netik/dc27_badge/hardware/dc27_badge_kicad/macrofab/README.md

###KiCad
***
**KiCad Libraries and documentation.**

This directory contains the files needed to generate manufacturing data from KiCad V4.0 and up for MacroFab, INC.

Please see the KiCad documentation at the [knowledge base](https://beta.macrofab.net/help/kpdink) on MacroFab, INC. for more information. 

***
**License Information**

This project is under the [Creative Commons Attribution-ShareAlike 4.0 International License](LICENSE.md). These files are provided with no warranty and should be used at your own risk. 

***
| Directory | Description |
|---|---|
| Footprints | Macrofab Footprint Libraries in Kicad format | 
| Schematics | Macrofab Schematic Symbol Libraries in Kicad format |

***
