netik/dc27_badge/hardware/pins_nRF52840DK.txt

NRF52840 DK board pin connections

This is the I/O pinout for the Nordic nRF52840 DK (development kit board).
There is also a Rigado BMD-340 EVAL board which is basically the same,
except it has the BMD-340 module mounted while the Nordic board just has
a bare nRF52840 chip mounted. Functionally they are identical.

Notes:

- Rigado and Nordic both have their own development boards. The Nordic
  one has the nRF52840 chip mounted directly on it. The Rigado board
  has the Rigado BMD-340 module on it instead. But both use the same
  headers and peripherals, so from a software perspective they should
  be identical.

- The nRF52840 has an extra bank of 16 GPIO pins, for a total of 48. These
  pins are accessed via a separate register block at offset 0x50000300. In
  ChibiOS these are referenced as IOPORT1 and IOPORT2. These are shown as two
  separate tables below.

- The connections shown below currently reflect only what's on the dev
  board. No extra peripherals have been configured yet.

- In order to allow peripherals to be able to select from all 48 pins for
  their I/O configuration, the pin select registers now have an extra field.
  The lowest 5 bits (0 to 4) select the pin number (0-31) and the 6th bit
  (bit 5) selects which port to use.

- Unlike the nRF52832 dev boards, the nRF52840 boards have a QSPI flash
  part connected to 6 pins (CS, clock and 4 I/O lines). The user guide
  document tays this is a 64Mb part. This actually means 64 megabits.
  That translates to 8MB. When properly configured, the nRF52840 allows
  code to be executed from the QSPI flash device. The QSPI is can also be
  memory-mapped. however the Nordic chip only allows a limited amount of
  address space to be used for this purpose which restricts the mapped
  range to about 128MB. This does not preculude the use of QSPI parts
  larger than that, since read access can still be performed via the
  QSPI controller inteface -- it just means that only 128MB may be
  visible via the memory-mapped method.

- The NRF52 chip has two places where you can connect crystals:

  1) Two dedicated pins for a 32MHz crystal
  2) The pins for P0.00 and P0.01, which can be used with a 32.768KHz
     crystal

  The chip has both a high speed clock and low speed clock. The 32MHz
  crystal is always required for the high speed clock. This same clock
  is used for the ARM CPU core and bus clocks. The low speed clock
  has three possible sources:

  1) Internal RC oscillator
  2) External 32.768KHz crystal
  3) Synthesized from 32MHz clock

  For certain applications, like if you use the ANT stack, you are
  required to use a 32.768KHz crystal for the low speed clock. The Nordic
  and Rigado reference boards come with this crystal too. However for
  our application (just using plain BLE), we technically don't need
  this extra crystal: we can make do with just the 32MHz crystal for
  the high speed clock. Note that the Rigado BMD-340 has the 32MHz
  crystal inside the module while the Nordic reference design has
  it on the main board instead.

  Joypads: There are two 5 input joypads. One on the tail section (aka
  the "A" stick) and one on the "business end" of the bomb, aka the
  "B" stick. Pushing down on either stick activates SELECT.

  All switches are tied to ~JOYPAD_INTR with Schottky diodes for low
  forward-voltage loss when activated. 

Port P0

NRF52840 pin desgination		Function
------------------------		--------
P0.00					XTAL (32.768KHz)
P0.01					XTAL (32.768KHz)
P0.02					Audio amp shutdown
P0.03					Touch CS
P0.04					Screen C/D
P0.05					UART_RTS
P0.06					UART_TX
P0.07					UART_CTS
P0.08					UART_RX
P0.09					NFC antenna
P0.10					NFC antenna
P0.11					BTN1 (~A:up)
P0.12					BTN2 (~A:down)
P0.13					LED1 / SD Card CS
P0.14					LED2 (Also routed to Shitty-add-on GPIO1)
P0.15					LED3 (Also routed to Shitty-add-on GPIO2)
P0.16					LED4
P0.17					QSPI CS
P0.18					RESET
P0.19					QSPI CLK
P0.20					QSPI DIO0
P0.21					QSPI DIO1
P0.22					QSPI DIO2
P0.23					QSPI DIO3
P0.24					BTN3 (~A:left)
P0.25					BTN4 (~A:right)
P0.26					I2C SCK
P0.27					I2C SDA
P0.28					SPI SCK (Screen)
P0.29					SPI MISO (Screen)
P0.30					SPI MOSI (Screen)
P0.31					Screen CS

Port P1

NRF52840 pin desgination		Function
------------------------		--------
P1.00					<unused>
P1.01					I2S SDOUT
P1.02					I2S SCK
P1.03					I2S LRCK
P1.04					I2S MCK
P1.05					<unused>
P1.06					SPI SCK (SD/touch)
P1.07					SPI MISO (SD/touch)
P1.08					SPI MOSI (SD/touch)
P1.09					BTN5 (~B:up)
P1.10					BTN6 (~B:down)
P1.11					BTN7 (~B:left)
P1.12					BTN8 (~B:right)
P1.13					BTN9 (~A:SELECT)
P1.14					BTN10 (~B:SELECT)
P1.15					~JOYPAD_INTR

For the ER-TFTM028-4 screen module

NRF52840 GPIO pin	ER-TFTM028-4 display/touch/SD module pin
-----------------	-----------------------------------------------------
P0.31			pin 23			(Screen chip select)
P0.30			pin 27			(SPI bus out -- screen)
P0.29			pin 28			(SPI bus in -- screen)
P0.28			pin 24			(SPI bus clock -- screen)
P1.08			pin 34			(SPI bus out -- SD/touch)
P1.07			pin 32			(SPI bus in -- SD/touch)
P1.06			pin 33			(SPI bus clock -- SD/touch)
GND (header P1)		pin 1 and 40		(Ground)
VDD (header P1)		pin 2			(3.3v VCC)
P0.04			pin 25			(Screen data/command select)
P0.03			pin 30			(Touch chip select)
P0.13			pin 35			(SD card chip select)
