netik/dc27_badge/artwork/evil bomb.jpg

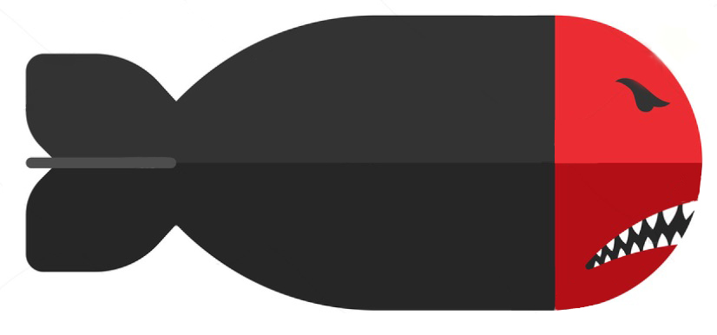
artwork/evil bomb.jpg
