netik/dc27_badge/artwork/idea board/1366668407.png

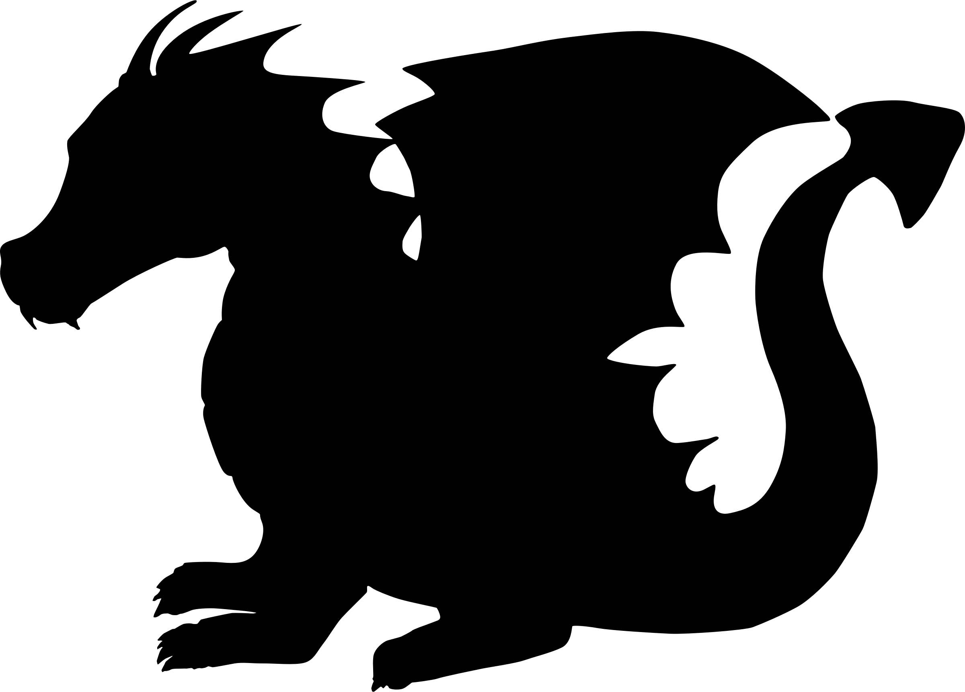
artwork/idea board/1366668407.png
