netik/dc27_badge/artwork/idea board/ancient-greek-trireme-black-and-whi_gg86042555.jpg

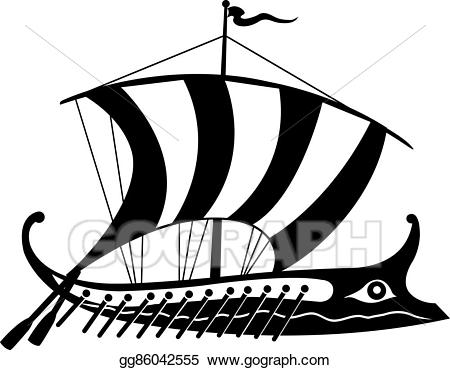
artwork/idea board/ancient-greek-trireme-black-and-whi_gg86042555.jpg
