netik/dc27_badge/artwork/idea board/Armies_and_Tactics__Ancient_Greek_Navies_-_YouTube.jpg

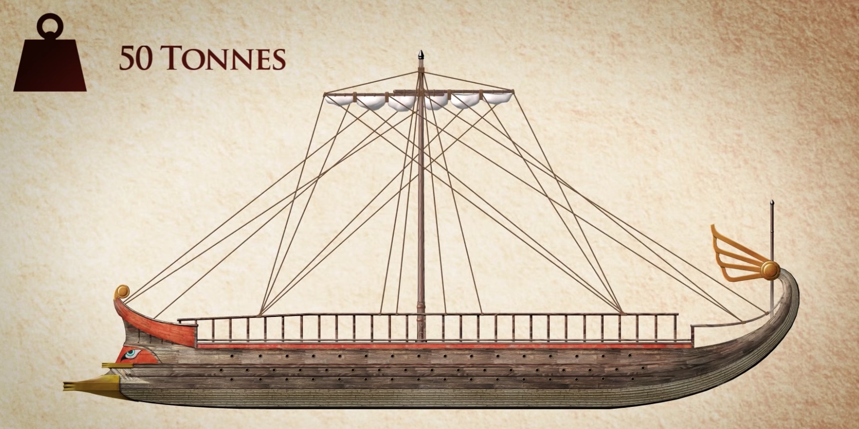
artwork/idea board/Armies_and_Tactics__Ancient_Greek_Navies_-_YouTube.jpg
