netik/dc27_badge/artwork/idea board/cool-skull-border-clip-art-skulls-thorn-vines-vector-decorative-border-stock-vector-skull-border-clip-art.jpg

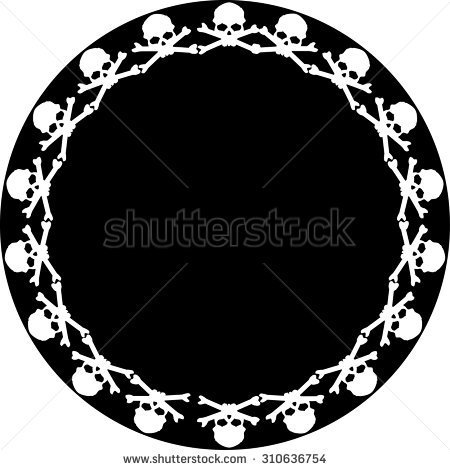
artwork/idea board/cool-skull-border-clip-art-skulls-thorn-vines-vector-decorative-border-stock-vector-skull-border-clip-art.jpg
