netik/dc27_badge/artwork/idea board/free-ships-silhouettes-vector-set.jpg

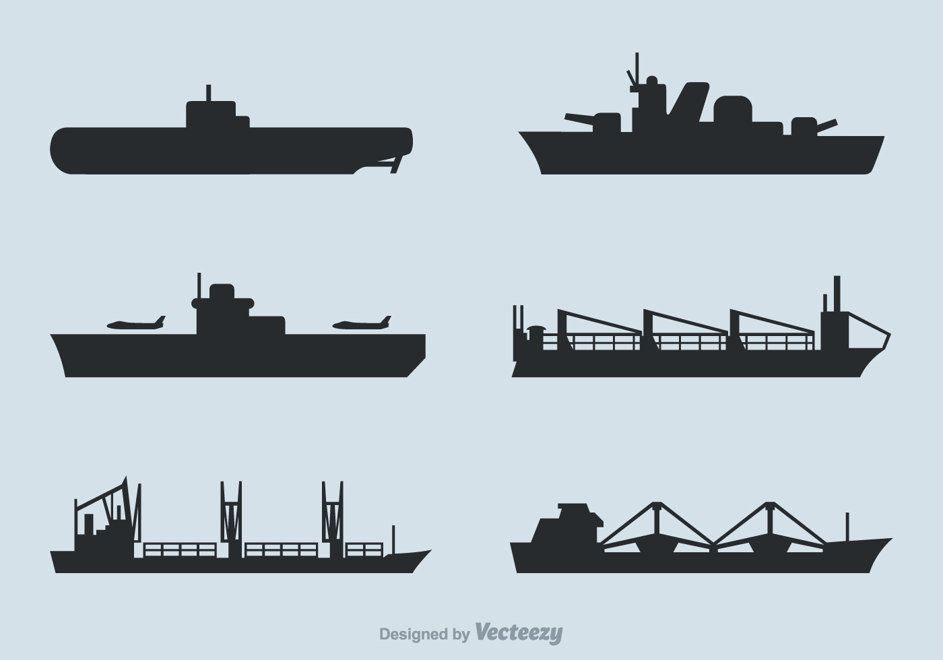
artwork/idea board/free-ships-silhouettes-vector-set.jpg
