netik/dc27_badge/artwork/idea board/images-3.png

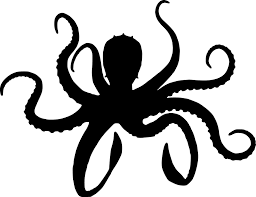
artwork/idea board/images-3.png
