netik/dc27_badge/artwork/idea board/images.jpg

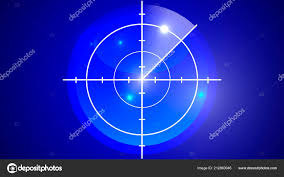
artwork/idea board/images.jpg
