netik/dc27_badge/artwork/idea board/submarine-dribbble.jpg

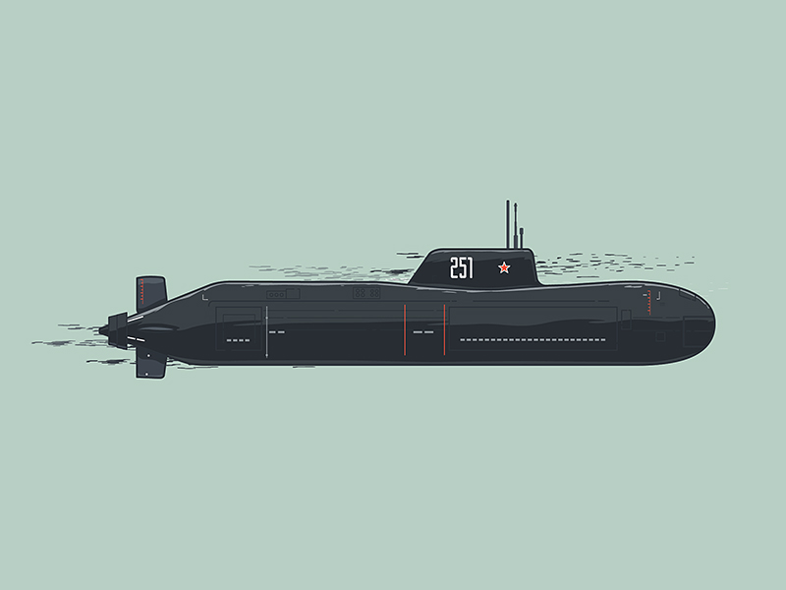
artwork/idea board/submarine-dribbble.jpg
