netik/dc27_badge/artwork/wiley-no bomb.jpg

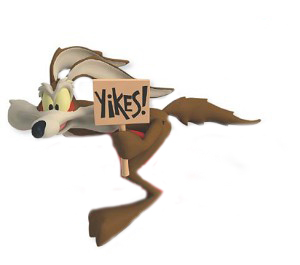
artwork/wiley-no bomb.jpg
