netik/dc27_badge/artwork/wiley.jpg

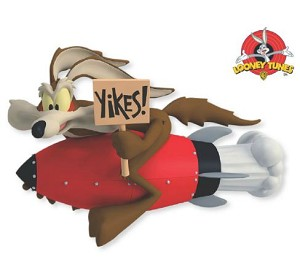
artwork/wiley.jpg
