netik/dc27_badge/Kickstarter/production schedule/production schedule.001.jpeg

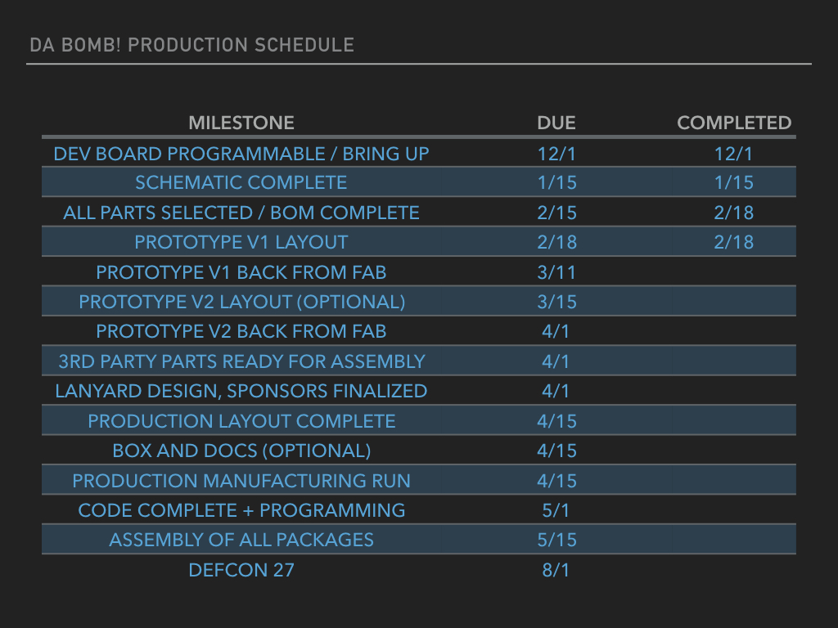
Kickstarter/production schedule/production schedule.001.jpeg
