netik/dc27_badge/Kickstarter/rendering.png

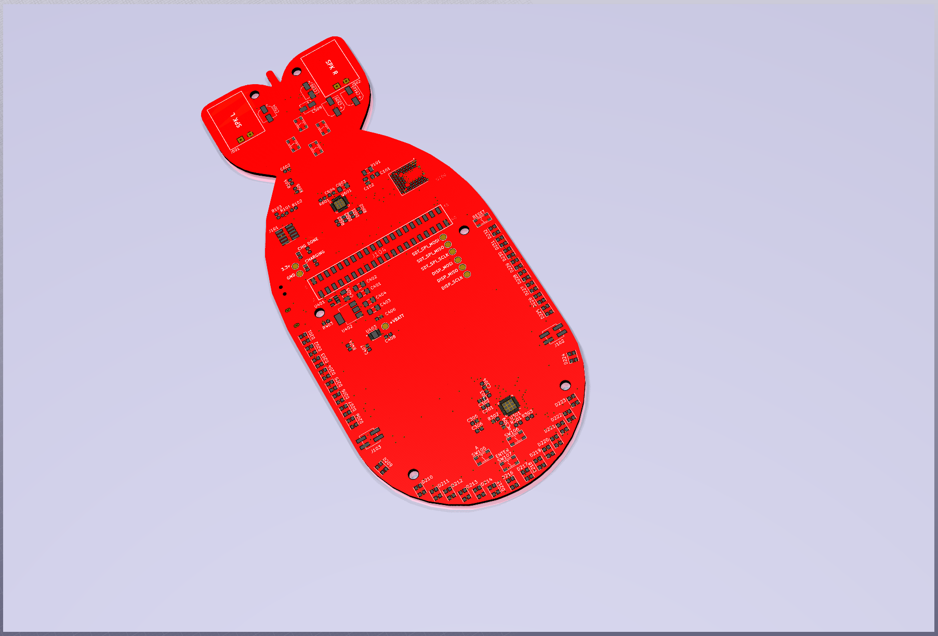
Kickstarter/rendering.png
