netik/dc27_badge/software/sd_card/jpg/doom/doom0005.jpg

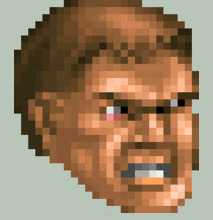
software/sd_card/jpg/doom/doom0005.jpg
