netik/dc27_badge/software/sd_card/jpg/doom/doom0037.jpg

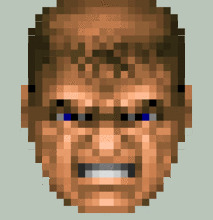
software/sd_card/jpg/doom/doom0037.jpg
