netik/dc27_badge/software/sd_card/jpg/doom/doom0043.jpg

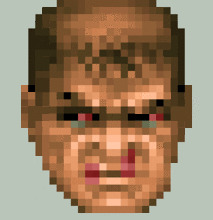
software/sd_card/jpg/doom/doom0043.jpg
