netik/dc27_badge/software/sd_card/jpg/doom/doom0062.jpg

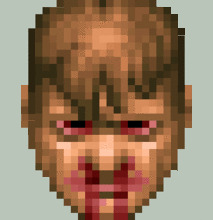
software/sd_card/jpg/doom/doom0062.jpg
