netik/dc27_badge/software/sd_card/jpg/doom/doom0073.jpg

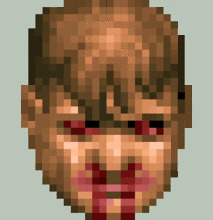
software/sd_card/jpg/doom/doom0073.jpg
