netik/dc27_badge/software/sd_card/jpg/doom/doom0083.jpg

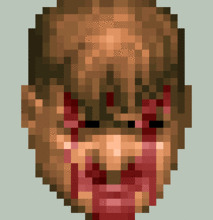
software/sd_card/jpg/doom/doom0083.jpg
