netik/dc27_badge/software/sd_card/jpg/doom/doom0093.jpg

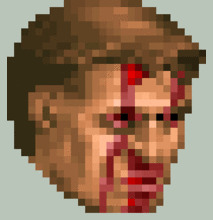
software/sd_card/jpg/doom/doom0093.jpg
