netik/dc27_badge/software/sd_card/jpg/fwupdate.jpg

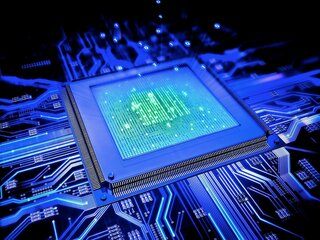
software/sd_card/jpg/fwupdate.jpg
