netik/dc27_badge/software/sd_card/jpg/undrattk.jpg

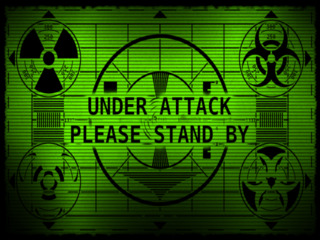
software/sd_card/jpg/undrattk.jpg
