netik/dc27_badge/software/sd_card/photos_src/alert.tif

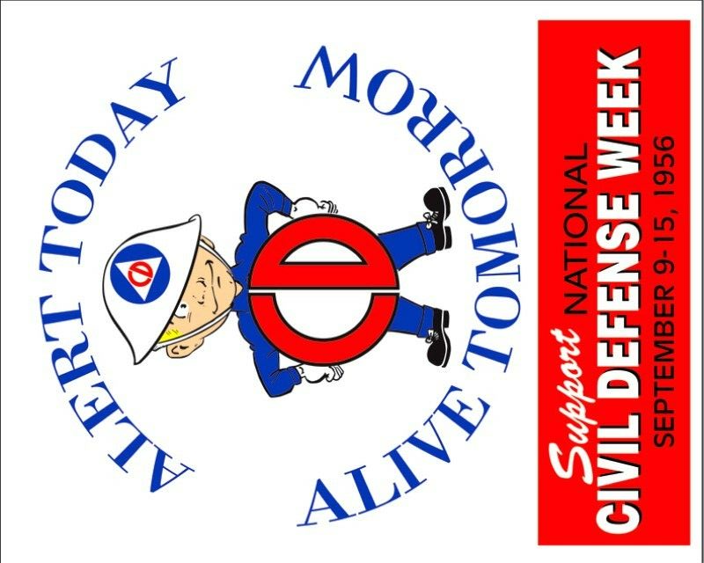
software/sd_card/photos_src/alert.tif
