netik/dc27_badge/software/sd_card/photos_src/civildef.tif

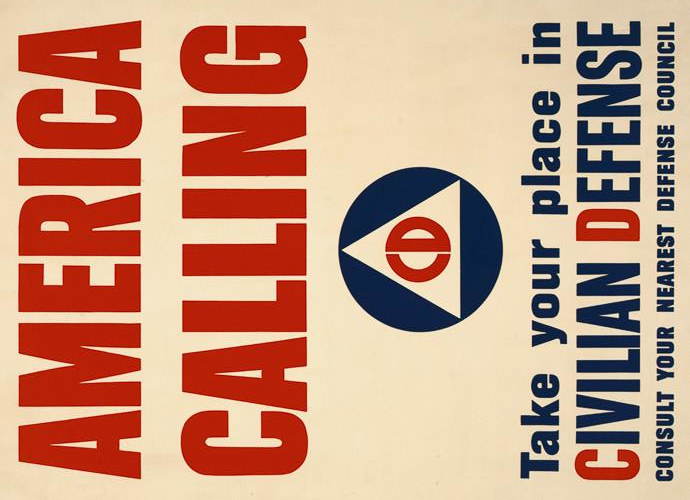
software/sd_card/photos_src/civildef.tif
