netik/dc27_badge/software/sd_card/photos_src/comic.tif

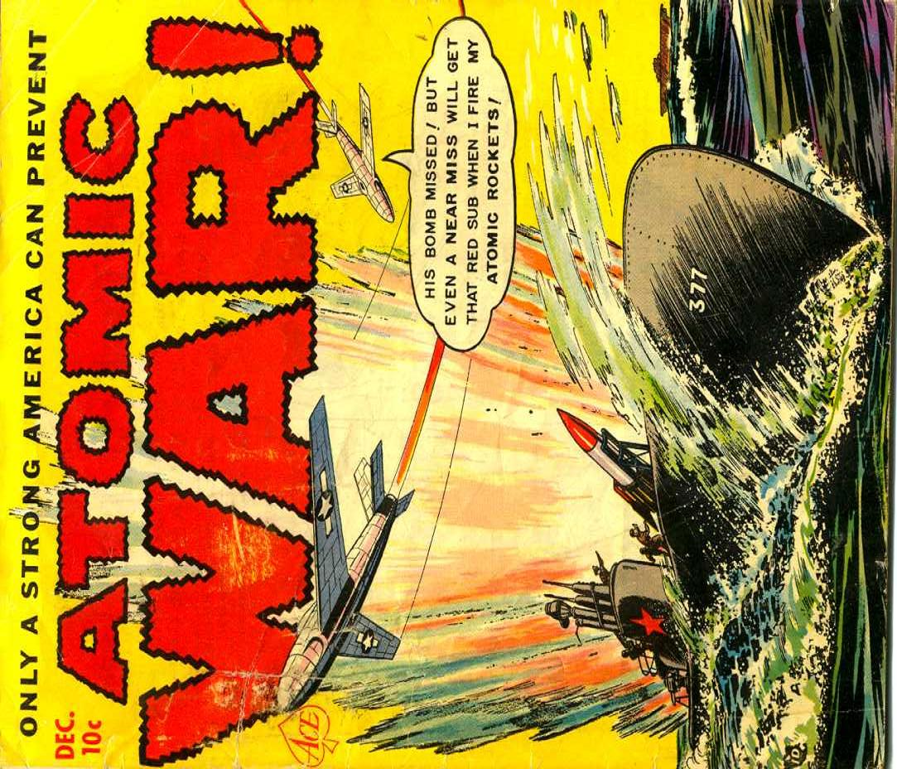
software/sd_card/photos_src/comic.tif
