netik/dc27_badge/software/sd_card/photos_src/dixiecup.tif

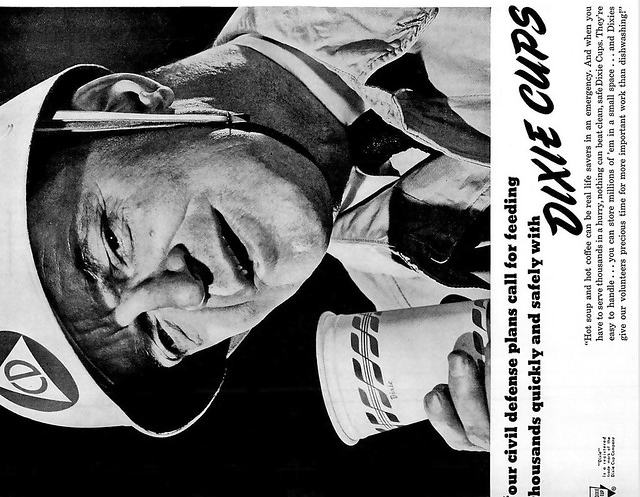
software/sd_card/photos_src/dixiecup.tif
