netik/dc27_badge/software/sd_card/photos_src/fallout.tif

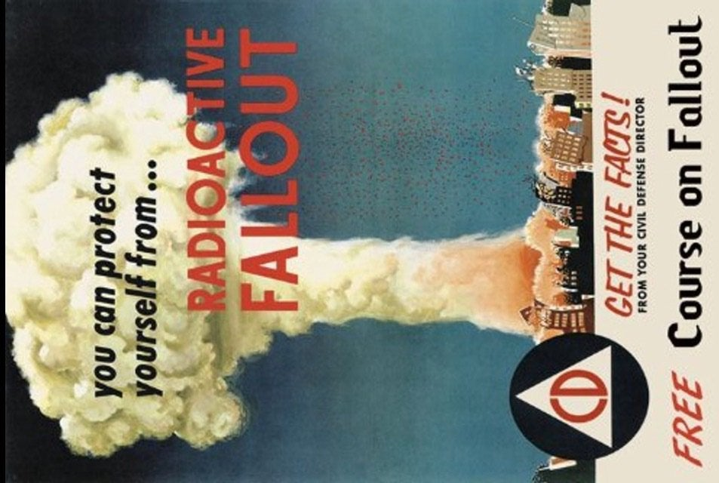
software/sd_card/photos_src/fallout.tif
