netik/dc27_badge/software/sd_card/photos_src/lowpot.jpg

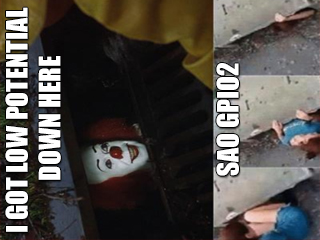
software/sd_card/photos_src/lowpot.jpg
