netik/dc27_badge/software/sd_card/photos_src/protect.tif

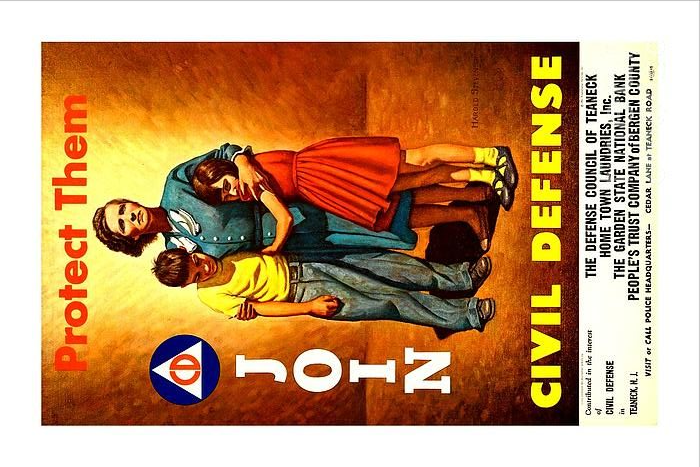
software/sd_card/photos_src/protect.tif
