netik/dc27_badge/software/sd_card/photos_src/saodrake.jpg

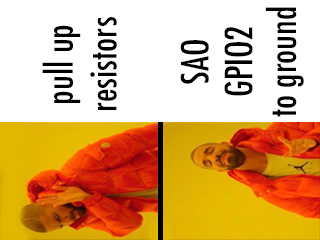
software/sd_card/photos_src/saodrake.jpg
