netik/dc27_badge/software/sd_card/photos_src/shelter.tif

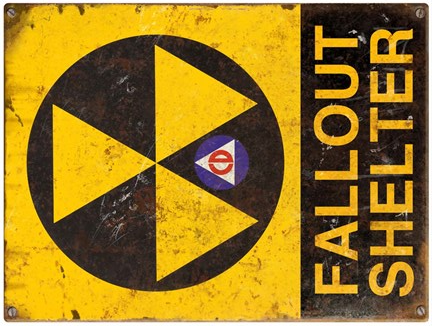
software/sd_card/photos_src/shelter.tif
