netik/dc27_badge/software/sd_card/photos_src/staydown.tif

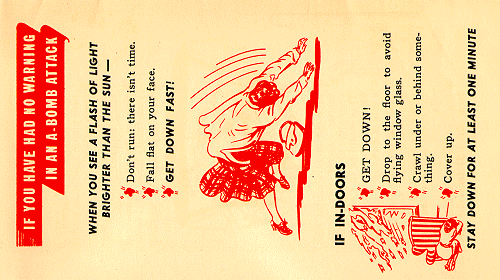
software/sd_card/photos_src/staydown.tif
