netik/dc27_badge/software/sd_card/tif/game/map-01.tif

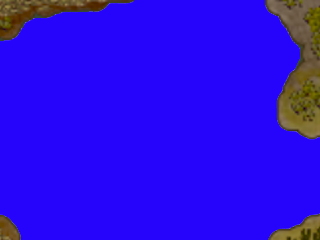
software/sd_card/tif/game/map-01.tif
