netik/dc27_badge/software/sd_card/tif/game/map-02.tif

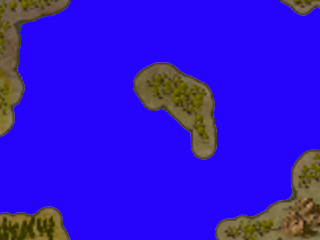
software/sd_card/tif/game/map-02.tif
