netik/dc27_badge/software/sd_card/tif/game/map-04.tif

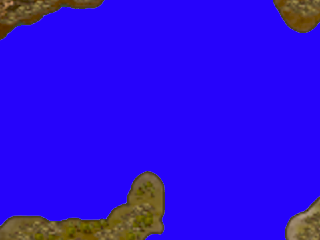
software/sd_card/tif/game/map-04.tif
