netik/dc27_badge/software/sd_card/tif/game/map-11.tif

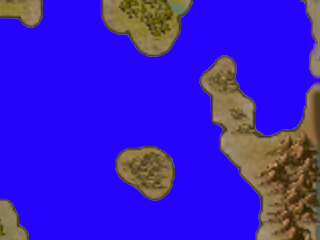
software/sd_card/tif/game/map-11.tif
