netik/dc27_badge/software/sd_card/tif/game/seabattle-4x4-map.tif

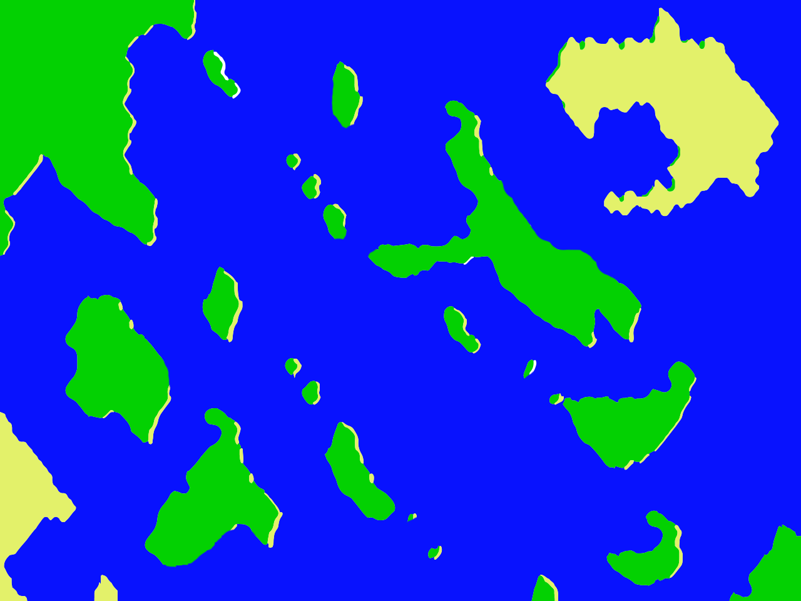
software/sd_card/tif/game/seabattle-4x4-map.tif
