netik/dc27_badge/software/sd_card/tif/images/credits.tif

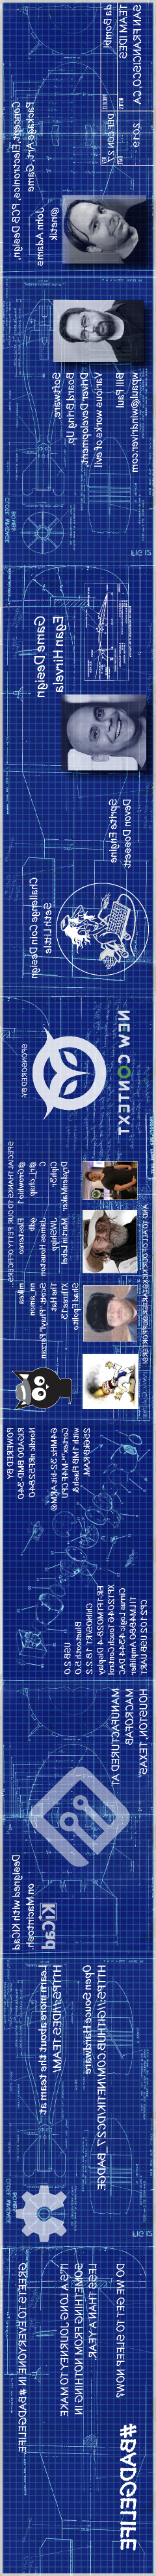
software/sd_card/tif/images/credits.tif
