netik/dc27_badge/software/sd_card/tif/images/invite.tif

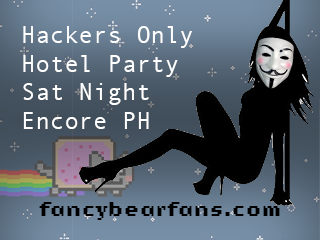
software/sd_card/tif/images/invite.tif
