netik/dc27_badge/software/sd_card/tif/images/missing.tif

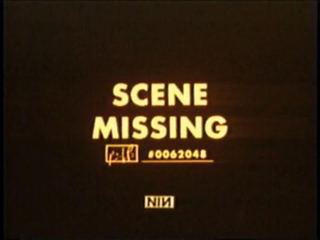
software/sd_card/tif/images/missing.tif
