netik/dc27_badge/software/sd_card/tif/images/nophotos.tif

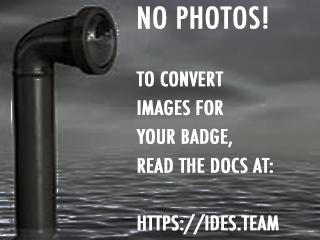
software/sd_card/tif/images/nophotos.tif
