netik/dc27_badge/software/sd_card/tif/images/sponsor.tif

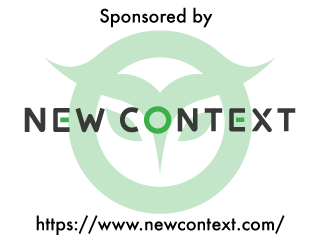
software/sd_card/tif/images/sponsor.tif
