netik/dc27_badge/software/sd_card/tif/images/unlock.tif

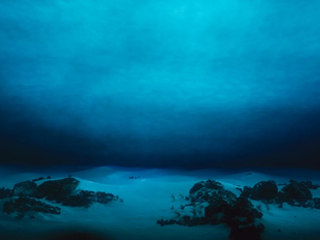
software/sd_card/tif/images/unlock.tif
