netik/dc27_badge/artwork/evilbomb_outline.dxf

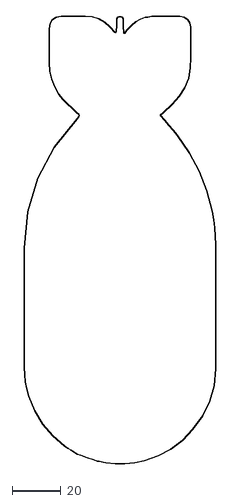
[picture p79: CAD file, 2019-03-21]
artwork/evilbomb_outline.dxf
79.1 x 184.5
