netik/dc27_badge/artwork/evilbomb-face.dxf

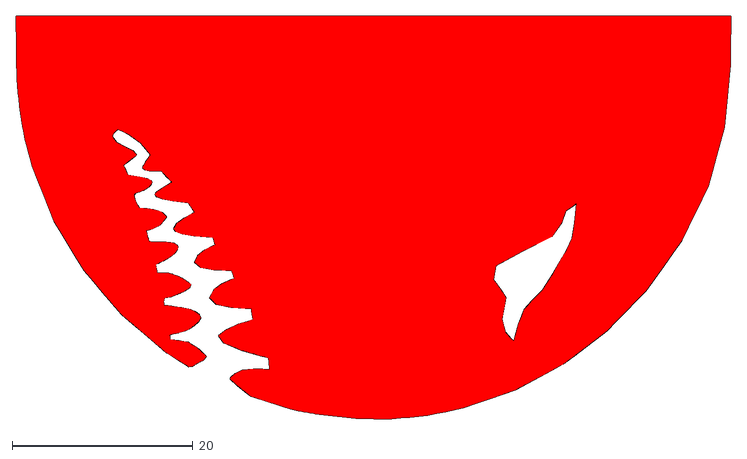
[picture p80: CAD file, 2019-03-21]
artwork/evilbomb-face.dxf
78.9 x 44.5
