netik/dc27_badge/software/sd_card/photos_src/howto.tif

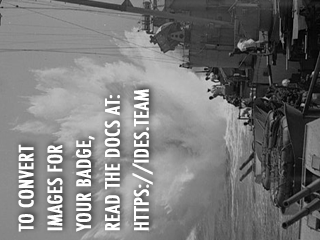
software/sd_card/photos_src/howto.tif
