netik/dc27_badge/software/firmware/todo.txt

Things currently completed:

- OS bootstrap
- uGFX porting
- FatFs porting
- Nordic SoftDevice (BLE stack) porting
- BLE radio GAP + L2CAP support
- BLE GATTS support
- Application framework from DC25 badge porting
- Bus master SPI controller driver
- QSPI controller driver
- I2S controller driver
- 320x240 display support
- SD card support
- Resistive touch controller support
- QSPI flash support (for 8MB MXIC flash chip on dev board)
- NRF52840 on-board flash support
- audio playback API
- Chat app 
- Firmware update app
- Firmware updater support
- Support for extra GPIO bank on NRF52840 chip
- joypad/button framework
- Put SD card/touch on a separate SPI bus (leave screen on SPIM4)
- I2C support (tested good)
- Video app
- Extend button support to handle extra buttons requested by John
- Music player app
- BLE GATTC support
- Setup app
- Geiger counter app
- RF spectrum display app
- I2C support
- LED array support
- Infocom Z-Machine support
- OTA firmware update support
- Game app

Things still to do:

- BLE pairing PIN support
