netik/dc27_badge/(threads)

Thread 1 (2019-03-21):

BMD340 should not have copper fill under the antenna

netik, 2019-03-21:
Remove PCB fill

netik, 2019-03-21:
Updated Keepout to "also keepout copper fills". Seems to have worked and verified on gerbers.

Closed 2019-03-21.

Thread 11 (2019-03-21):

CP2102 TX/RX Lights do not function at all.

netik, 2019-03-21:
I've checked the schematic and data sheet twice but I don't see any reason why these LEDs should not be functional.

The LEDs are facing the right way, the pins are correct, but GPIO0/1 on the CP2102 does nothing.

Will put this on a scope later and see if we're getting anything resembling voltage coming off the CP2102.

I feel like the GPIO lines might need configuring but the datasheet says they should show TX and RX status by default. What gives?

netik, 2019-03-21:
Goddammit:
https://www.silabs.com/community/interface/forum.topic.html/cp2102n-qfn24_rxttx-JCui

Apparently these GPIO pins need to be conf'd

netik, 2019-03-21:
There are standalone tools that we can give to MF or whomever...

https://www.silabs.com/products/mcu/programming-options

netik, 2019-03-21:
And this looks like the one for cp2102...
https://www.silabs.com/community/interface/forum.topic.html/cp2102n_command_line-s0yh

netik, 2019-04-26:
The Xpress Configuratior solves this problem but we need a way to do this in manufacturing

Closed 2019-06-06.

Thread 2 (2019-03-21):

There's no ON label on the switch. Add one. Towards fin is ON.

netik, 2019-03-21:
Fix this on Kicad Layout

netik, 2019-03-21:
Label added.

Closed 2019-03-21.

Thread 4 (2019-03-21):

~RESET line is not configured on new CPUs

netik, 2019-03-21:
Bill will figure out how to configure this register (PSELRESET0/PSELRESET1)

netik, 2019-03-21:
Bill figured this out, but now it needs to go into a script for programming in production.

Bill, what's the magic command?

Bill-Paul, 2019-03-23:
There is no magic command. There is only Zuul.
No, seriously: there is now some code in the main() function of the firmware that will check if the UICR->PSELRESET[] fields are set correctly, and if it'll reflash the UICR on the fly to fix it.

The only catch is that you have to reboot the target once after the update for the change to take effect (the CPU only samples UICR->PSELRESET[] at start-up). So basically the procedure is:

1) Flash the firmware
2) Boot up the badge
3) Watch for the message below:

SYSTEM START
Reset event (0x4): Soft reset
Nordic Semiconductor nRF52840 Variant: AAAA RAM: 256KB Flash: 1024KB
Device ID: DA788BE24D13B5BB
Compact kernel mode
Reset pin not configured, programming... Done.                 <----------
Priority levels 8
[...]

4) Optional: power cycle the board and check that the reset button now works.

Bill-Paul, 2019-03-23:
Fixed by commit 5664404ae0a65e35376aef35dee8ed855b5eee38

Closed 2019-03-23.

Thread 5 (2019-03-21):

U403 doesn't have a valid center ground

netik, 2019-03-21:

netik, 2019-03-21:
The thermal pad, and overall layout of u403 is no good. Do it again.

netik, 2019-04-07:
No Longer valid, U403 removed and fuel gauge removed.

Closed 2019-04-07.

Thread 6 (2019-03-21):

Entire fuel gauge circuit is completely wrong. Remove or retry.

netik, 2019-03-21:

netik, 2019-04-07:
Duplicate, removed.

Closed 2019-04-07.

Thread 7 (2019-03-21):

Charge lights are reversed (or labels on board are reversed)

netik, 2019-03-21:

Closed 2019-04-12.

Thread 22 (2019-04-26):

LED Brightness (progress bar) doesn't draw properly at startup of app-setup

netik, 2019-04-26:
This is a strange ugfx problem that I can't track down.

Closed 2019-05-08.

Thread 32 (2019-05-08):

Rotate LED-Sign Fonts and display 90 degress

netik, 2019-05-08:
The user will have the badge hanging from their neck most of the time by the fins.

Rotate the LED font so it scrolls up (towards the header pins) instead of L to R.

I'm busy with the game or I'd fix this.

Closed 2019-07-18.

Thread 37 (2019-06-07):

Sometimes the idle timer in app-setup fires way, way too early.

netik, 2019-06-07:
it is randomly exiting and this sucks.

netik, 2019-06-11:
this was a very dumb bug. fixed

Closed 2019-06-11.

Thread 49 (2019-07-23):

Rotate badge issues

netik, 2019-07-23:
Bug from LC:

"rotate badge .... doesn't (and the badge remains vertical) ... but led sign is horizontal with 'rotate badge' unchecked and vertical with it checked"

The only place we implemented rotate badge was in led sign, so I think this is a wontfix.

netik, 2019-07-23:
We're going to just change the text here to say something line "ROTATE SIGN" instead of rotate badge. I know that's not the right solution but it is all we can do right now.

Closed 2019-07-23.

Thread 51 (2019-07-23):

LEDs don't stay off when asked to stay off.

netik, 2019-07-23:
Bug from LC:

"any time leds are used (play music, credits, ble counter) while the led pattern is 'off' (and brightness is > 0) it will leave the leds on from the audio"

Closed 2019-07-23.

Thread 52 (2019-07-23):

Vertical vs Horizontal LED Sign

netik, 2019-07-23:
Bug from LC:

"one last one I found: the vertical led font doesn't have any character spacing, while the horizontal font does"
---

We can't really fix this because the SD card has been written out already, Can offer this later as a fix, very low priority.
