netik/dc27_badge/hardware/dc27_badge_kicad/DC27-badge.pdf

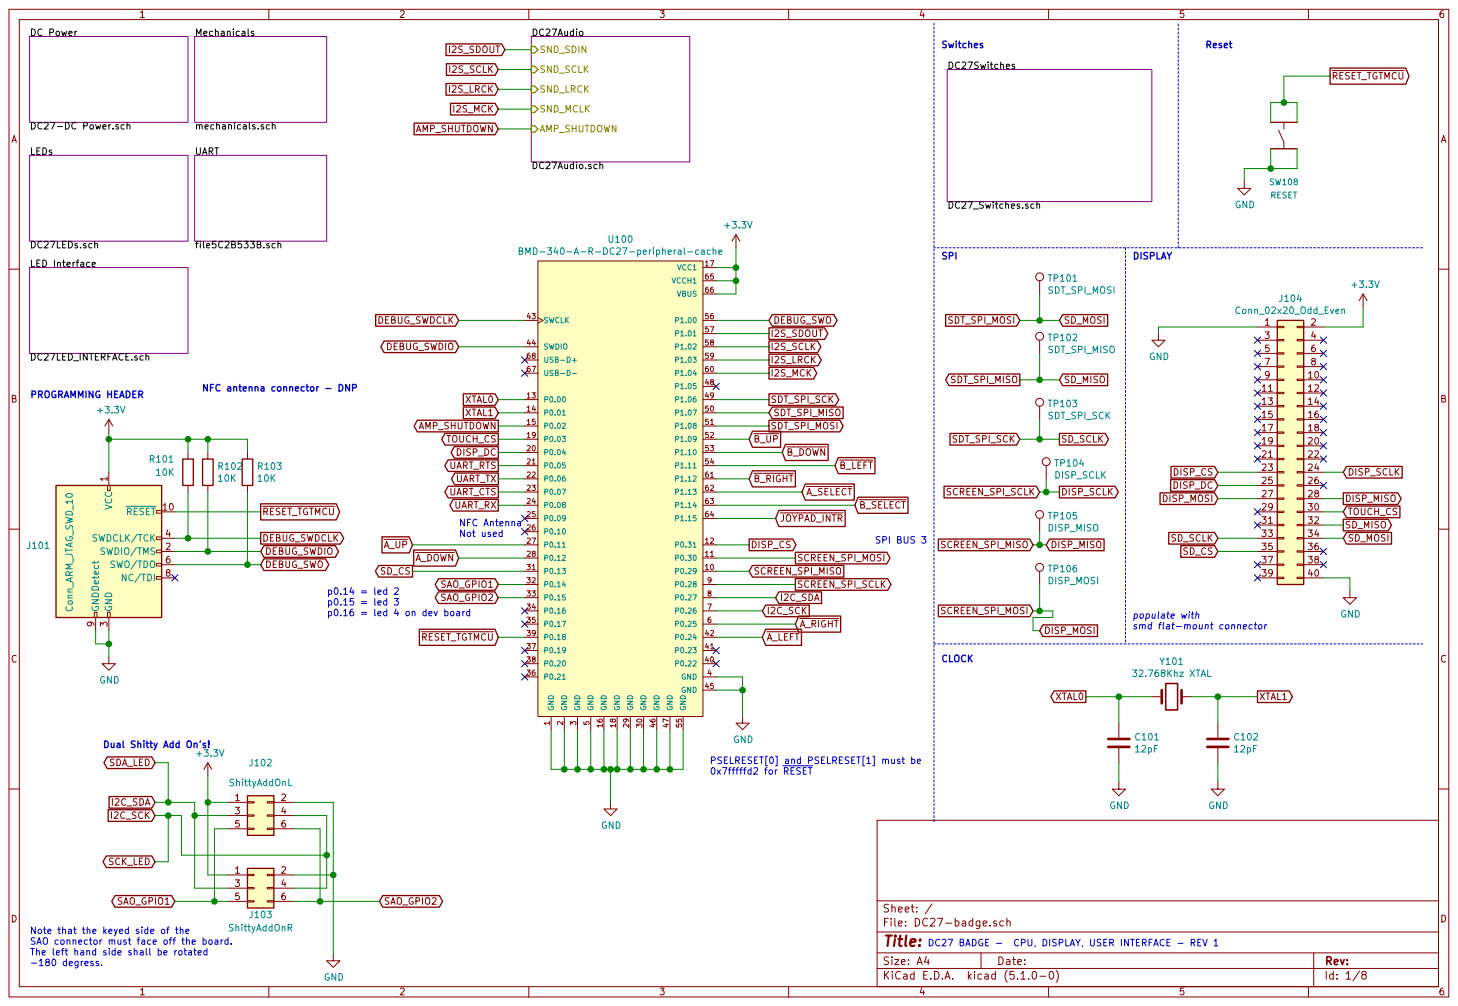
[picture p86: page 1]

SW108 RESET B_LEFT NFC antenna connector - DNP UART

5 P1.07 50 P1.08 51 P1.09 52 P1.10 53 P1.11 54 GND 55 P1.00 56 P1.01 57 P1.02 58 P1.03 59 P0.25 6 P1.04 60 P1.12 61 P1.13 62 P1.14 63 P1.15 64 VCCH1 65 VBUS 66 USB-D- 67 USB-D+ 68 P0.26 7 P0.27 8 P0.28 9 U100 BMD-340-A-R-DC27-peripheral-cache +3.3V
file5C2B533B.sch

3 GND 30 P0.13 31 P0.14 32 P0.15 33 P0.16 34 P0.17 35 P0.21 36 P0.19 37 P0.20 38 P0.18 39 GND 4 P0.22 40 P0.23 41 P0.24 42 SWCLK 43 SWDIO 44 GND 45 GND 46 GND 47 P1.05 48 P1.06 49 GND

p0.16 = led 4 on dev board AMP_SHUTDOWN

1 RESET 10 SWDIO/TMS 2 GND

3 SWDCLK/TCK 4 SWO/TDO 6 NC/TDI 8 GNDDetect 9

smd flat-mount connector RESET_TGTMCU

Dual Shitty Add Ons!
SDA_LED

PSELRESET[0] and PSELRESET[1] must be

File: DC27-badge.sch Sheet: /
Id: 1/8 Title:

Note that the keyed side of the SAO connector must face off the board. The left hand side shall be rotated

DC27 BADGE - CPU, DISPLAY, USER INTERFACE - REV 1

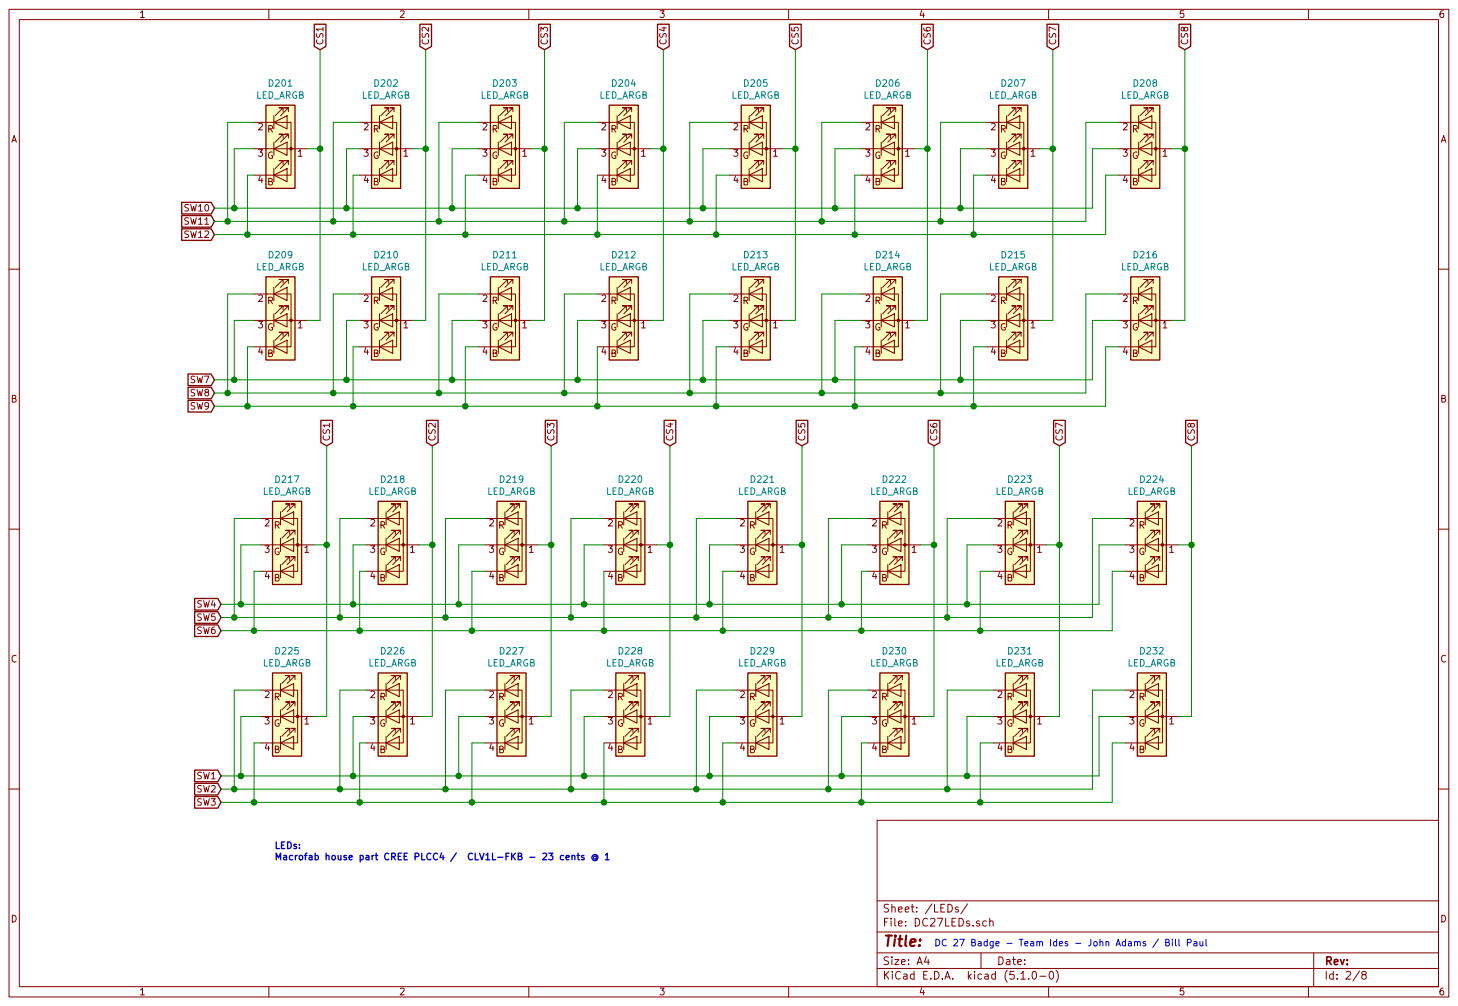
[picture p87: page 2]

Id: 2/8 Title: File: DC27LEDs.sch Sheet: /LEDs/ CS1 BG
LED_ARGB

DC 27 Badge - Team Ides - John Adams / Bill Paul

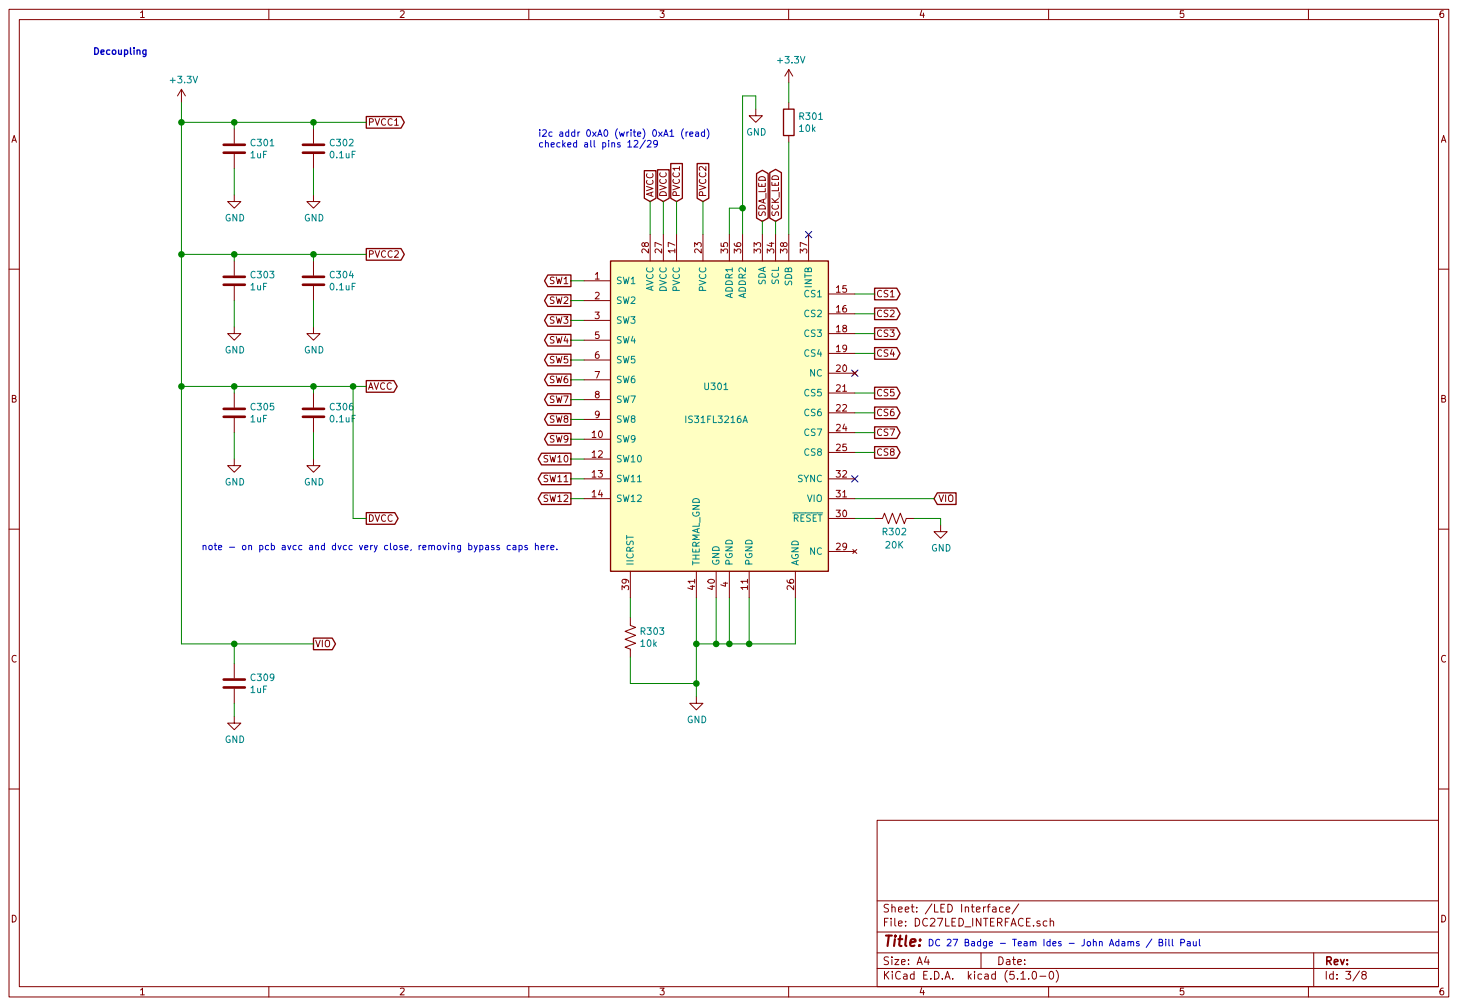
[picture p88: page 3]

note - on pcb avcc and dvcc very close, removing bypass caps here.

DC 27 Badge - Team Ides - John Adams / Bill Paul

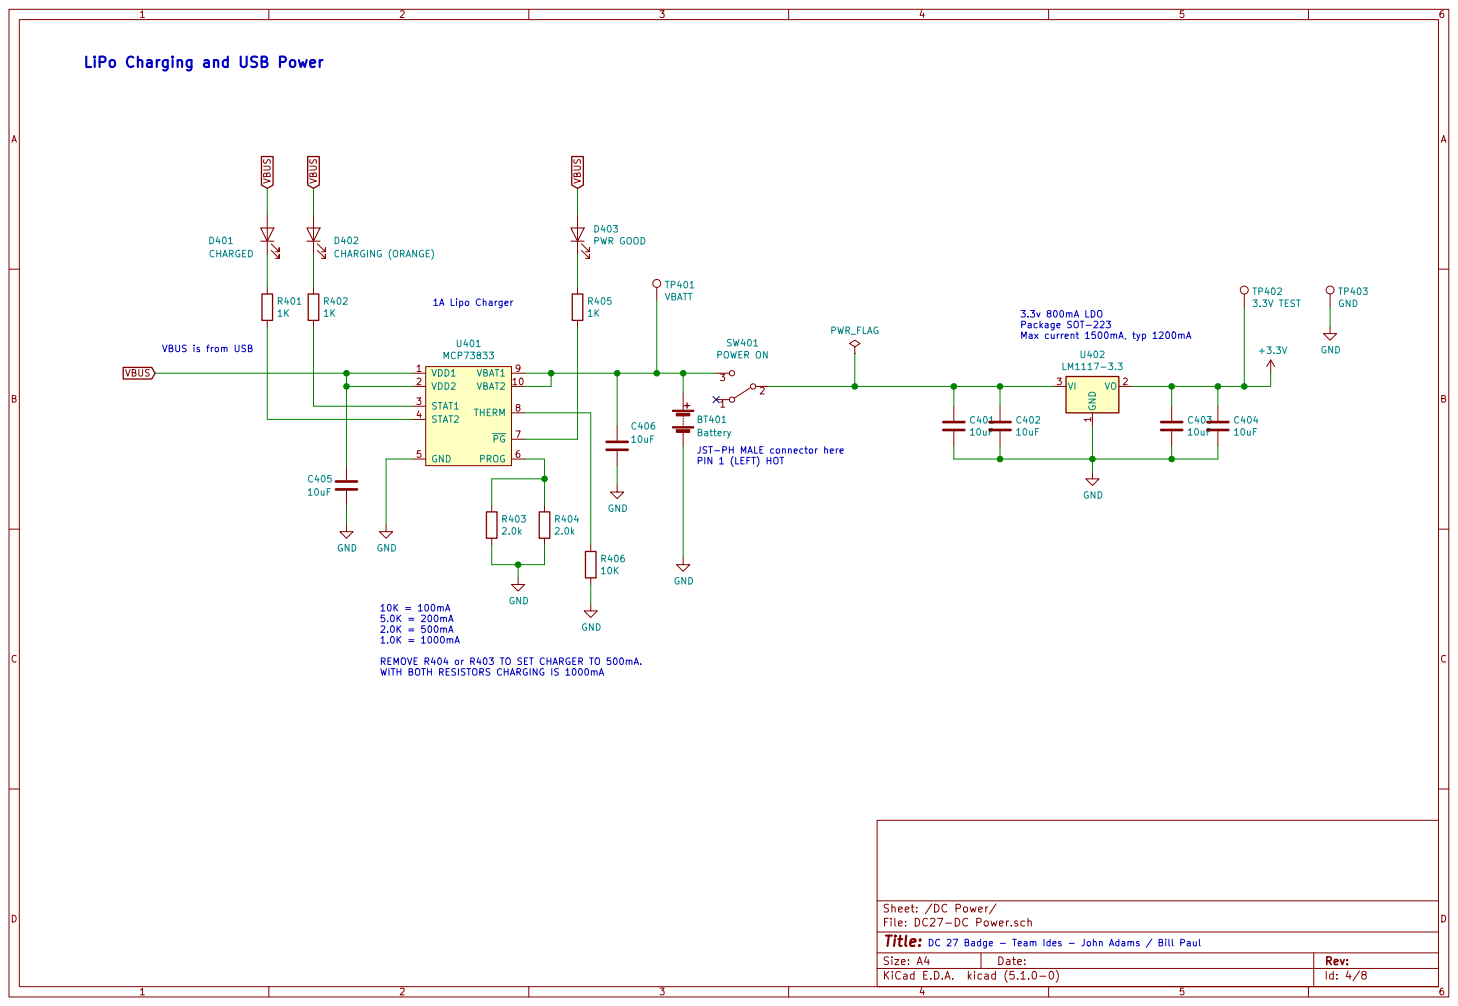
[picture p89: page 4]

LiPo Charging and USB Power

Id: 4/8 Title: File: DC27-DC Power.sch Sheet: /DC Power/

DC 27 Badge - Team Ides - John Adams / Bill Paul

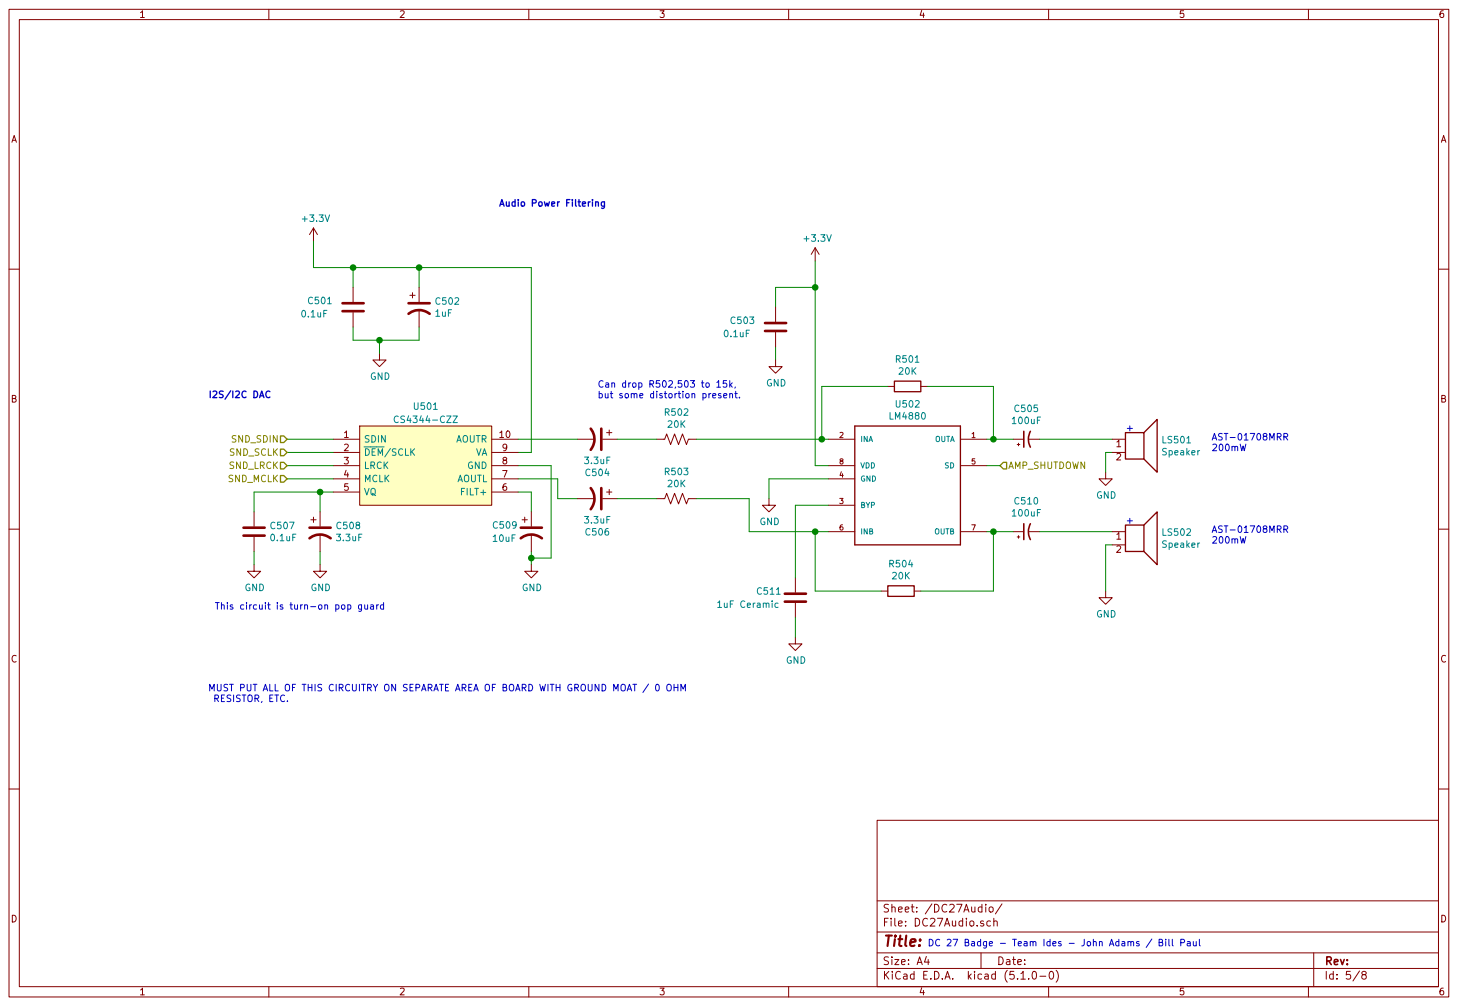
[picture p90: page 5]

Can drop R502,503 to 15k,
but some distortion present.

20K MUST PUT ALL OF THIS CIRCUITRY ON SEPARATE AREA OF BOARD WITH GROUND MOAT / 0 OHM

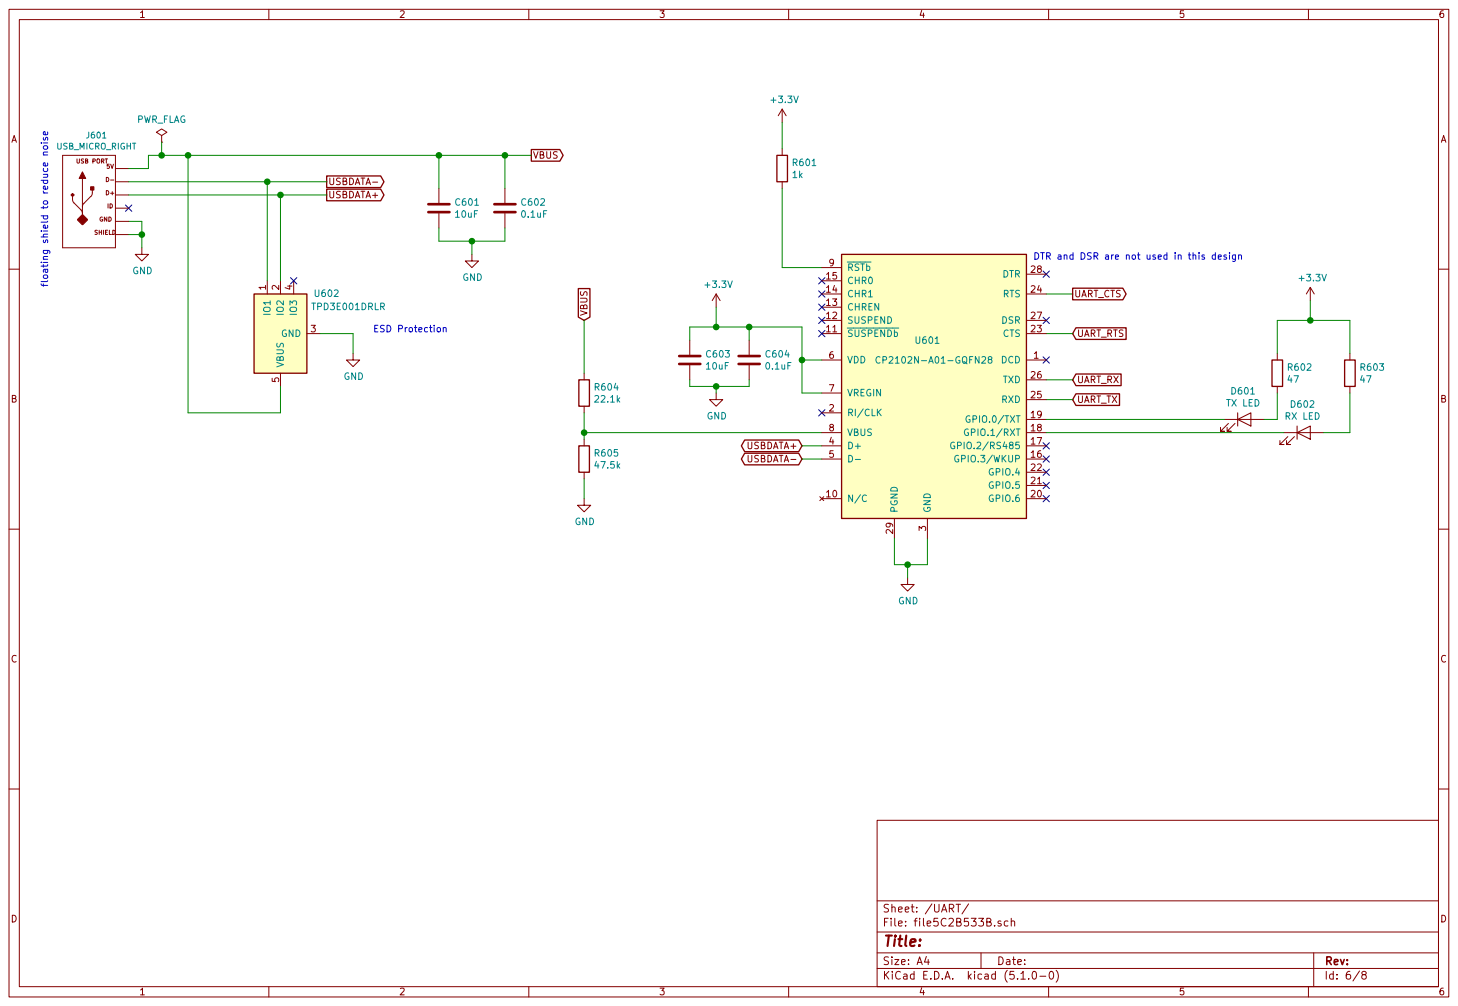
[picture p91: page 6]

3 D+ 4 D- 5 VDD 6 VREGIN 7 VBUS 8 RSTb 9 U601 CP2102N-A01-GQFN28 GND

Id: 6/8 Title: File: file5C2B533B.sch Sheet: /UART/

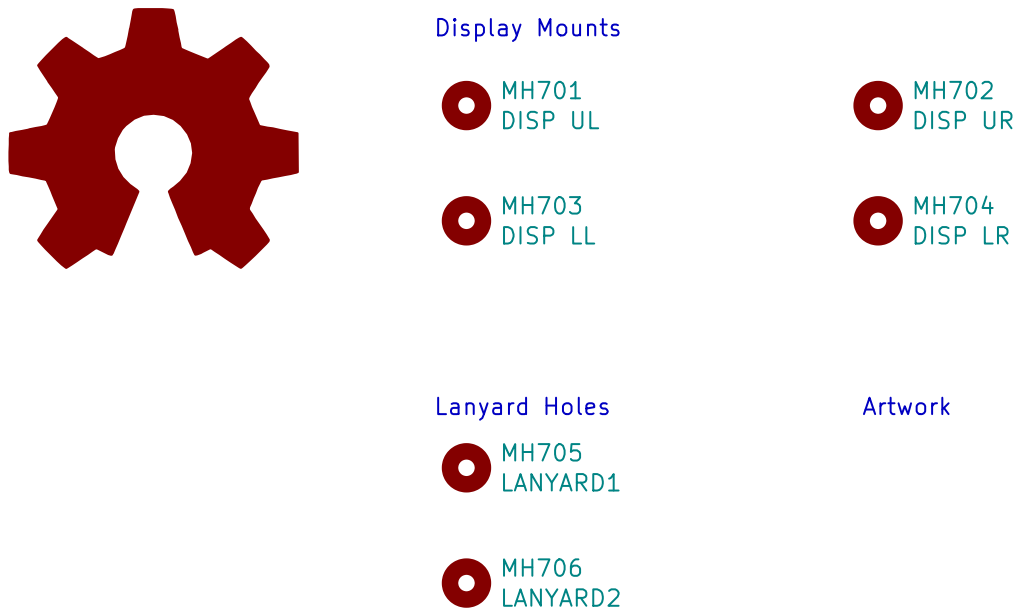
[picture p92: page 7]

Id: 7/8 Title: File: mechanicals.sch Sheet: /Mechanicals/

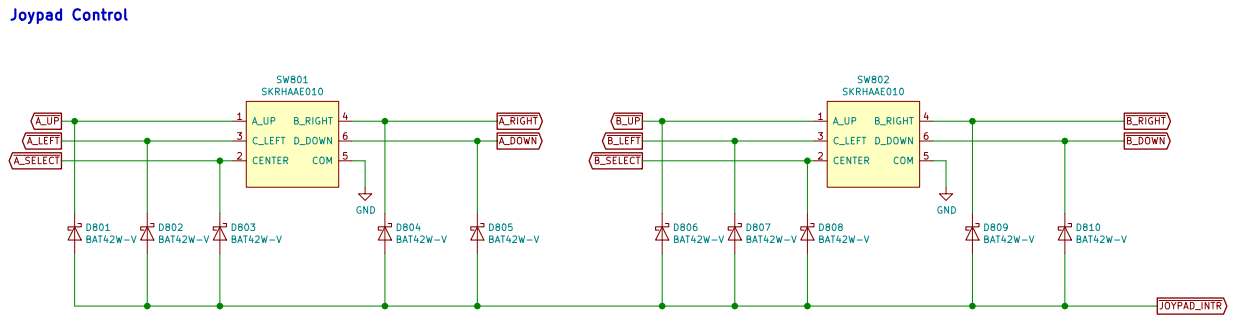
[picture p93: page 8]
