netik/dc27_badge/hardware/dc27_badge_kicad/pdfs/DC27-badge-B.Cu.pdf

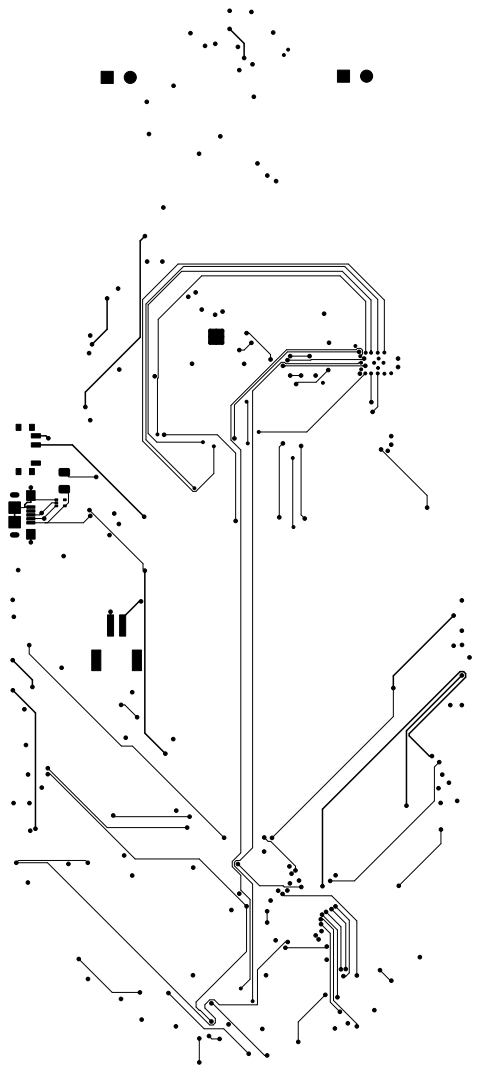
[picture p94: page 1]
