netik/dc27_badge/hardware/dc27_badge_kicad/pdfs/DC27-badge-B.Mask.pdf

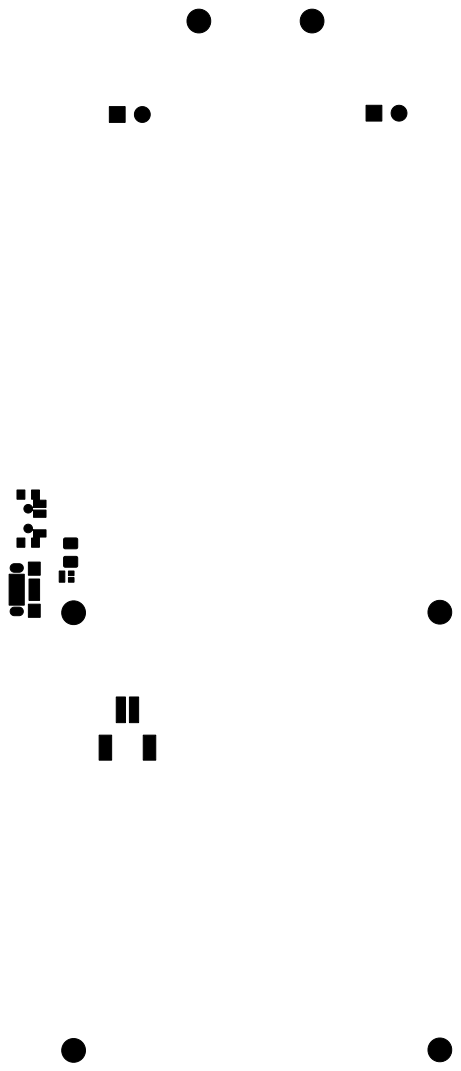
[picture p95: page 1]
