netik/dc27_badge/hardware/dc27_badge_kicad/pdfs/DC27-badge-B.Paste.pdf

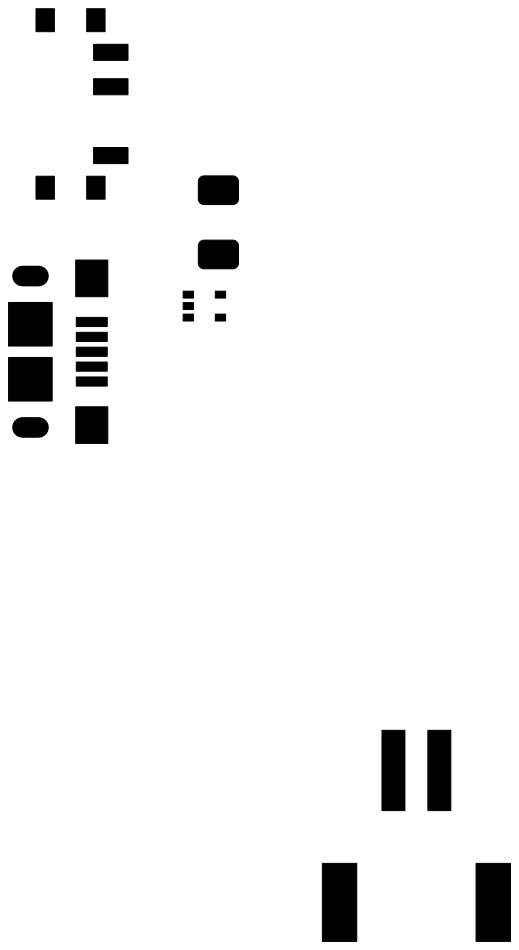
[picture p96: page 1]
