netik/dc27_badge/hardware/dc27_badge_kicad/pdfs/DC27-badge-B.SilkS.pdf

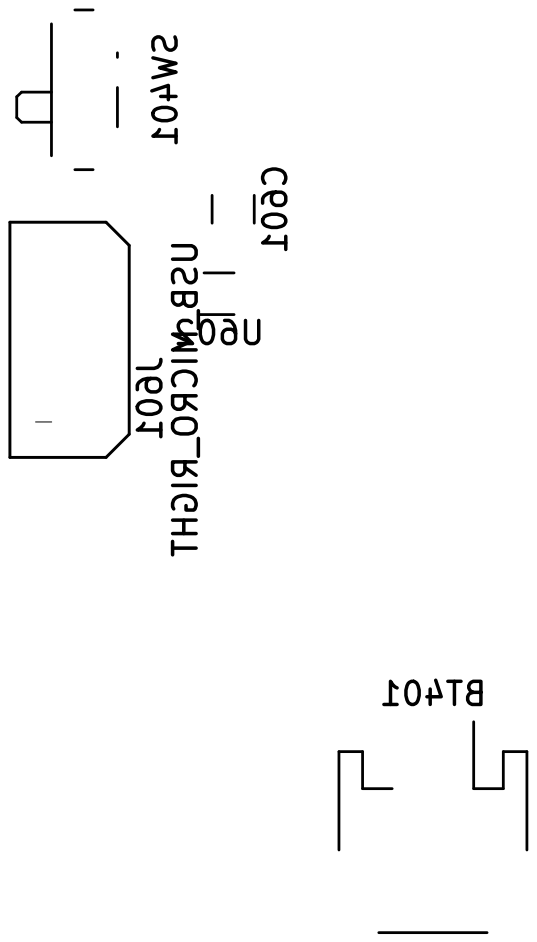
[picture p97: page 1]
