netik/dc27_badge/hardware/dc27_badge_kicad/pdfs/DC27-badge-Edge.Cuts.pdf

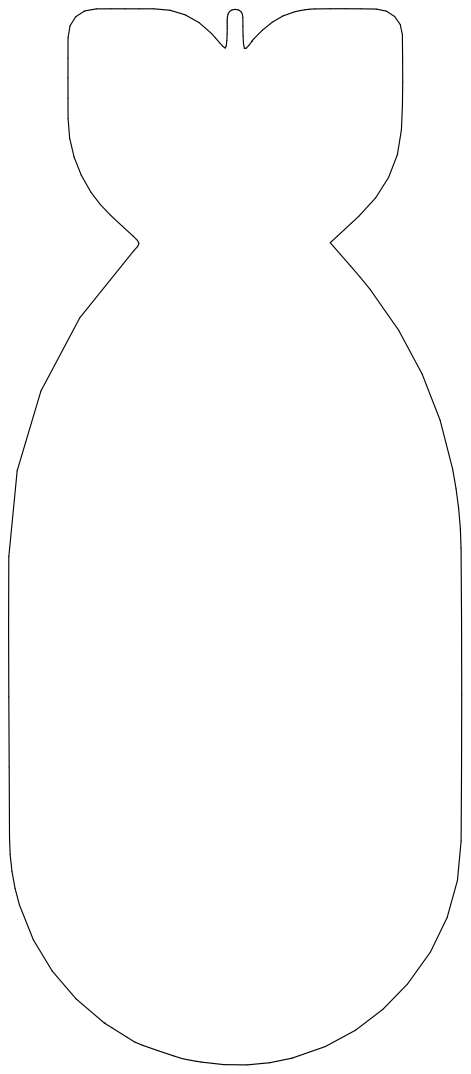
[picture p98: page 1]
