netik/dc27_badge/hardware/dc27_badge_kicad/pdfs/DC27-badge-F.Cu.pdf

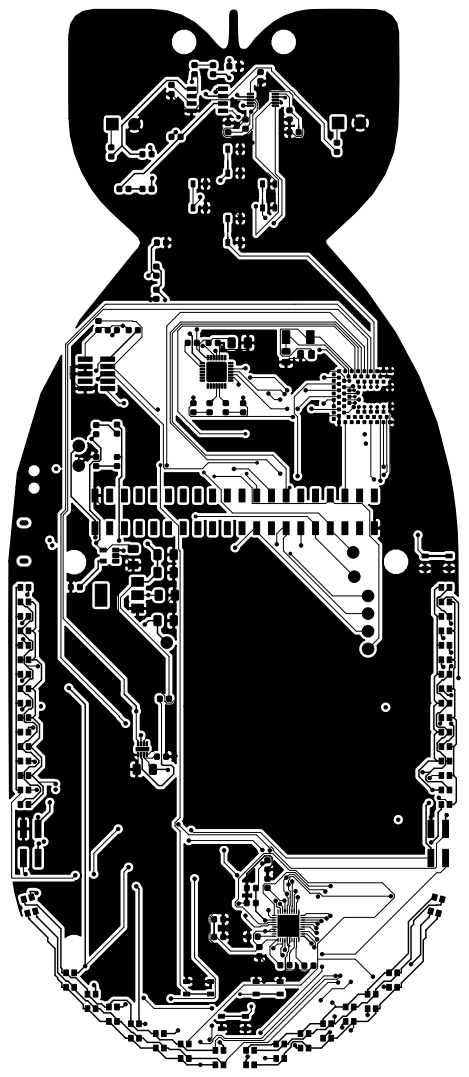
[picture p99: page 1]
