netik/dc27_badge/hardware/dc27_badge_kicad/pdfs/DC27-badge-F.Mask.pdf

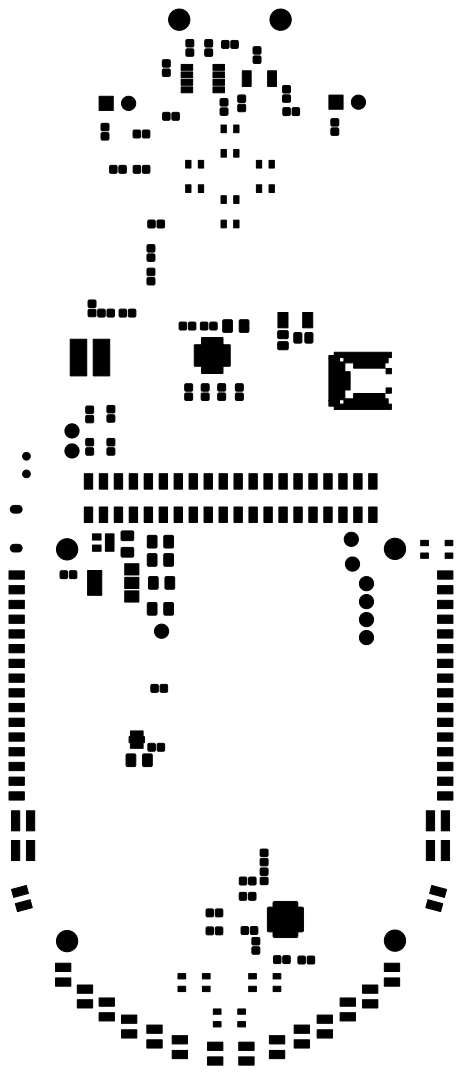
[picture p100: page 1]
