netik/dc27_badge/hardware/dc27_badge_kicad/pdfs/DC27-badge-F.Paste.pdf

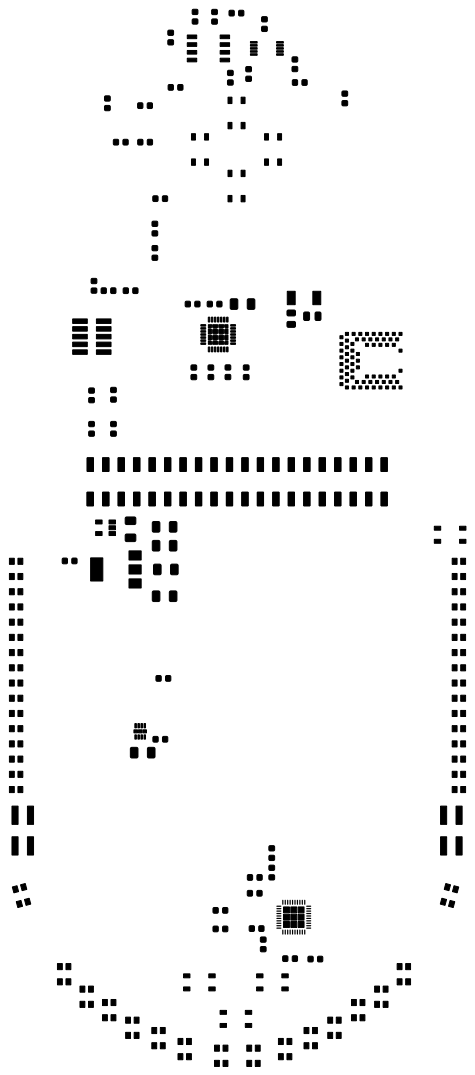
[picture p101: page 1]
