netik/dc27_badge/hardware/dc27_badge_kicad/pdfs/DC27-badge-F.SilkS.pdf

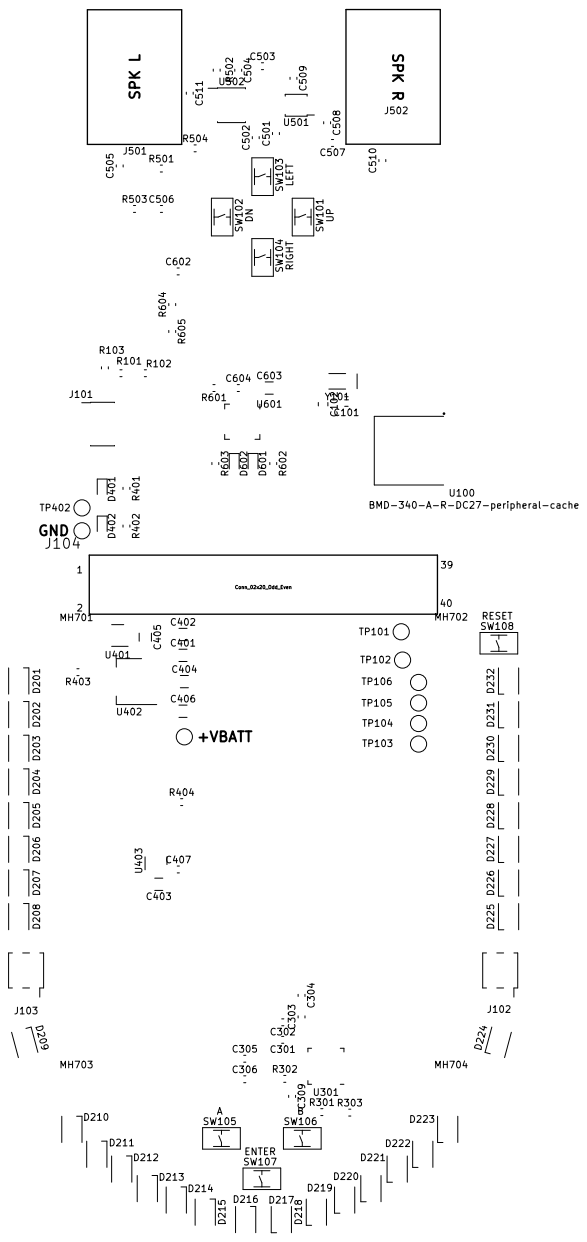
[picture p102: page 1]
