netik/dc27_badge/hardware/dc27_badge_kicad/pdfs/DC27-badge-GND.pdf

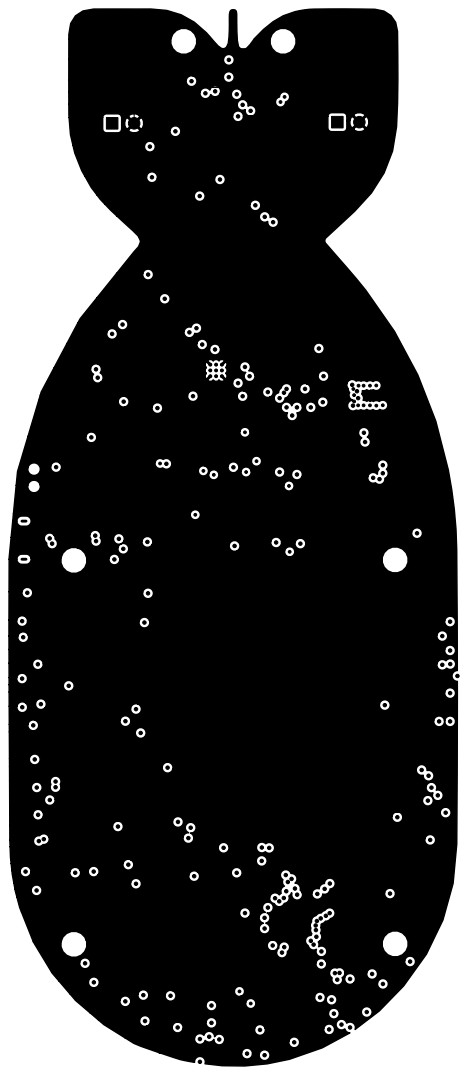
[picture p103: page 1]
