netik/dc27_badge/hardware/dc27_badge_kicad/pdfs/DC27-badge-PWR.pdf

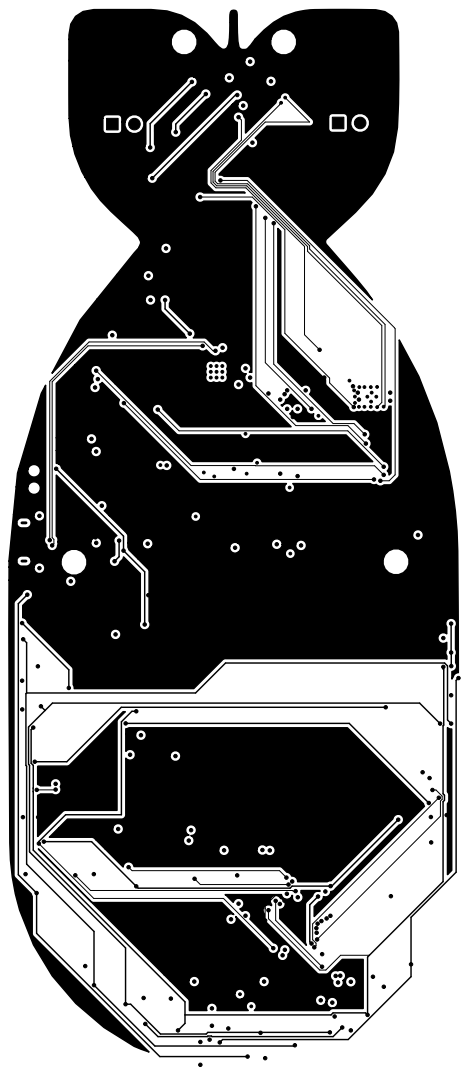
[picture p104: page 1]
