netik/dc27_badge/(list of files, drawings)

Other design files:
hardware/DC27-SAO/DC27-SAO.dsn
hardware/dc27_badge_kicad/DC27-badge.dsn
