netik/dc27_badge/hardware/dc27_badge_kicad/gerbers/FINAL/DC27-badge.kicad_pcb

## KiCad design hardware/dc27_badge_kicad/gerbers/FINAL/DC27-badge.kicad_pcb (2019-05-28)

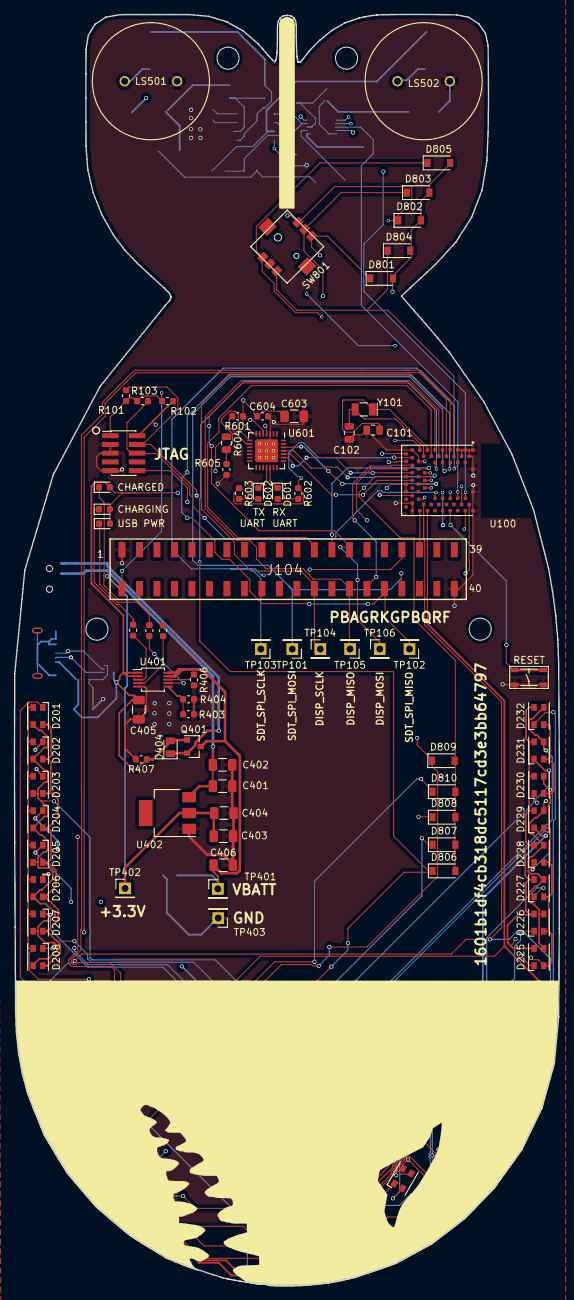
[picture p105: board DC27-badge.kicad_pcb from above]

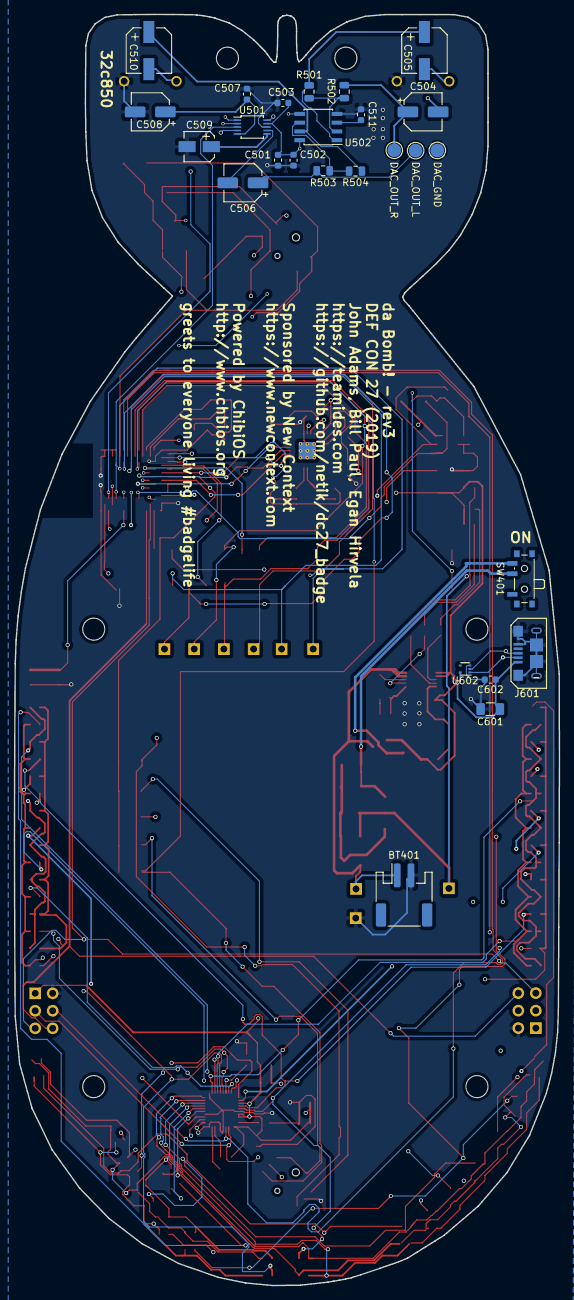
[picture p106: board DC27-badge.kicad_pcb from below]

Board: 4 copper layers, 79.1 x 184.5 mm, 141 parts (26 on the bottom side), 98 nets.

Parts:
BT401: Battery; JST_PH_S2B-PH-SM4-TB_1x02-1MP_P2.00mm_Horizontal
C101, C102: 12pF; C_0805_2012Metric
C301, C303, C305, C309, C502: 1uF; C_0603_1608Metric
C302, C304, C306, C501, C503, C507, C602, C604: 0.1uF; C_0603_1608Metric
C401, C402, C403, C404, C405, C406, C601, C603: 10uF; C_1206_3216Metric
C504, C506, C508: 3.3uF; CP_Elec_5x5.3
C505, C510: 100uF; MF_Passives-CP6.3MM
C509: 10uF; MF_Passives-CP4MM
C511: 1uF Ceramic; C_0603_1608Metric
D201, D202, D203, D204, D205, D206, D207, D208, D209, D210, D211, D212, D213, D214, D215, D216, D217, D218, D219, D220, D221, D222, D223, D224, D225, D226, D227, D228, D229, D230, D231, D232: LED_ARGB; LED_Cree-PLCC4_3.2x2.8mm_CCW
D401: CHARGED; D_0603_1608Metric
D402: CHARGING (ORANGE); D_0603_1608Metric
D403: PWR GOOD; D_0603_1608Metric
D404: SD0805S020S1R0; D_0805_2012Metric
D601: TX LED; D_0603_1608Metric
D602: RX LED; D_0603_1608Metric
D801, D802, D803, D804, D805, D806, D807, D808, D809, D810: BAT42W-V; D_SOD-123
H701: Bomb Face; bombface-moved
J101: Conn_ARM_JTAG_SWD_10; PinHeader_2x05_P1.27mm_Vertical_SMD
J102: ShittyAddOnL; PinSocket_2x03_P2.54mm_Vertical
J103: ShittyAddOnR; PinSocket_2x03_P2.54mm_Vertical
J104: Conn_02x20_Odd_Even; SAMTEC-SSM-120-X-DV
J601: USB_MICRO_RIGHT; MF_Connectors-MICROUSB-RIGHT
LS501, LS502: Speaker; AST-01708-MRR
MH701: DISP UL; MountingHole_3.2mm_M3_DIN965
MH702: DISP UR; MountingHole_3.2mm_M3_DIN965
MH703: DISP LL; MountingHole_3.2mm_M3_DIN965
MH704: DISP LR; MountingHole_3.2mm_M3_DIN965
MH705: LANYARD1; MountingHole_3.2mm_M3_DIN965
MH706: LANYARD2; MountingHole_3.2mm_M3_DIN965
Q401: FDN360P; SOT-23
R101, R102, R103, R406, R407: 10K; R_0603_1608Metric
R301, R303: 10k; R_0603_1608Metric
R302, R501, R502, R503, R504: 20K; R_0805_2012Metric
R401, R402, R405: 1K; R_0603_1608Metric
R403, R404: 2.0k; R_0603_1608Metric
R601: 1k; R_0603_1608Metric
R602, R603: 47; R_0603_1608Metric
R604: 22.1k; R_0805_2012Metric
R605: 47.5k; R_0603_1608Metric
SW108: RESET; MF_Switches-TACT4.2MM
SW401: POWER ON; SW_SPDT_PCM12
SW801, SW802: SKRHAAE010
TP101: SDT_SPI_MOSI; PinHeader_1x01_P2.54mm_Vertical
TP102: SDT_SPI_MISO; PinHeader_1x01_P2.54mm_Vertical
TP103: SDT_SPI_SCK; PinHeader_1x01_P2.54mm_Vertical
TP104: DISP_SCLK; PinHeader_1x01_P2.54mm_Vertical
TP105: DISP_MISO; PinHeader_1x01_P2.54mm_Vertical
TP106: DISP_MOSI; PinHeader_1x01_P2.54mm_Vertical
TP401: VBATT; PinHeader_1x01_P2.54mm_Vertical
TP402: 3.3V TEST; PinHeader_1x01_P2.54mm_Vertical
TP403: GND; PinHeader_1x01_P2.54mm_Vertical
TP501: DAC_OUT_R; TestPoint_Pad_D2.0mm
TP502: DAC_OUT_L; TestPoint_Pad_D2.0mm
TP503: DAC_GND; TestPoint_Pad_D2.0mm
U100: BMD-340-A-R-DC27-peripheral-cache; RIGADO_BMD-340-A-R
U301: IS31FL3736-QFLS4-TR; QFN-40-1EP_5x5mm_P0.4mm_EP3.6x3.6mm
U401: MCP73833; MSOP-10_3x3mm_P0.5mm
U402: LM1117-3.3; SOT-223
U501: CS4344-CZZ; TSSOP-10_3x3mm_Pitch0.5mm
U502: LM4880; SOIC-8_3.9x4.9mm_P1.27mm
U601: CP2102N-A01-GQFN28; QFN-28-1EP_5x5mm_P0.5mm_EP3.35x3.35mm_ThermalVias
U602: TPD3E001DRLR; SOT-553
Y101: 32.768Khz XTAL; Crystal_SMD_MicroCrystal_CC7V-T1A-2Pin_3.2x1.5mm

Connections:
AMP_SHUTDOWN: U100.15, U502.5
AVCC: C301.1, C302.1, C303.1, C304.1, C305.1, C306.1, C309.1, C403.1, C404.1, C501.1, C502.1, C503.1, C603.1, C604.1, J101.1, J102.1, J103.1, J104.2, R101.1, R102.1, R103.1, R301.1, R601.1, R602.1, R603.1, TP402.1, U100.17, U100.65, U100.66, U301.17, U301.23, U301.27, U301.28, U301.31, U402.2, U501.9, U502.8, U601.6, U601.7
CS1: D201.1, D209.1, D217.1, D225.1, U301.15
CS2: D202.1, D210.1, D218.1, D226.1, U301.16
CS3: D203.1, D211.1, D219.1, D227.1, U301.18
CS4: D204.1, D212.1, D220.1, D228.1, U301.19
CS5: D205.1, D213.1, D221.1, D229.1, U301.21
CS6: D206.1, D214.1, D222.1, D230.1, U301.22
CS7: D207.1, D215.1, D223.1, D231.1, U301.24
CS8: D208.1, D216.1, D224.1, D232.1, U301.25
DEBUG_SWDCLK: J101.4, R101.2, U100.43
DEBUG_SWDIO: J101.2, R102.2, U100.44
DEBUG_SWO: J101.6, R103.2, U100.56
DISP_CS: J104.23, U100.12
DISP_DC: J104.25, U100.20
DISP_MISO: J104.28, TP105.1, U100.10
DISP_MOSI: J104.27, TP106.1, U100.11
DISP_SCLK: J104.24, TP104.1, U100.9
GND: BT401.2, C101.2, C102.2, C301.2, C302.2, C303.2, C304.2, C305.2, C306.2, C309.2, C401.2, C402.2, C403.2, C404.2, C405.2, C406.2, C501.2, C502.2, C503.2, C507.2, C508.2, C509.2, C511.2, C601.2, C602.2, C603.2, C604.2, J101.3, J101.5, J101.9, J102.2, J103.2, J104.1, J104.40, J601.5, J601.S1, J601.S2, J601.S3, J601.S4, J601.S5, J601.S6, LS501.2, LS502.2, R302.1, R303.2, R403.2, R404.2, R406.2, R407.2, R605.2, SW108.P$3, SW108.P$4, SW801.5, SW802.5, TP403.1, TP503.1, U100.1, U100.2, U100.3, U100.4, U100.5, U100.16, U100.18, U100.29, U100.30, U100.45, U100.46, U100.47, U100.55, U301.4, U301.11, U301.26, U301.35, U301.36, U301.40, U301.41, U401.5, U402.1, U501.8, U502.4, U601.3, U601.29, U602.3
I2C_SCK: J102.4, J103.4, U100.7, U301.34
I2C_SDA: J102.3, J103.3, U100.8, U301.33
I2S_LRCK: U100.59, U501.3
I2S_MCK: U100.60, U501.4
I2S_SCLK: U100.58, U501.2
I2S_SDOUT: U100.57, U501.1
unnamed: BT401.1, C406.1, Q401.3, TP401.1, U401.9, U401.10
unnamed: C401.1, C402.1, SW401.2, U402.3
unnamed: C504.1, R502.2, TP501.1
unnamed: C504.2, U501.10
unnamed: C505.1, R501.1, U502.1
unnamed: C505.2, LS501.1
unnamed: C506.1, R503.2, TP502.1
unnamed: C506.2, U501.7
unnamed: C507.1, C508.1, U501.5
unnamed: C509.1, U501.6
unnamed: C510.1, R504.1, U502.7
unnamed: C510.2, LS502.1
unnamed: C511.1, U502.3
unnamed: D401.1, R401.1
unnamed: D402.1, R402.1
unnamed: D403.1, R405.1
unnamed: D404.1, Q401.2, SW401.3
unnamed: D601.1, U601.19
unnamed: D601.2, R602.2
unnamed: D602.1, U601.18
unnamed: D602.2, R603.2
unnamed: R301.2, U301.38
unnamed: R302.2, U301.30
unnamed: R303.1, U301.39
unnamed: R401.2, U401.4
unnamed: R402.2, U401.3
unnamed: R403.1, R404.1, U401.6
unnamed: R405.2, U401.7
unnamed: R406.1, U401.8
unnamed: R501.2, R502.1, U502.2
unnamed: R503.1, R504.2, U502.6
unnamed: R601.2, U601.9
unnamed: R604.2, R605.1, U601.8
SAO_GPIO1: J102.5, J103.5, U100.32
SAO_GPIO2: J102.6, J103.6, U100.33
SDT_SPI_MISO: J104.32, TP102.1, U100.50
SDT_SPI_MOSI: J104.34, TP101.1, U100.51
SDT_SPI_SCK: J104.33, TP103.1, U100.49
SD_CS: J104.35, U100.31
SW1: D225.3, D226.3, D227.3, D228.3, D229.3, D230.3, D231.3, D232.3, U301.1
SW2: D225.2, D226.2, D227.2, D228.2, D229.2, D230.2, D231.2, D232.2, U301.2
SW3: D225.4, D226.4, D227.4, D228.4, D229.4, D230.4, D231.4, D232.4, U301.3
SW4: D217.3, D218.3, D219.3, D220.3, D221.3, D222.3, D223.3, D224.3, U301.5
SW5: D217.2, D218.2, D219.2, D220.2, D221.2, D222.2, D223.2, D224.2, U301.6
SW6: D217.4, D218.4, D219.4, D220.4, D221.4, D222.4, D223.4, D224.4, U301.7
SW7: D209.3, D210.3, D211.3, D212.3, D213.3, D214.3, D215.3, D216.3, U301.8
SW8: D209.2, D210.2, D211.2, D212.2, D213.2, D214.2, D215.2, D216.2, U301.9
SW9: D209.4, D210.4, D211.4, D212.4, D213.4, D214.4, D215.4, D216.4, U301.10
SW10: D201.3, D202.3, D203.3, D204.3, D205.3, D206.3, D207.3, D208.3, U301.12
SW11: D201.2, D202.2, D203.2, D204.2, D205.2, D206.2, D207.2, D208.2, U301.13
SW12: D201.4, D202.4, D203.4, D204.4, D205.4, D206.4, D207.4, D208.4, U301.14
TOUCH_CS: J104.30, U100.19
UART_CTS: U100.23, U601.24
UART_RTS: U100.21, U601.23
UART_RX: U100.24, U601.26
UART_TX: U100.22, U601.25
USBDATA+: J601.3, U601.4, U602.2
USBDATA-: J601.2, U601.5, U602.1
VBUS: C405.1, C601.1, C602.1, D401.2, D402.2, D403.2, D404.2, J601.1, Q401.1, R407.1, R604.1, U401.1, U401.2, U602.5
XTAL0: C101.1, U100.13, Y101.1
XTAL1: C102.1, U100.14, Y101.2
~A_DOWN: D805.1, SW801.6, U100.28
~A_LEFT: D802.1, SW801.3, U100.42
~A_RIGHT: D804.1, SW801.4, U100.6
~A_SELECT: D803.1, SW801.2, U100.62
~A_UP: D801.1, SW801.1, U100.27
~B_DOWN: D810.1, SW802.6, U100.53
~B_LEFT: D807.1, SW802.3, U100.54
~B_RIGHT: D809.1, SW802.4, U100.61
~B_SELECT: D808.1, SW802.2, U100.63
~B_UP: D806.1, SW802.1, U100.52
~JOYPAD_INTR: D801.2, D802.2, D803.2, D804.2, D805.2, D806.2, D807.2, D808.2, D809.2, D810.2, U100.64
~RESET_TGTMCU: J101.10, SW108.P$1, SW108.P$2, U100.39
