netik/dc27_badge/hardware/DC27-SAO/DC27-SAO.kicad_pcb

## KiCad design hardware/DC27-SAO/DC27-SAO.kicad_pcb (2018-09-25)

Schematic: DC27-SAO.sch

Parts:
C1, C4: 2.2uF; C_0603_1608Metric
C2, C3, C5: 1uF; C_0603_1608Metric
C6: 22nF; C_0603_1608Metric
D1, D2, D3, D4, D5, D6, D7, D8, D9: LED; LED_0603_1608Metric
DS1: ER-OLED0.84-1; PinHeader_1x14_P1.00mm_Horizontal
J1: ISP; PinHeader_2x03_P1.00mm_Vertical
JP1: SCL SOURCE; SolderJumper-3_P1.3mm_Bridged12_Pad1.0x1.5mm
JP2: SDA SOURCE; SolderJumper-3_P1.3mm_Bridged12_Pad1.0x1.5mm
R1, R2, R3, R4, R5, R6, R7, R8, R9: 70; R_0603_1608Metric
R10: 1k; R_0603_1608Metric
R11, R12: 2k; R_0603_1608Metric
R13: 820k; R_0603_1608Metric
SW1: UP; MF_Switches-TACT4.2MM
SW2: SEL; MF_Switches-TACT4.2MM
SW3: DN; MF_Switches-TACT4.2MM
U1: ATtiny2313-20PU; SOIC-20W_7.5x12.8mm_P1.27mm
X1: Badgelife_shitty_connector; Badgelife-SAO

Connections:
DISP_SCK: DS1.10, JP1.2, R12.2
DISP_SDA: DS1.11, JP2.2, R11.2
GND: C1.2, C4.2, C5.2, C6.2, D1.1, D2.1, D3.1, D4.1, D5.1, D6.1, D7.1, D8.1, D9.1, DS1.7, J1.6, R13.2, U1.10 (GND), X1.2
LED_B: R3.2, R6.2, R9.2, U1.6 (PD2)
LED_G: R2.2, R5.2, R8.2, U1.3 (PD1)
LED_R: R1.2, R4.2, R7.2, U1.2 (PD0)
unnamed: C2.1, DS1.3
unnamed: C2.2, DS1.4
unnamed: C3.1, DS1.1
unnamed: C3.2, DS1.2
unnamed: C4.1, DS1.13
unnamed: C6.1, DS1.6
unnamed: D1.2, R1.1
unnamed: D2.2, R2.1
unnamed: D3.2, R3.1
unnamed: D4.2, R4.1
unnamed: D5.2, R5.1
unnamed: D6.2, R6.1
unnamed: D7.2, R7.1
unnamed: D8.2, R8.1
unnamed: D9.2, R9.1
unnamed: DS1.12, R13.1
PB0: J1.4, JP2.1, U1.12 (PB0)
PB1: J1.1, U1.13 (PB1)
SAO_SCK: JP1.3, X1.3
SAO_SDA: JP2.3, X1.4
SCK: J1.3, JP1.1, U1.14 (PB2)
VCC: C1.1, C5.1, DS1.5, DS1.8, DS1.14, J1.2, R10.1, R11.1, R12.1, U1.20 (VCC), X1.1
~RESET: DS1.9, J1.5, R10.2, U1.1 (PA2/~RESET)

Notes on the sheet:
These jumpers control if our MCU or the SAO’s MCPU is in charge of the screen.
Connector: ER-CON14HT-1 maybe?
pogo pins ISP?
Note to self: There’s about ten pins here, we could drive all the LED elements individually.
20ma RED, 2V Fwd 3.3v VCC
10ma GREEN, 2.1V Fwd 3.3v VCC
10ma BLUE, 2.1V Fwd 3.3v VCC

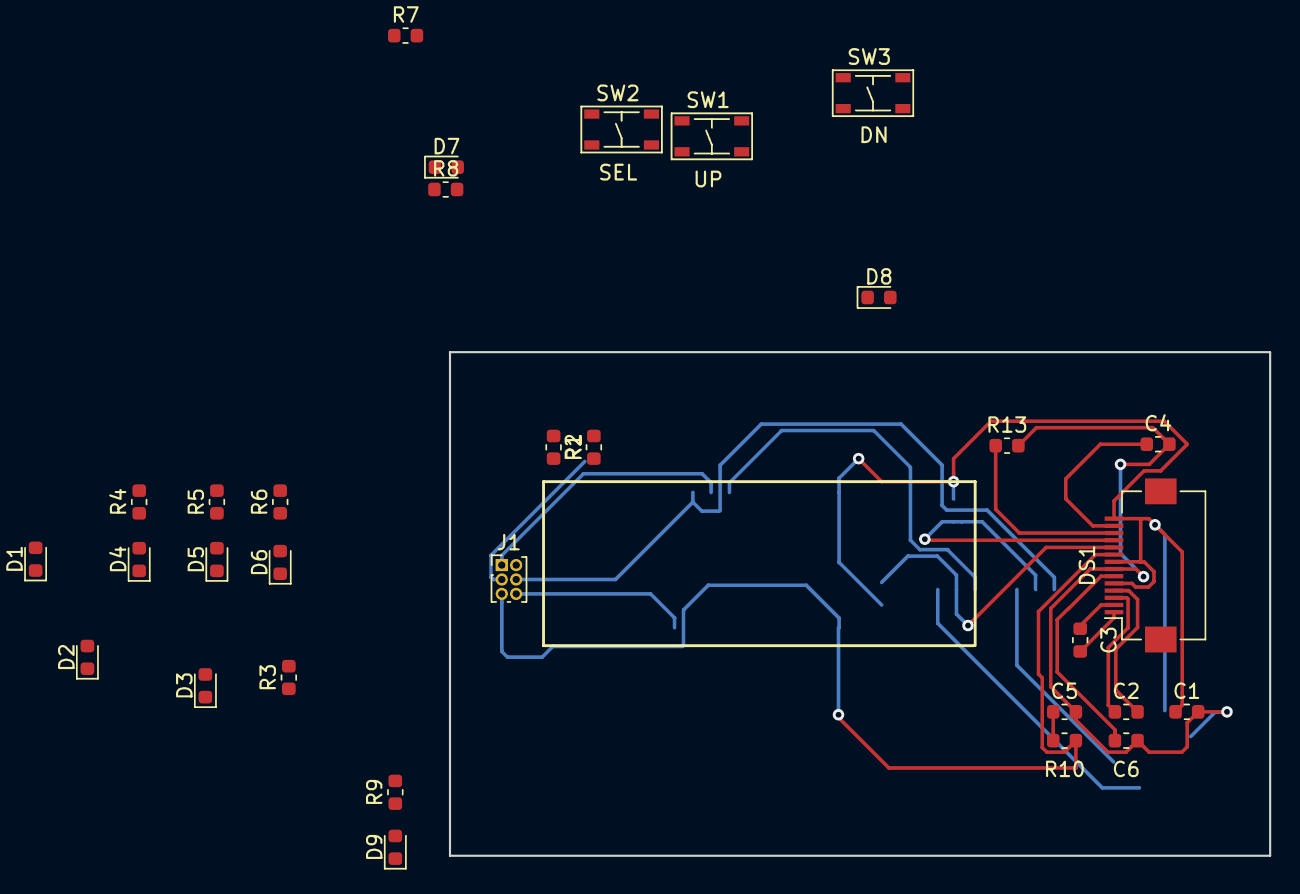
[picture p107: board DC27-SAO.kicad_pcb from above]

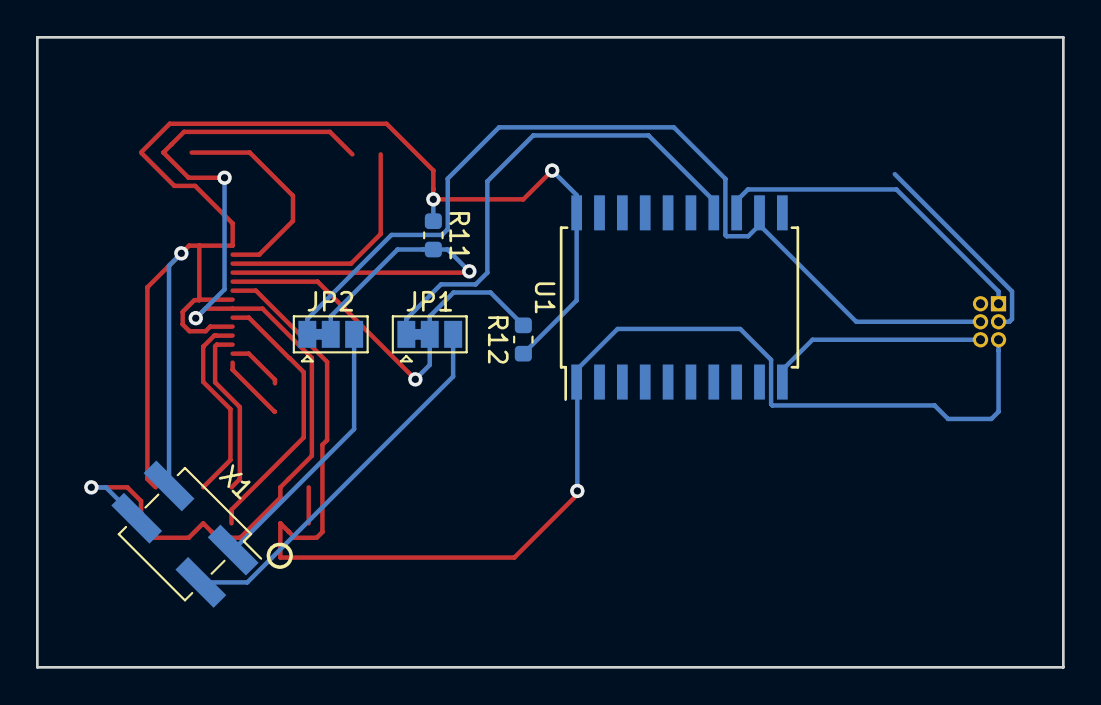
[picture p108: board DC27-SAO.kicad_pcb from below]

Board: 2 copper layers, 57.0 x 35.0 mm, 37 parts (6 on the bottom side), 29 nets.
