netik/dc27_badge/software/firmware/badge/main.c

#include <stdint.h>
#include <string.h>
#include <stdlib.h>

#include "ch.h"
#include "hal.h"
#include "hal_spi.h"
#include "shell.h"

#include "gfx.h"
#include "src/gdisp/gdisp.h"

#include "ble.h"
#include "ble_lld.h"
#include "ble_gap.h"
#include "ble_gap_lld.h"

#include "ff.h"
#include "ffconf.h"
#include "diskio.h"

#include "async_io_lld.h"
#include "joypad_lld.h"
#include "nullprot_lld.h"

#include "orchard-ui.h"
#include "orchard-app.h"

#include "userconfig.h"

#include "nrf52flash_lld.h"
#include "nrf52temp_lld.h"
#include "hal_flash.h"

#include "nrf52i2s_lld.h"

#include "badge.h"
#include "splash.h"
#include "led.h"
#include "images.h"
#include "unlocks.h"

// Drop dead if the SD Card isn't inserted.
#define HALT_ON_SDFAIL 1

// define this to bypass the startup screen, sponsors and song.
#undef FAST_STARTUP

struct evt_table orchard_events;

#ifdef HALT_ON_SDFAIL
extern void tonePlay (GWidgetObject * w, uint8_t b, uint32_t duration);
#endif

/* linker set for command objects */
orchard_command_start();
orchard_command_end();

static const SPIConfig spi1_config = {
	NULL,			/* enc_cp */
	NRF5_SPI_FREQ_8MBPS,	/* freq */
	IOPORT2_SPI_SCK,	/* sckpad */
	IOPORT2_SPI_MOSI,	/* mosipad */
	IOPORT2_SPI_MISO,	/* misopad */
	IOPORT1_SDCARD_CS,	/* sspad */
	FALSE,			/* lsbfirst */
	2,			/* mode */
	0xFF			/* dummy data for spiIgnore() */
};

static const SPIConfig spi4_config = {
	NULL,			/* enc_cp */
	NRF5_SPI_FREQ_32MBPS,	/* freq */
	IOPORT1_SPI_SCK,	/* sckpad */
	IOPORT1_SPI_MOSI,	/* mosipad */
	IOPORT1_SPI_MISO,	/* misopad */
	IOPORT1_SCREEN_CS,	/* sspad */
	FALSE,			/* lsbfirst */
	2,			/* mode */
	0xFF			/* dummy data for spiIgnore() */
};

static const I2CConfig i2c2_config = {
	400000,			/* clock */
	IOPORT1_I2C_SCK,	/* scl_pad */
	IOPORT1_I2C_SDA		/* sda_pad */
};

static const NRF52FLASHConfig nrf52_config = {
	256		/* NRF52840 has 1MB flash (256 * 4096) */
};

NRF52FLASHDriver FLASHD2;

static void
gpt_callback(GPTDriver *gptp)
{
	(void)gptp;
	return;
}

static void
mmc_callback(GPTDriver *gptp)
{
	(void)gptp;
	disk_timerproc ();
}

/*
 * GPT configuration
 * Frequency: 16MHz
 * Resolution: 32 bits
 */

static const GPTConfig gpt2_config = {
    .frequency  = NRF5_GPT_FREQ_16MHZ,
    .callback   = gpt_callback,
    .resolution = 32,
};

static const GPTConfig gpt3_config = {
    .frequency  = NRF5_GPT_FREQ_62500HZ,
    .callback   = mmc_callback,
    .resolution = 32,
};

static THD_WORKING_AREA(shell_wa, 2048);
static thread_t *shell_tp = NULL;

static SerialConfig serial_config = {
    .speed   = 115200,
    .tx_pad  = IOPORT1_UART_TX,
    .rx_pad  = IOPORT1_UART_RX,
#if NRF5_SERIAL_USE_HWFLOWCTRL	== TRUE
    .rts_pad = IOPORT1_UART_RTS,
    .cts_pad = IOPORT1_UART_CTS,
#endif
};

static void shellRestart(void)
{
	static ShellConfig shellConfig;
	static const ShellCommand *shellCommands;

	shellCommands = orchard_commands();

	shellConfig.sc_channel =  (BaseSequentialStream *)&SD1;
	shellConfig.sc_commands = shellCommands;

	/* Recovers memory of the previous shell. */
	if (shell_tp && chThdTerminatedX(shell_tp))
		chThdRelease(shell_tp);

    	shell_tp = chThdCreateStatic (shell_wa, sizeof(shell_wa),
	    NORMALPRIO + 5, shellThread, (void *)&shellConfig);

	return;
}

static void
orchard_app_restart(eventid_t id)
{
	(void)id;

	orchardAppRestart();
}

static void
shell_termination_handler(eventid_t id)
{
	static int i = 1;

	printf ("\nRespawning shell (shell #%d, event %ld)\n", ++i, id);
	shellRestart ();
}

static void
unlock_update_handler(eventid_t id)
{
	userconfig * config;

	(void)id;

	printf("\nunlocks updated\n");
	config = getConfig();
	config->unlocks = __builtin_bswap32 (ble_unlocks);
	configSave (config);

	i2sPlay("sound/levelup.snd");

	return;
}

/**@brief Function for application main entry.
 */
int main(void)
{
    uint32_t info;
    uint8_t * p;
    const flash_descriptor_t * pFlash;
    uint32_t * faultPtr;
    uint16_t pix1, pix2;
    userconfig * config;

#ifdef CRT0_VTOR_INIT
    __disable_irq();
    SCB->VTOR = 0;
    __enable_irq();
#endif

    /*
     * Enable NULL pointer protection. We use the MPU to make the first
     * 256 bytes of the address space unreadable and unwritable. If someone
     * tries to dereference a NULL pointer, it will result in a load
     * or store at that location, and we'll get a memory manager trap
     * right away instead of possibly dying somewhere else further
     * on down the line.
     */

    nullProtStart ();

    /*
     * Enable division by 0 traps. We do not enable unaligned access
     * traps because the SoftDevice code performs unaligned accesses
     * all over the place.
     */

    SCB->CCR |= SCB_CCR_DIV_0_TRP_Msk;

    /*
     * Enable memory management, usage and bus fault exceptions, so that
     * we don't always end up diverting through the hard fault handler.
     * Note: the memory management fault only applies if the MPU is
     * enabled, which it currently is (for stack guard pages).
     */

    SCB->SHCSR |= SCB_SHCSR_USGFAULTENA_Msk |
        SCB_SHCSR_BUSFAULTENA_Msk |
        SCB_SHCSR_MEMFAULTENA_Msk;

    /* Enable deep sleep mode when we execute a WFI */

    SCB->SCR |= SCB_SCR_SLEEPDEEP_Msk;

    /*
     * Enable FPU interrupts. These signal events like underflow and
     * overflow. Technically it's safe to ignore them, but we really
     * should at mimimum clear them when they occur. If we don't,
     * by leaving the interrupt outstanding, we won't be able to
     * enter low power sleep mode.
     */

    NVIC_SetPriority (FPU_IRQn, NRF5_FPU_IRQ_PRIORITY);
    NVIC_EnableIRQ (FPU_IRQn);

    /* Initialize ChibiOS */

    halInit();
    chSysInit();
    shellInit();

    /* Initialize newlib (libc) facilities. */

    newlibStart ();

    sdStart (&SD1, &serial_config);
    chThdSleepMilliseconds (50);
    printf ("\n");
    chThdSleepMilliseconds (50);

    gptStart (&GPTD2, &gpt2_config);
    gptStart (&GPTD3, &gpt3_config);

    printf ("SYSTEM START\n");

    /* Display reset reason */

    if (NRF_POWER->RESETREAS) {
        info = NRF_POWER->RESETREAS;
        /* Clear accumulated reasons. */
        NRF_POWER->RESETREAS = 0xFFFFFFFF;

        printf ("Reset event (0x%lX):", info);
        if (info & POWER_RESETREAS_VBUS_Msk)
            printf (" Wake up due to VBUS level");
        if (info & POWER_RESETREAS_NFC_Msk)
            printf (" Wake up due to NFC detect");
        if (info & POWER_RESETREAS_DIF_Msk)
            printf (" Wake up due to entering debug IF mode");
        if (info & POWER_RESETREAS_LPCOMP_Msk)
            printf (" Wake up due to reaching LPCOMP power threshold");
        if (info & POWER_RESETREAS_OFF_Msk)
            printf (" Wake up due to GPIO detect");
        if (info & POWER_RESETREAS_LOCKUP_Msk)
            printf (" Reset due to CPU lockup");
        if (info & POWER_RESETREAS_SREQ_Msk)
            printf (" Soft reset");
        if (info & POWER_RESETREAS_DOG_Msk)
            printf (" Watchdog reset");
        if (info & POWER_RESETREAS_RESETPIN_Msk)
            printf (" Reset pin asserted");
        printf ("\n");
    } else {
        printf ("Power on\n");
    }

    /* Check if we rebooted due to a SoftDevice crash. */

    faultPtr = (uint32_t *)NRF_FAULT_INFO_ADDR;
    if (*faultPtr == NRF_FAULT_INFO_MAGIC) {
        printf ("Reset after SoftDevice fault, "
            "Id: 0x%lX PC: 0x%lX INFO: 0x%lX\n",
            faultPtr[1], faultPtr[2], faultPtr[3]);
        faultPtr[0] = 0;
    }

    info = NRF_FICR->INFO.VARIANT;
    p = (uint8_t *)&info;
    printf ("Nordic Semiconductor nRF%lx Variant: %c%c%c%c ",
        NRF_FICR->INFO.PART, p[3], p[2], p[1], p[0]);
    printf ("RAM: %ldKB Flash: %ldKB\n", NRF_FICR->INFO.RAM,
        NRF_FICR->INFO.FLASH);
    printf ("Device ID: %lX%lX\n", NRF_FICR->DEVICEID[0],
        NRF_FICR->DEVICEID[1]);
    chThdSleep(2);
    printf (PORT_INFO "\n");
    chThdSleep(2);

    /* Check if the reset pin has been set, and update the UICR if not */

    if (NRF_UICR->PSELRESET[0] != IOPORT1_RESET) {
	volatile uint32_t * tmp;
	int i;

	/* Save customer area */

	/*
	 * Save the customer area, in case it has the badge access
	 * password stored in it. Since we haven't turned the
	 * SoftDevice on yet, we can temporarily use its RAM
	 * area as scratch space rather than wasting stack or
	 * heap space of our own.
	 */

	tmp = (uint32_t *)0x20000400;
	for (i = 0; i < 32; i++)
		tmp[i] = NRF_UICR->CUSTOMER[i];

        printf ("Reset pin not configured, programming... ");
        NRF_NVMC->CONFIG = NVMC_CONFIG_WEN_Wen;
        NRF_NVMC->ERASEUICR = 1;
        while (NRF_NVMC->READY == NVMC_READY_READY_Busy)
                ;
        NRF_NVMC->CONFIG = NVMC_CONFIG_WEN_Ren;

        NRF_NVMC->CONFIG = NVMC_CONFIG_WEN_Wen;

        NRF_UICR->PSELRESET[0] = IOPORT1_RESET;
        NRF_UICR->PSELRESET[1] = IOPORT1_RESET;

	/* Restore customer area */

	for (i = 0; i < 32; i++)
		NRF_UICR->CUSTOMER[i] = tmp[i];

        while (NRF_NVMC->READY == NVMC_READY_READY_Busy)
                ;
        NRF_NVMC->CONFIG = NVMC_CONFIG_WEN_Ren;
        printf ("done.\n");
    }

    printf("Priority levels %d\n", CORTEX_PRIORITY_LEVELS);

    /* Enable random number generator */

    rngStart (&RNGD1, NULL);

    printf ("Random number generator enabled\n");

    /* Enable temperature sensor */

    nrf52TempStart ();

    printf ("Temperature sensor enabled\n");

    /* Set up I/O pins */

    palSetPad (IOPORT1, IOPORT1_SPI_MOSI);
    palSetPad (IOPORT1, IOPORT1_SPI_MISO);
    palSetPad (IOPORT1, IOPORT1_SPI_SCK);
    palSetPad (IOPORT1, IOPORT1_SDCARD_CS);
    palSetPad (IOPORT1, IOPORT1_SCREEN_CS);
    palSetPad (IOPORT1, IOPORT1_SCREEN_CD);
    palSetPad (IOPORT1, IOPORT1_TOUCH_CS);

    /* Enable joypad/button support */

    joyStart ();

    printf ("Joypad enabled\n");

    /* Start async I/O thread */

    asyncIoStart ();

    /* Start SPI buses */

    spiStart (&SPID1, &spi1_config);
    printf ("SPI bus 1 enabled\n");

    spiStart (&SPID4, &spi4_config);
    printf ("SPI bus 4 enabled\n");

    /* Enable on-board flash */
    nrf52FlashObjectInit (&FLASHD2);
    nrf52FlashStart (&FLASHD2, &nrf52_config);
    pFlash = flashGetDescriptor (&FLASHD2);

    if (pFlash->sectors_count > 0) {
        printf ("On-board NRF52840 flash detected: %ldMB mapped at 0x%lx\n",
            (pFlash->sectors_count * pFlash->sectors_size) >> 20,
	    pFlash->address);
    }

    /* Enable I2C controller */

    i2cStart (&I2CD2, &i2c2_config);
    printf ("I2C interface enabled\n");

    /* Enable I2S controller */
    i2sStart ();
    printf ("I2S interface enabled\n");

    /*
     * Init the user configuration - can be
     * done once the flash driver is initialized.
     */
    configStart();
    config = getConfig ();

    if (config->unlocks & UL_LEDSDISABLE) {
        printf ("LEDs disabled by user - "
            "press joystick A and reset to re-enable.\n");
    /* start the LEDs */
    } else if (led_init()) {
        printf ("I2C LED controller found.\r\n");
        ledStart();
    } else {
        printf ("I2C LED controller not found. No Bling ;(\r\n");
    }

    /* Enable display and touch panel */
    gfxInit ();

    /* Mount SD card */
    if (gfileMount ('F', "0:") == FALSE) {
        printf ("No SD card found\n");
        splash_SDFail();
        ledSetPattern(LED_TEST); // failure mode
        shellRestart ();
#ifdef HALT_ON_SDFAIL
        for (int i = 0; i < 2; i++) {
          // 404, 404, get it? :)
          tonePlay (NULL, 4, 50);
          chThdSleepMilliseconds(50);
          tonePlay (NULL, 0, 50);
          chThdSleepMilliseconds(50);
          tonePlay (NULL, 4, 50);
          chThdSleepMilliseconds(50);
        }
        chThdSleep (TIME_INFINITE);
#endif
    } else
      printf ("SD card detected\n");

    /*
     * Detect if screen is plugged in. We try to write some data to
     * the display and then read it back from the GRAM. If the data
     * matches, then a display is present.
     *
     * "But Bill," I hear you ask, "the datasheet for the ILI9341 says
     * that the chip has vendor/device ID registers. Can't you detect
     * the chip by reading those?"
     *
     * Well, see, the data from those registers comes from NVRAM, which
     * has to be programmed. As it turns out, I don't think the NVRAM is
     * programmed when the chips leave the factory, and East Rising doesn't
     * seem to program them either when putting the chips on their
     * display modules. So reading the vendor/device ID succeeds, but you
     * get back unset values.
     *
     * Hence we fudge it this way instead.
     */

    gdispDrawPixel (0, 0, 0xCAFE);
    gdispDrawPixel (1, 0, 0xBABE);
    pix1 = gdispGetPixelColor (0, 0);
    pix2 = gdispGetPixelColor (1, 0);

    if (pix1 == 0xCAFE && pix2 == 0xBABE) {
        printf ("Main screen turn on\n");
        /* Reset the pixels to black */
        gdispDrawPixel (0, 0, Black);
        gdispDrawPixel (1, 0, Black);
    } else
        printf ("No screen found\n");

    /* Enable bluetooth subsystem */
    bleStart ();

    /* Set current game board position */
    bleGapUpdateState (config->last_x,
                       config->last_y,
	               config->xp,
	               config->level,
	               config->current_ship,
                       config->in_combat);

    /* Disable the radio if airplane node is on */
    if (config->airplane_mode)
        bleDisable ();

    /* Set default sound behavior */
    if (config->sound_enabled)
        i2sEnabled = TRUE;
    else
        i2sEnabled = FALSE;

    NRF_P0->DETECTMODE = 0;

    /* say hi */
#ifndef FAST_STARTUP
    i2sPlay("sound/start.snd");
#endif /* FAST_STARTUP */
    printf(SHELL_BANNER);

    /* Launch shell thread */
    evtTableInit (orchard_events, 3);
    chEvtObjectInit (&orchard_app_terminated);
    chEvtObjectInit (&unlocks_updated);
    evtTableHook (orchard_events, shell_terminated, shell_termination_handler);
    evtTableHook (orchard_events, unlocks_updated, unlock_update_handler);
    evtTableHook (orchard_events, orchard_app_terminated, orchard_app_restart);
    shellRestart ();

#ifndef FAST_STARTUP
    splash_welcome();
#endif

    uiStart ();
    orchardAppInit ();
    orchardAppRestart ();

    while (true) {
        chEvtDispatch(evtHandlers(orchard_events), chEvtWaitOne(ALL_EVENTS));
    }

    /* NOTREACHED */
}
