netik/dc27_badge/software/firmware/badge_832/main.c

#include <stdint.h>
#include <string.h>
#include <stdlib.h>

#include "ch.h"
#include "hal.h"
#include "hal_spi.h"
#include "chprintf.h"
#include "shell.h"

#include "gfx.h"

#include "ble_lld.h"

#include "ff.h"
#include "ffconf.h"
#include "diskio.h"

#include "async_io_lld.h"
#include "joypad_lld.h"

#include "orchard-ui.h"
#include "orchard-app.h"

#include "badge.h"

struct evt_table orchard_events;

/* linker set for command objects */

orchard_command_start();
orchard_command_end();

#define LED_EXT 14

bool watchdog_started = false;

static const SPIConfig spi1_config = {
	NULL,			/* enc_cp */
	NRF5_SPI_FREQ_8MBPS,	/* freq */
	IOPORT1_SPI_SCK,	/* sckpad */
	IOPORT1_SPI_MOSI,	/* mosipad */
	IOPORT1_SPI_MISO,	/* misopad */
	IOPORT1_SDCARD_CS,	/* sspad */
	FALSE,			/* lsbfirst */
	2,			/* mode */
	0xFF			/* dummy data for spiIgnore() */
};

static const I2CConfig i2c2_config = {
	100000,			/* clock */
	IOPORT1_I2C_SCK,	/* scl_pad */
	IOPORT1_I2C_SDA		/* sda_pad */
};

static void
gpt_callback(GPTDriver *gptp)
{
	(void)gptp;
	return;
}

static void
mmc_callback(GPTDriver *gptp)
{
	(void)gptp;
	disk_timerproc ();
}

/*
 * GPT configuration
 * Frequency: 16MHz
 * Resolution: 32 bits
 */

static const GPTConfig gpt1_config = {
    .frequency  = NRF5_GPT_FREQ_16MHZ,
    .callback   = gpt_callback,
    .resolution = 32,
};

static const GPTConfig gpt2_config = {
    .frequency  = NRF5_GPT_FREQ_62500HZ,
    .callback   = mmc_callback,
    .resolution = 32,
};

static THD_WORKING_AREA(shell_wa, 1024);
static thread_t *shell_tp = NULL;

static SerialConfig serial_config = {
    .speed   = 115200,
    .tx_pad  = UART_TX,
    .rx_pad  = UART_RX,
#if NRF5_SERIAL_USE_HWFLOWCTRL	== TRUE
    .rts_pad = UART_RTS,
    .cts_pad = UART_CTS,
#endif
};

static void shellRestart(void)
{
	static ShellConfig shellConfig;
	static const ShellCommand *shellCommands;

	shellCommands = orchard_commands();

	shellConfig.sc_channel =  (BaseSequentialStream *)&SD1;
	shellConfig.sc_commands = shellCommands;

	/* Recovers memory of the previous shell. */
	if (shell_tp && chThdTerminatedX(shell_tp))
		chThdRelease(shell_tp);

    	shell_tp = chThdCreateStatic (shell_wa, sizeof(shell_wa), NORMALPRIO + 5,
	    shellThread, (void *)&shellConfig);

	return;
}

static void
orchard_app_restart(eventid_t id)
{
	(void)id;

	orchardAppRestart();
}

static void
shell_termination_handler(eventid_t id)
{
	static int i = 1;

	printf ("\r\nRespawning shell (shell #%d, event %d)\r\n", ++i, id);
	shellRestart ();
}

static THD_WORKING_AREA(waThread1, 64);
static THD_FUNCTION(Thread1, arg) {

    (void)arg;
    uint8_t led = LED4;
    
    chRegSetThreadName("blinker");

    
    while (1) {
	palTogglePad(IOPORT1, led);
	chThdSleepMilliseconds(1000);
    }
}

void
SVC_Handler (void)
{
	while (1) {}
}

/**@brief Function for application main entry.
 */
int main(void)
{
    uint32_t info;
    uint8_t * p;
#ifdef CRT0_VTOR_INIT
    __disable_irq();
    SCB->VTOR = 0;
    __enable_irq();
#endif

    halInit();
    chSysInit();
    shellInit();
 
    sdStart (&SD1, &serial_config);
    printf ("\r\n");

    palClearPad (IOPORT1, LED1);
    palClearPad (IOPORT1, LED2);
    palClearPad (IOPORT1, LED3);
    palClearPad (IOPORT1, LED4);

    gptStart (&GPTD2, &gpt1_config);
    gptStart (&GPTD3, &gpt2_config);

    /* Launch test blinker thread. */
    
    chThdCreateStatic(waThread1, sizeof(waThread1), NORMALPRIO+1,
		      Thread1, NULL);

    chThdSleep(2);
    printf ("SYSTEM START\r\n");
    info = NRF_FICR->INFO.VARIANT;
    p = (uint8_t *)&info;
    printf ("Nordic Semiconductor nRF%x Variant: %c%c%c%c ",
        NRF_FICR->INFO.PART, p[3], p[2], p[1], p[0]);
    printf ("RAM: %dKB Flash: %dKB\r\n", NRF_FICR->INFO.RAM,
        NRF_FICR->INFO.FLASH);
    printf ("Device ID: %x%x\r\n", NRF_FICR->DEVICEID[0],
        NRF_FICR->DEVICEID[1]);
    chThdSleep(2);
    printf (PORT_INFO "\r\n");
    chThdSleep(2);

    printf("Priority levels %d\r\n", CORTEX_PRIORITY_LEVELS);

    joyStart ();
    asyncIoStart ();

    palSetPad (IOPORT1, IOPORT1_SPI_MOSI);
    palSetPad (IOPORT1, IOPORT1_SPI_MISO);
    palSetPad (IOPORT1, IOPORT1_SPI_SCK);
    palSetPad (IOPORT1, IOPORT1_SDCARD_CS);
    palSetPad (IOPORT1, IOPORT1_TOUCH_CS);

    spiStart (&SPID1, &spi1_config);

    i2cStart (&I2CD2, &i2c2_config);

    gfxInit ();

    if (gfileMount ('F', "0:") == FALSE)
        printf ("No SD card found.\r\n");
    else
        printf ("SD card detected.\r\n");

    bleStart ();

    NRF_P0->DETECTMODE = 0;

    /* Launch shell thread */

    evtTableInit (orchard_events, 5);
    evtTableHook (orchard_events, shell_terminated, shell_termination_handler);

    shellRestart ();
    uiStart ();
    orchardAppInit ();
    orchardAppRestart ();

    evtTableHook (orchard_events, orchard_app_terminated, orchard_app_restart);

    while (true) {
        chEvtDispatch(evtHandlers(orchard_events), chEvtWaitOne(ALL_EVENTS));
    }

}
