netik/dc27_badge/software/firmware/v2600/cpu.c

/*****************************************************************************

   This file is part of x2600, the Atari 2600 Emulator
   ===================================================
   
   Copyright 1996 Alex Hornby. For contributions see the file CREDITS.

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
   See the file COPYING for details.
   
   $Id: cpu.c,v 1.11.1.11 1997/11/22 14:27:47 ahornby Exp $
******************************************************************************/
/* 
 * 6507 CPU emulation
 *
 * Originally from X64
 * Modified by Alex Hornby for use in x2600
 * See COPYING for license terms
 */

#include "ch.h"
#include "hal.h"
#include "badge.h"

/*#include <stdio.h>*/
#include <stdlib.h>
#include <sys/types.h>
#include "cpu.h"
#include "macro.h"
#include "vmachine.h"
#include "memory.h"
#include "display.h"
#include "misc.h"
#include "config.h"
#include "exmacro.h"
#include "debug.h"
#include "dbg_mess.h"

/* Verbose output flag from X64 debugging code */
#ifdef DEBUG
int verflg = 0;
#endif

/* Hex output flag from X64 debugging code */
int hexflg = 0;

/* X64 compatible debug code. depreciated */
void
mon (ADDRESS a)
{
}

/* X64 compatible debug code. depreciated */
#ifdef DEBUG
#include "memory.h"
int rd[RAMSIZE];
int wr[RAMSIZE];
long instructions[256];
#endif

/* The X based debugger prototypes */
#ifdef XDEBUGGER
extern void x_loop (void);
extern void set_single (void);
#endif

/* CPU internals */
ADDRESS program_counter;
BYTE x_register, y_register, stack_pointer;
BYTE accumulator, status_register;
int zero_flag;
int sign_flag;
int overflow_flag;
int break_flag;
int decimal_flag;
int interrupt_flag;
int carry_flag;

/* CPU Clock counts */
/* Aggregate */
CLOCK clk;
/* Current instruction */
CLOCK clkcount = 0;

/* Electron beam adjuctment values for nine and twelve colour clock ins. */
#define BEAMNINE 5
#define BEAMTWELVE 9
int beamadj;

/* Used in undocumented 6507 instructions */
/* These are unusual and have no discernable use, but here it is. */
/* val: register to be acted upon */
/* address: address to take high byte from */
/* index: index to add to calculated address */
#ifndef NO_UNDOC_CMDS
void
u_stoshr (unsigned int val, ADDRESS address, BYTE index)
{
  val &= (((address >> 8) + 1) & 0xff);
  if (((address & 0xff) + index) > 0xff)
    address = val;
  STORE ((address + index), val);
}
#endif /* UNDOC */

/* Initialise the CPU */
/* addr: reset vector address */
/* Called from init_hardware() */
void
init_cpu (ADDRESS addr)
{
  SET_SR (0x20);
  AC=0;
  XR=0;
  YR=0;	
  SP = 0xff;
#ifdef DEBUG
  dbg_message(DBG_NORMAL,"ADDR=%x\n",addr);
#endif
  PC = LOAD_ADDR (addr);
  clk = 0;
  clkcount = 0;
}

/* The main emulation loop, performs the CPU emulation */
void
mainloop (void)
{
  BYTE b;
  init_hardware ();
  while (1)
    {
#ifdef DEBUG
      dbg_message(DBG_NORMAL,"Reset flag=%d\n",reset_flag);
#endif
      if (reset_flag)
	{
	  reset_flag = 0;
	  if (fselLoad () == 0)
	    {
#ifdef DEBUG
	      dbg_message(DBG_NORMAL,"Calling init_hardware\n");
#endif
	      init_hardware ();
	    }
	}

#ifdef DEBUG
      dbg_message(DBG_NORMAL,"Starting mainloop at %x\n", PC);
#endif
      while (!reset_flag)
	{
	  do_screen (clkcount);

#ifdef XDEBUGGER
	  if (debugf_on)
	  x_loop ();
#endif
	  b = LOADEXEC (PC);
	  beamadj = 0;

	  switch (b)
	    {
	    case 0:
	      {
		PC++;
		/* Force break. */

#ifdef DEBUG
		if (verflg)
		  {
		    printf ("BRK %ld\n", clk);
		    show ();
		  }
#endif

		SET_BREAK (1);	/* Set break status. */
		PUSH (UPPER (PC));
		PUSH (LOWER (PC));	/* Push return address into the stack. */
		PUSH (GET_SR ());	/* Push status register into the stack. */
		SET_INTERRUPT (1);	/* Disable interrupts. */
		PC = LOAD_ADDR ((ADDRESS) 65534);	/* Jump using BRK vector (0xfffe). */
		clkcount = 7;
	      }
	      break;

	    case 1:
	      {
		BYTE p1 = LOAD (PC + 1);
		unsigned int src = LOAD (LOAD_ZERO_ADDR (p1 + XR));
		PC += 2;

		src |= AC;
		SET_SIGN (src);
		SET_ZERO (src);

		AC = (src);;
		clkcount = 6;
	      }

	      break;

	    case 2:
	      {
		PC++;
		/* No such opcode. */
		--PC;
#ifdef DEBUG
		verflg = 1;
		(void) printf ("Illegal instruction.\n");
		show ();
#endif
		mon (PC);
	      }

	      break;

	    case 3:
	      {
		BYTE p1 = LOAD (PC + 1);
		unsigned int src = LOAD (LOAD_ZERO_ADDR (p1 + XR));
		PC += 2;

		/* src = asl(src); AC = ora(src); */

		SET_CARRY (src & 0x80);		/* ASL+ORA */
		src <<= 1;
		src |= AC;
		src &= 0xff;
		SET_SIGN (src);
		SET_ZERO (src);

		STORE (LOAD_ZERO_ADDR (p1 + XR), (src));;
		clkcount = 8;
	      }

	      break;

	    case 4:
	      {
		PC += 2;

		clkcount = 3;
	      }

	      break;

	    case 5:
	      {
		BYTE p1 = LOAD (PC + 1);
		unsigned int src = LOAD_ZERO (p1);
		PC += 2;

		src |= AC;
		SET_SIGN (src);
		SET_ZERO (src);

		AC = (src);;
		clkcount = 3;
	      }

	      break;

	    case 6:
	      {
		BYTE p1 = LOAD (PC + 1);
		unsigned int src = LOAD_ZERO (p1);
		PC += 2;

		SET_CARRY (src & 0x80);
		src <<= 1;
		src &= 0xff;
		SET_SIGN (src);
		SET_ZERO (src);

		STORE_ZERO (p1, (src));;
		clkcount = 5;
	      }

	      break;

	    case 7:
	      {
		BYTE p1 = LOAD (PC + 1);
		unsigned int src = LOAD_ZERO (p1);
		PC += 2;

		/* src = asl(src); AC = ora(src); */

		SET_CARRY (src & 0x80);		/* ASL+ORA */
		src <<= 1;
		src |= AC;
		src &= 0xff;
		SET_SIGN (src);
		SET_ZERO (src);

		STORE_ZERO (p1, (src));;
		clkcount = 5;
	      }

	      break;

	    case 8:
	      {
		unsigned int src = GET_SR ();
		PC++;

		PUSH (src);
		/* First push item onto stack and then decrement SP. */
		clkcount = 3;
	      }

	      break;

	    case 9:
	      {
		BYTE p1 = LOAD (PC + 1);
		unsigned int src = p1;
		PC += 2;

		src |= AC;
		SET_SIGN (src);
		SET_ZERO (src);

		AC = (src);;
		clkcount = 2;
	      }

	      break;

	    case 10:
	      {
		unsigned int src = AC;
		PC++;

		SET_CARRY (src & 0x80);
		src <<= 1;
		src &= 0xff;
		SET_SIGN (src);
		SET_ZERO (src);

		AC = (src);;
		clkcount = 2;
	      }

	      break;

	    case 11:
	      {
		BYTE p1 = LOAD (PC + 1);
		unsigned int src = (AC & p1);
		PC += 2;

		src &= AC;
		SET_SIGN (src);
		SET_ZERO (src);

		AC = (src);;
		clkcount = 2;
	      }

	      break;

	    case 12:
	      {
		PC += 3;

		clkcount = 4;
	      }

	      break;

	    case 13:
	      {
		unsigned short p2 = load_abs_addr ();
		unsigned int src = LOAD (p2);
		PC += 3;

		src |= AC;
		SET_SIGN (src);
		SET_ZERO (src);

		AC = (src);;
		clkcount = 4;
	      }

	      break;

	    case 14:
	      {
		unsigned short p2 = load_abs_addr ();
		unsigned int src = LOAD (p2);
		PC += 3;

		SET_CARRY (src & 0x80);
		src <<= 1;
		src &= 0xff;
		SET_SIGN (src);
		SET_ZERO (src);

		STORE (p2, (src));;
		clkcount = 6;
	      }

	      break;

	    case 15:
	      {
		unsigned short p2 = load_abs_addr ();
		unsigned int src = LOAD (p2);
		PC += 3;

		/* src = asl(src); AC = ora(src); */

		SET_CARRY (src & 0x80);		/* ASL+ORA */
		src <<= 1;
		src |= AC;
		src &= 0xff;
		SET_SIGN (src);
		SET_ZERO (src);

		STORE (p2, (src));;
		clkcount = 6;
	      }

	      break;

	    case 16:
/*  BPL,    RELATIVE */
	      {
		BYTE p1 = LOAD (PC + 1);
		unsigned int src = p1;
		BYTE hb;
		PC += 2;
		/* Branch if sign flag is clear. */
		if (!IF_SIGN ())
		  {
		    hb = UPPER (PC);
		    PC = REL_ADDR (PC, src);
		    if (brtest (hb))
		      /* Same page */
		      clkcount = 3;
		    else
		      /* Different page */
		      clkcount = 4;
		  }
		else
		  clkcount = 2;
	      }

	      break;

	    case 17:
/* ORA,    INDIRECT_Y */
	      {
		BYTE p1 = LOAD (PC + 1);
		ADDRESS p2 = LOAD_ZERO_ADDR (p1);
		unsigned int src = LOAD (p2 + YR);
		PC += 2;

		/* If low byte of address  + index reg is > 0xff then extra cycle */
		if (pagetest (p2, YR))
		  /* Over page */
		  clkcount = 6;
		else
		  /* Same page */
		  clkcount = 5;
		src |= AC;
		SET_SIGN (src);
		SET_ZERO (src);

		AC = (src);;
	      }

	      break;

	    case 18:
	      {
		PC++;
		/* No such opcode. */
		--PC;
#ifdef DEBUG
		verflg = 1;
		(void) printf ("Illegal instruction.\n");
		show ();
#endif
		mon (PC);
	      }

	      break;

	    case 19:
	      {
		BYTE p1 = LOAD (PC + 1);
		unsigned int src = LOAD (LOAD_ZERO_ADDR (p1) + YR);
		PC += 2;

		/* src = asl(src); AC = ora(src); */

		SET_CARRY (src & 0x80);		/* ASL+ORA */
		src <<= 1;
		src |= AC;
		src &= 0xff;
		SET_SIGN (src);
		SET_ZERO (src);

		STORE (LOAD_ZERO_ADDR (p1) + YR, (src));;
		clkcount = 8;
	      }

	      break;

	    case 20:
	      {
		PC += 2;

		clkcount = 4;
	      }

	      break;

	    case 21:
	      {
		BYTE p1 = LOAD (PC + 1);
		unsigned int src = LOAD_ZERO (p1 + XR);
		PC += 2;

		src |= AC;
		SET_SIGN (src);
		SET_ZERO (src);

		AC = (src);;
		clkcount = 4;
	      }

	      break;

	    case 22:
	      {
		BYTE p1 = LOAD (PC + 1);
		unsigned int src = LOAD_ZERO (p1 + XR);
		PC += 2;

		SET_CARRY (src & 0x80);
		src <<= 1;
		src &= 0xff;
		SET_SIGN (src);
		SET_ZERO (src);

		STORE_ZERO (p1 + XR, (src));;
		clkcount = 6;
	      }

	      break;

	    case 23:
	      {
		BYTE p1 = LOAD (PC + 1);
		unsigned int src = LOAD_ZERO (p1 + XR);
		PC += 2;

		/* src = asl(src); AC = ora(src); */

		SET_CARRY (src & 0x80);		/* ASL+ORA */
		src <<= 1;
		src |= AC;
		src &= 0xff;
		SET_SIGN (src);
		SET_ZERO (src);

		STORE_ZERO (p1 + XR, (src));;
		clkcount = 6;
	      }

	      break;

	    case 24:
	      {
		PC++;


		SET_CARRY ((0));;
		clkcount = 2;
	      }

	      break;

	    case 25:
/*  ORA,    ABSOLUTE_Y */
	      {
		unsigned short p2 = load_abs_addr ();
		unsigned int src = LOAD (p2 + YR);
		PC += 3;

		if (pagetest (p2, YR))
		  /* Over page */
		  clkcount = 5;
		else
		  /* Same page */
		  clkcount = 4;

		src |= AC;
		SET_SIGN (src);
		SET_ZERO (src);

		AC = (src);;
	      }

	      break;

	    case 26:
	      {
		PC++;

		clkcount = 2;
	      }

	      break;

	    case 27:
	      {
		unsigned short p2 = load_abs_addr ();
		unsigned int src = LOAD (p2 + YR);
		PC += 3;

		/* src = asl(src); AC = ora(src); */

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
	      {
		BYTE p1 = LOAD (PC + 1);
		unsigned int src = (AC & p1);
		PC += 2;

		src &= AC;
		SET_SIGN (src);
		SET_ZERO (src);

		AC = (src);;
		clkcount = 2;
	      }

	      break;

	    case 44:
	      {
		unsigned short p2 = load_abs_addr ();
		unsigned int src = LOAD (p2);
		PC += 3;

		SET_SIGN (src);
		SET_OVERFLOW (0x40 & src);	/* Copy bit 6 to OVERFLOW flag. */
		SET_ZERO (src & AC);
		clkcount = 4;
	      }

	      break;

	    case 45:
	      {
		unsigned short p2 = load_abs_addr ();
		unsigned int src = LOAD (p2);
		PC += 3;

		src &= AC;
		SET_SIGN (src);
		SET_ZERO (src);

		AC = (src);;
		clkcount = 4;
	      }

	      break;

	    case 46:
	      {
		unsigned short p2 = load_abs_addr ();
		unsigned int src = LOAD (p2);
		PC += 3;

		src <<= 1;
		if (IF_CARRY ())
		  src |= 0x1;
		SET_CARRY (src > 0xff);
		src &= 0xff;
		SET_SIGN (src);
		SET_ZERO (src);

		STORE (p2, (src));;
		clkcount = 6;
	      }

	      break;

	    case 47:
	      {
		unsigned short p2 = load_abs_addr ();
		unsigned int src = LOAD (p2);
		PC += 3;

		/* src = rol(src); AC = and(src); */

		src <<= 1;
		if (IF_CARRY ())	/* ROL+AND */
		  src |= 0x1;
		SET_CARRY (src > 0xff);
		src &= 0xff;

		AC &= src;
		SET_SIGN (AC);
		SET_ZERO (AC);
		/* rotated, not disturbed */
		STORE (p2, (src));;
		clkcount = 6;
	      }

	      break;

	    case 48:
/*   BMI,    RELATIVE */
	      {
		BYTE p1 = LOAD (PC + 1);
		unsigned int src = p1;
		BYTE hb;
		PC += 2;
		/* Branch if sign flag is set. */
		if (IF_SIGN ())
		  {
		    hb = UPPER (PC);
		    PC = REL_ADDR (PC, src);
		    if (brtest (hb))
		      /* Same page */
		      clkcount = 3;
		    else
		      /* Different page */
		      clkcount = 4;
		  }
		else
		  clkcount = 2;
	      }

	      break;

	    case 49:
/*  AND,    INDIRECT_Y */
	      {
		BYTE p1 = LOAD (PC + 1);
		ADDRESS p2 = LOAD_ZERO_ADDR (p1);
		unsigned int src = LOAD (p2 + YR);
		PC += 2;
		if (pagetest (p2, YR))
		  /* Over page */
		  clkcount = 6;
		else
		  /* Same page */
		  clkcount = 5;

		src &= AC;
		SET_SIGN (src);
		SET_ZERO (src);

		AC = (src);;
	      }

	      break;

	    case 50:
	      {
		PC++;
		/* No such opcode. */
		--PC;
#ifdef DEBUG
		verflg = 1;
		(void) printf ("Illegal instruction.\n");
		show ();
#endif
		mon (PC);
	      }

	      break;

	    case 51:
	      {
		BYTE p1 = LOAD (PC + 1);
		unsigned int src = LOAD (LOAD_ZERO_ADDR (p1) + YR);
		PC += 2;

		/* src = rol(src); AC = and(src); */

		src <<= 1;
		if (IF_CARRY ())	/* ROL+AND */
		  src |= 0x1;
		SET_CARRY (src > 0xff);
		src &= 0xff;

		AC &= src;
		SET_SIGN (AC);
		SET_ZERO (AC);
		/* rotated, not disturbed */
		STORE (LOAD_ZERO_ADDR (p1) + YR, (src));;
		clkcount = 8;
	      }

	      break;

	    case 52:
	      {
		PC += 2;

		clkcount = 4;
	      }

	      break;

	    case 53:
	      {
		BYTE p1 = LOAD (PC + 1);
		unsigned int src = LOAD_ZERO (p1 + XR);
		PC += 2;

		src &= AC;
		SET_SIGN (src);
		SET_ZERO (src);

		AC = (src);;
		clkcount = 4;
	      }

	      break;

	    case 54:
	      {
		BYTE p1 = LOAD (PC + 1);
		unsigned int src = LOAD_ZERO (p1 + XR);
		PC += 2;

		src <<= 1;
		if (IF_CARRY ())
		  src |= 0x1;
		SET_CARRY (src > 0xff);
		src &= 0xff;
		SET_SIGN (src);
		SET_ZERO (src);

		STORE_ZERO (p1 + XR, (src));;
		clkcount = 6;
	      }

	      break;

	    case 55:
	      {
		BYTE p1 = LOAD (PC + 1);
		unsigned int src = LOAD_ZERO (p1 + XR);
		PC += 2;

		/* src = rol(src); AC = and(src); */

		src <<= 1;
		if (IF_CARRY ())	/* ROL+AND */
		  src |= 0x1;
		SET_CARRY (src > 0xff);
		src &= 0xff;

		AC &= src;
		SET_SIGN (AC);
		SET_ZERO (AC);
		/* rotated, not disturbed */
		STORE_ZERO (p1 + XR, (src));;
		clkcount = 6;
	      }

	      break;

	    case 56:
	      {
		PC++;


		SET_CARRY ((1));;
		clkcount = 2;
	      }

	      break;

	    case 57:
/*  AND,    ABSOLUTE_Y */
	      {
		unsigned short p2 = load_abs_addr ();
		unsigned int src = LOAD (p2 + YR);
		PC += 3;
		if (pagetest (p2, YR))
		  /* Over page */
		  clkcount = 5;
		else
		  /* Same page */
		  clkcount = 4;
		src &= AC;
		SET_SIGN (src);
		SET_ZERO (src);

		AC = (src);
	      }

	      break;

	    case 58:
	      {
		PC++;

		clkcount = 2;
	      }

	      break;

	    case 59:
	      {
		unsigned short p2 = load_abs_addr ();
		unsigned int src = LOAD (p2 + YR);
		PC += 3;

		/* src = rol(src); AC = and(src); */

		src <<= 1;
		if (IF_CARRY ())	/* ROL+AND */
		  src |= 0x1;
		SET_CARRY (src > 0xff);
		src &= 0xff;

		AC &= src;
		SET_SIGN (AC);
		SET_ZERO (AC);
		/* rotated, not disturbed */
		STORE (p2 + YR, (src));;
		clkcount = 7;
	      }

	      break;

	    case 60:
	      {
		PC += 3;

		clkcount = 4;
	      }

	      break;

	    case 61:
/*   AND,    ABSOLUTE_X */
	      {
		unsigned short p2 = load_abs_addr ();
		unsigned int src = LOAD (p2 + XR);
		PC += 3;
		if (pagetest (p2, XR))
		  /* Over page */
		  clkcount = 5;
		else
		  /* Same page */
		  clkcount = 4;
		src &= AC;
		SET_SIGN (src);
		SET_ZERO (src);

		AC = (src);;
	      }

	      break;

	    case 62:
	      {
		unsigned short p2 = load_abs_addr ();
		unsigned int src = LOAD (p2 + XR);
		PC += 3;

		src <<= 1;
		if (IF_CARRY ())
		  src |= 0x1;
		SET_CARRY (src > 0xff);
		src &= 0xff;
		SET_SIGN (src);
		SET_ZERO (src);

		STORE (p2 + XR, (src));;
		clkcount = 7;
	      }

	      break;

	    case 63:
	      {
		unsigned short p2 = load_abs_addr ();
		unsigned int src = LOAD (p2 + XR);
		PC += 3;

		/* src = rol(src); AC = and(src); */

		src <<= 1;
		if (IF_CARRY ())	/* ROL+AND */
		  src |= 0x1;
		SET_CARRY (src > 0xff);
		src &= 0xff;

		AC &= src;
		SET_SIGN (AC);
		SET_ZERO (AC);
		/* rotated, not disturbed */
		STORE (p2 + XR, (src));;
		clkcount = 7;
	      }

	      break;

	    case 64:
	      {
		unsigned int src;
		PC++;
		/* Return from interrupt. */
		/* Load program status and program counter from stack. */
		src = PULL ();
		SET_SR (src);
		src = PULL ();
		src |= (PULL () << 8);	/* Load return address from stack. */

#ifdef DEBUG
		if (traceflg)
		  print_stack (SP);
#endif


		PC = (src);;
		clkcount = 6;
	      }

	      break;

	    case 65:
	      {
		BYTE p1 = LOAD (PC + 1);
		unsigned int src = LOAD (LOAD_ZERO_ADDR (p1 + XR));
		PC += 2;

		src ^= AC;
		SET_SIGN (src);
		SET_ZERO (src);

		AC = (src & 0xff);;
		clkcount = 6;
	      }

	      break;

	    case 66:
	      {
		PC++;
		/* No such opcode. */
		--PC;
#ifdef DEBUG
		verflg = 1;
		(void) printf ("Illegal instruction.\n");
		show ();
#endif
		mon (PC);
	      }

	      break;

	    case 67:
	      {
		BYTE p1 = LOAD (PC + 1);
		unsigned int src = LOAD (LOAD_ZERO_ADDR (p1 + XR));
		PC += 2;

		/* src = lsr(src); AC = eor(src); */

		SET_CARRY (src & 0x01);		/* LSR+EOR */
		src >>= 1;
		src ^= AC;
		src &= 0xff;
		SET_SIGN (src);
		SET_ZERO (src);


		STORE (LOAD_ZERO_ADDR (p1 + XR), (src));;
		clkcount = 8;
	      }

	      break;

	    case 68:
	      {
		PC += 2;

		clkcount = 3;
	      }

	      break;

	    case 69:
	      {
		BYTE p1 = LOAD (PC + 1);
		unsigned int src = LOAD_ZERO (p1);
		PC += 2;

		src ^= AC;
		SET_SIGN (src);
		SET_ZERO (src);

		AC = (src & 0xff);;
		clkcount = 3;
	      }

	      break;

	    case 70:
	      {
		BYTE p1 = LOAD (PC + 1);
		unsigned int src = LOAD_ZERO (p1);
		PC += 2;

		SET_CARRY (src & 0x01);
		src >>= 1;

		SET_SIGN (src);
		SET_ZERO (src);

		STORE_ZERO (p1, (src));;
		clkcount = 5;
	      }

	      break;

	    case 71:
	      {
		BYTE p1 = LOAD (PC + 1);
		unsigned int src = LOAD_ZERO (p1);
		PC += 2;

		/* src = lsr(src); AC = eor(src); */

		SET_CARRY (src & 0x01);		/* LSR+EOR */
		src >>= 1;
		src ^= AC;
		src &= 0xff;
		SET_SIGN (src);
		SET_ZERO (src);


		STORE_ZERO (p1, (src));;
		clkcount = 5;
	      }

	      break;

	    case 72:
/*   PHA,    IMPLIED */
	      {
		unsigned int src = AC;
		PC++;

		beamadj = BEAMNINE;
		PUSH (src);
		/* First push item onto stack and then decrement SP. */
		clkcount = 3;
	      }

	      break;

	    case 73:
	      {
		BYTE p1 = LOAD (PC + 1);
		unsigned int src = p1;
		PC += 2;

		src ^= AC;
		SET_SIGN (src);
		SET_ZERO (src);

		AC = (src & 0xff);;
		clkcount = 2;
	      }

	      break;

	    case 74:
	      {
		unsigned int src = AC;
		PC++;

		SET_CARRY (src & 0x01);
		src >>= 1;

		SET_SIGN (src);
		SET_ZERO (src);

		AC = (src);;
		clkcount = 2;
	      }

	      break;

	    case 75:
	      {
		BYTE p1 = LOAD (PC + 1);
		unsigned int src = (AC & p1);
		PC += 2;

		SET_CARRY (src & 0x01);
		src >>= 1;

		SET_SIGN (src);
		SET_ZERO (src);

		AC = (src);;
		clkcount = 2;
	      }

	      break;

	    case 76:
	      {
		unsigned short p2 = load_abs_addr ();
		unsigned int src = p2;
		PC += 3;


		PC = (src);;
		clkcount = 3;
	      }

	      break;

	    case 77:
	      {
		unsigned short p2 = load_abs_addr ();
		unsigned int src = LOAD (p2);
		PC += 3;

		src ^= AC;
		SET_SIGN (src);
		SET_ZERO (src);

		AC = (src & 0xff);;
		clkcount = 4;
	      }

	      break;

	    case 78:
	      {
		unsigned short p2 = load_abs_addr ();
		unsigned int src = LOAD (p2);
		PC += 3;

		SET_CARRY (src & 0x01);
		src >>= 1;

		SET_SIGN (src);
		SET_ZERO (src);

		STORE (p2, (src));;
		clkcount = 6;
	      }

	      break;

	    case 79:
	      {
		unsigned short p2 = load_abs_addr ();
		unsigned int src = LOAD (p2);
		PC += 3;

		/* src = lsr(src); AC = eor(src); */

		SET_CARRY (src & 0x01);		/* LSR+EOR */
		src >>= 1;
		src ^= AC;
		src &= 0xff;
		SET_SIGN (src);
		SET_ZERO (src);


		STORE (p2, (src));;
		clkcount = 6;
	      }

	      break;

	    case 80:
/*   BVC,    RELATIVE */
	      {
		BYTE p1 = LOAD (PC + 1);
		unsigned int src = p1;
		BYTE hb;
		PC += 2;
		/* Branch if overflow flag is clear. */
		if (!IF_OVERFLOW ())
		  {
		    hb = UPPER (PC);
		    PC = REL_ADDR (PC, src);
		    if (brtest (hb))
		      /* Same page */
		      clkcount = 3;
		    else
		      /* Different page */
		      clkcount = 4;
		  }
		else
		  clkcount = 2;
	      }

	      break;

	    case 81:
/* EOR,    INDIRECT_Y */
	      {
		BYTE p1 = LOAD (PC + 1);
		unsigned short p2 = LOAD_ZERO_ADDR (p1);
		unsigned int src = LOAD (p2 + YR);
		PC += 2;
		if (pagetest (p2, YR))
		  /* Over page */
		  clkcount = 6;
		else
		  /* Same page */
		  clkcount = 5;

		src ^= AC;
		SET_SIGN (src);
		SET_ZERO (src);

		AC = (src & 0xff);;
	      }

	      break;

	    case 82:
	      {
		PC++;
		/* No such opcode. */
		--PC;
#ifdef notdef
		(void) printf ("Illegal instruction.\n");
		verflg = 1;
		show ();
#endif
		mon (PC);
	      }

	      break;

	    case 83:
	      {
		BYTE p1 = LOAD (PC + 1);
		unsigned int src = LOAD (LOAD_ZERO_ADDR (p1) + YR);
		PC += 2;

		/* src = lsr(src); AC = eor(src); */

		SET_CARRY (src & 0x01);		/* LSR+EOR */
		src >>= 1;
		src ^= AC;
		src &= 0xff;
		SET_SIGN (src);
		SET_ZERO (src);


		STORE (LOAD_ZERO_ADDR (p1) + YR, (src));;
		clkcount = 8;
	      }

	      break;

	    case 84:
	      {
		PC += 2;

		clkcount = 4;
	      }

	      break;

	    case 85:
	      {
		BYTE p1 = LOAD (PC + 1);
		unsigned int src = LOAD_ZERO (p1 + XR);
		PC += 2;

		src ^= AC;
		SET_SIGN (src);
		SET_ZERO (src);

		AC = (src & 0xff);;
		clkcount = 4;
	      }

	      break;

	    case 86:
	      {
		BYTE p1 = LOAD (PC + 1);
		unsigned int src = LOAD_ZERO (p1 + XR);
		PC += 2;

		SET_CARRY (src & 0x01);
		src >>= 1;

		SET_SIGN (src);
		SET_ZERO (src);

		STORE_ZERO (p1 + XR, (src));;
		clkcount = 6;
	      }

	      break;

	    case 87:
	      {
		BYTE p1 = LOAD (PC + 1);
		unsigned int src = LOAD_ZERO (p1 + XR);
		PC += 2;

		/* src = lsr(src); AC = eor(src); */

		SET_CARRY (src & 0x01);		/* LSR+EOR */
		src >>= 1;
		src ^= AC;
		src &= 0xff;
		SET_SIGN (src);
		SET_ZERO (src);


		STORE_ZERO (p1 + XR, (src));;
		clkcount = 6;
	      }

	      break;

	    case 88:
	      {
		PC++;


		SET_INTERRUPT ((0));;
		clkcount = 2;
	      }

	      break;

	    case 89:
/*  EOR,    ABSOLUTE_Y */
	      {
		unsigned short p2 = load_abs_addr ();
		unsigned int src = LOAD (p2 + YR);
		PC += 3;
		if (pagetest (p2, YR))
		  /* Over page */
		  clkcount = 5;
		else
		  /* Same page */
		  clkcount = 4;

		src ^= AC;
		SET_SIGN (src);
		SET_ZERO (src);

		AC = (src & 0xff);
	      }

	      break;

	    case 90:
	      {
		PC++;

		clkcount = 2;
	      }

	      break;

	    case 91:
	      {
		unsigned short p2 = load_abs_addr ();
		unsigned int src = LOAD (p2 + YR);
		PC += 3;

		/* src = lsr(src); AC = eor(src); */

		SET_CARRY (src & 0x01);		/* LSR+EOR */
		src >>= 1;
		src ^= AC;
		src &= 0xff;
		SET_SIGN (src);
		SET_ZERO (src);


		STORE (p2 + YR, (src));;
		clkcount = 7;
	      }

	      break;

	    case 92:
	      {
		PC += 3;

		clkcount = 4;
	      }

	      break;

	    case 93:
/*  EOR,    ABSOLUTE_X */
	      {
		unsigned short p2 = load_abs_addr ();
		unsigned int src = LOAD (p2 + XR);
		PC += 3;
		if (pagetest (p2, XR))
		  /* Over page */
		  clkcount = 5;
		else
		  /* Same page */
		  clkcount = 4;

		src ^= AC;
		SET_SIGN (src);
		SET_ZERO (src);

		AC = (src & 0xff);;
	      }

	      break;

	    case 94:
	      {
		unsigned short p2 = load_abs_addr ();
		unsigned int src = LOAD (p2 + XR);
		PC += 3;

		SET_CARRY (src & 0x01);
		src >>= 1;

		SET_SIGN (src);
		SET_ZERO (src);

		STORE (p2 + XR, (src));;
		clkcount = 7;
	      }

	      break;

	    case 95:
	      {
		unsigned short p2 = load_abs_addr ();
		unsigned int src = LOAD (p2 + XR);
		PC += 3;

		/* src = lsr(src); AC = eor(src); */

		SET_CARRY (src & 0x01);		/* LSR+EOR */
		src >>= 1;
		src ^= AC;
		src &= 0xff;
		SET_SIGN (src);
		SET_ZERO (src);


		STORE (p2 + XR, (src));;
		clkcount = 7;
	      }

	      break;

	    case 96:
	      {
		unsigned int src;
		PC++;
		/* Return from subroutine. */
		src = PULL ();
		src += ((PULL ()) << 8) + 1;	/* Load return address from stack and add 1. */

#ifdef DEBUG
		if (traceflg)
		  print_stack (SP);
#endif


		PC = (src);;
		clkcount = 6;
	      }

	      break;

	    case 97:
	      {
		BYTE p1 = LOAD (PC + 1);
		unsigned int src = LOAD (LOAD_ZERO_ADDR (p1 + XR));
		unsigned int temp = src + AC + (IF_CARRY ()? 1 : 0);
		PC += 2;


		SET_ZERO (temp & 0xff);		/* This is not valid in decimal mode */

		/*
		 * In decimal mode this is "correct" but not exact emulation. However,
		 * the probability of different result when using undefined BCD codes is
		 * less than 6%
		 * Sign and Overflow are set between BCD fixup of the two digits  -MSM
		 */

		if (IF_DECIMAL ())
		  {
		    if (((AC & 0xf) + (src & 0xf) + (IF_CARRY ()? 1 : 0)) > 9)
		      temp += 6;

		    SET_SIGN (temp);
		    SET_OVERFLOW (!((AC ^ src) & 0x80) && ((AC ^ temp) & 0x80));

		    if (temp > 0x99)
		      temp += 96;

		    SET_CARRY (temp > 0x99);
		  }
		else
		  {
		    SET_SIGN (temp);
		    SET_OVERFLOW (!((AC ^ src) & 0x80) && ((AC ^ temp) & 0x80));
		    SET_CARRY (temp > 0xff);
		  }

		AC = ((BYTE) temp);;
		clkcount = 6;
	      }

	      break;

	    case 98:
	      {
		PC++;
		/* No such opcode. */
		--PC;
#ifdef notdef
		(void) printf ("Illegal instruction.\n");
		verflg = 1;
		show ();
#endif
		mon (PC);
	      }

	      break;

	    case 99:
	      {
		BYTE p1 = LOAD (PC + 1);
		unsigned int src = LOAD (LOAD_ZERO_ADDR (p1 + XR));
		unsigned int temp;
		PC += 2;


		/* src = ror(src); AC = adc(src);
		 * the real operation discovered by msmakela
		 * ADC only does the BCD fixup */

		temp = src >> 1;	/* ROR+ADC */
		if (IF_CARRY ())
		  temp |= 0x80;

		SET_SIGN (temp);
		SET_ZERO (temp);	/* Set flags like ROR does */

		SET_OVERFLOW ((temp ^ src) & 0x40);	/* ROR causes this ? */

		if (IF_DECIMAL ())
		  {
		    if ((src & 0x0f) > 4)	/* half of the normal */
		      temp = (temp & 0xf0) | ((temp + 6) & 0xf);
		    if (src > 0x4f)
		      temp += 96;

		    SET_CARRY (src > 0x4f);
		  }
		else
		  {
		    SET_CARRY (src & 0x80);	/* 8502 behaviour */
		  }


		STORE (LOAD_ZERO_ADDR (p1 + XR), ((BYTE) temp));;
		clkcount = 8;
	      }

	      break;

	    case 100:
	      {
		PC += 2;

		clkcount = 3;
	      }

	      break;

	    case 101:
	      {
		BYTE p1 = LOAD (PC + 1);
		unsigned int src = LOAD_ZERO (p1);
		unsigned int temp = src + AC + (IF_CARRY ()? 1 : 0);
		PC += 2;


		SET_ZERO (temp & 0xff);		/* This is not valid in decimal mode */

		/*
		 * In decimal mode this is "correct" but not exact emulation. However,
		 * the probability of different result when using undefined BCD codes is
		 * less than 6%
		 * Sign and Overflow are set between BCD fixup of the two digits  -MSM
		 */

		if (IF_DECIMAL ())
		  {
		    if (((AC & 0xf) + (src & 0xf) + (IF_CARRY ()? 1 : 0)) > 9)
		      temp += 6;

		    SET_SIGN (temp);
		    SET_OVERFLOW (!((AC ^ src) & 0x80) && ((AC ^ temp) & 0x80));

		    if (temp > 0x99)
		      temp += 96;

		    SET_CARRY (temp > 0x99);
		  }
		else
		  {
		    SET_SIGN (temp);
		    SET_OVERFLOW (!((AC ^ src) & 0x80) && ((AC ^ temp) & 0x80));
		    SET_CARRY (temp > 0xff);
		  }

		AC = ((BYTE) temp);;
		clkcount = 3;
	      }

	      break;

	    case 102:
	      {
		BYTE p1 = LOAD (PC + 1);
		unsigned int src = LOAD_ZERO (p1);
		PC += 2;

		if (IF_CARRY ())
		  src |= 0x100;
		SET_CARRY (src & 0x01);
		src >>= 1;

		SET_SIGN (src);
		SET_ZERO (src);

		STORE_ZERO (p1, (src));;
		clkcount = 5;
	      }

	      break;

	    case 103:
	      {
		BYTE p1 = LOAD (PC + 1);
		unsigned int src = LOAD_ZERO (p1);
		unsigned int temp;
		PC += 2;


		/* src = ror(src); AC = adc(src);
		 * the real operation discovered by msmakela
		 * ADC only does the BCD fixup */

		temp = src >> 1;	/* ROR+ADC */
		if (IF_CARRY ())
		  temp |= 0x80;

		SET_SIGN (temp);
		SET_ZERO (temp);	/* Set flags like ROR does */

		SET_OVERFLOW ((temp ^ src) & 0x40);	/* ROR causes this ? */

		if (IF_DECIMAL ())
		  {
		    if ((src & 0x0f) > 4)	/* half of the normal */
		      temp = (temp & 0xf0) | ((temp + 6) & 0xf);
		    if (src > 0x4f)
		      temp += 96;

		    SET_CARRY (src > 0x4f);
		  }
		else
		  {
		    SET_CARRY (src & 0x80);	/* 8502 behaviour */
		  }


		STORE_ZERO (p1, ((BYTE) temp));;
		clkcount = 5;
	      }

	      break;

	    case 104:
/*   PLA,    IMPLIED */
	      {
		unsigned int src;
		PC++;

		clkcount = 4;
		/* First increment stack pointer and then pull item from stack. */
		src = PULL ();
		SET_SIGN (src);	/* Change sign and zero flag accordingly. */
		SET_ZERO (src);

		AC = (src);
	      }

	      break;

	    case 105:
	      {
		BYTE p1 = LOAD (PC + 1);
		unsigned int src = p1;
		unsigned int temp = src + AC + (IF_CARRY ()? 1 : 0);
		PC += 2;


		SET_ZERO (temp & 0xff);		/* This is not valid in decimal mode */

		/*
		 * In decimal mode this is "correct" but not exact emulation. However,
		 * the probability of different result when using undefined BCD codes is
		 * less than 6%
		 * Sign and Overflow are set between BCD fixup of the two digits  -MSM
		 */

		if (IF_DECIMAL ())
		  {
		    if (((AC & 0xf) + (src & 0xf) + (IF_CARRY ()? 1 : 0)) > 9)
		      temp += 6;

		    SET_SIGN (temp);
		    SET_OVERFLOW (!((AC ^ src) & 0x80) && ((AC ^ temp) & 0x80));

		    if (temp > 0x99)
		      temp += 96;

		    SET_CARRY (temp > 0x99);
		  }
		else
		  {
		    SET_SIGN (temp);
		    SET_OVERFLOW (!((AC ^ src) & 0x80) && ((AC ^ temp) & 0x80));
		    SET_CARRY (temp > 0xff);
		  }

		AC = ((BYTE) temp);;
		clkcount = 2;
	      }

	      break;

	    case 106:
	      {
		unsigned int src = AC;
		PC++;

		if (IF_CARRY ())
		  src |= 0x100;
		SET_CARRY (src & 0x01);
		src >>= 1;

		SET_SIGN (src);
		SET_ZERO (src);

		AC = (src);;
		clkcount = 2;
	      }

	      break;

	    case 107:
	      {
		BYTE p1 = LOAD (PC + 1);
		unsigned int src = (AC & p1);
		PC += 2;

		if (IF_CARRY ())
		  src |= 0x100;
		SET_CARRY (src & 0x01);
		src >>= 1;

		SET_SIGN (src);
		SET_ZERO (src);

		AC = (src);;
		clkcount = 2;
	      }

	      break;

	    case 108:
	      {
		unsigned short p2 = load_abs_addr ();
		unsigned int src = LOAD_ADDR (p2);
		PC += 3;


		PC = (src);;
		clkcount = 5;
	      }

	      break;

	    case 109:
	      {
		unsigned short p2 = load_abs_addr ();
		unsigned int src = LOAD (p2);
		unsigned int temp = src + AC + (IF_CARRY ()? 1 : 0);
		PC += 3;


		SET_ZERO (temp & 0xff);		/* This is not valid in decimal mode */

		/*
		 * In decimal mode this is "correct" but not exact emulation. However,
		 * the probability of different result when using undefined BCD codes is
		 * less than 6%
		 * Sign and Overflow are set between BCD fixup of the two digits  -MSM
		 */

		if (IF_DECIMAL ())
		  {
		    if (((AC & 0xf) + (src & 0xf) + (IF_CARRY ()? 1 : 0)) > 9)
		      temp += 6;

		    SET_SIGN (temp);
		    SET_OVERFLOW (!((AC ^ src) & 0x80) && ((AC ^ temp) & 0x80));

		    if (temp > 0x99)
		      temp += 96;

		    SET_CARRY (temp > 0x99);
		  }
		else
		  {
		    SET_SIGN (temp);
		    SET_OVERFLOW (!((AC ^ src) & 0x80) && ((AC ^ temp) & 0x80));
		    SET_CARRY (temp > 0xff);
		  }

		AC = ((BYTE) temp);;
		clkcount = 4;
	      }

	      break;

	    case 110:
	      {
		unsigned short p2 = load_abs_addr ();
		unsigned int src = LOAD (p2);
		PC += 3;

		if (IF_CARRY ())
		  src |= 0x100;
		SET_CARRY (src & 0x01);
		src >>= 1;

		SET_SIGN (src);
		SET_ZERO (src);

		STORE (p2, (src));;
		clkcount = 6;
	      }

	      break;

	    case 111:
	      {
		unsigned short p2 = load_abs_addr ();
		unsigned int src = LOAD (p2);
		unsigned int temp;
		PC += 3;


		/* src = ror(src); AC = adc(src);
		 * the real operation discovered by msmakela
		 * ADC only does the BCD fixup */

		temp = src >> 1;	/* ROR+ADC */
		if (IF_CARRY ())
		  temp |= 0x80;

		SET_SIGN (temp);
		SET_ZERO (temp);	/* Set flags like ROR does */

		SET_OVERFLOW ((temp ^ src) & 0x40);	/* ROR causes this ? */

		if (IF_DECIMAL ())
		  {
		    if ((src & 0x0f) > 4)	/* half of the normal */
		      temp = (temp & 0xf0) | ((temp + 6) & 0xf);
		    if (src > 0x4f)
		      temp += 96;

		    SET_CARRY (src > 0x4f);
		  }
		else
		  {
		    SET_CARRY (src & 0x80);	/* 8502 behaviour */
		  }


		STORE (p2, ((BYTE) temp));;
		clkcount = 6;
	      }

	      break;

	    case 112:
/*   BVS,    RELATIVE */
	      {
		BYTE p1 = LOAD (PC + 1);
		unsigned int src = p1;
		BYTE hb;
		PC += 2;
		/* Branch if overflow flag is set. */
		if (IF_OVERFLOW ())
		  {
		    hb = UPPER (PC);
		    PC = REL_ADDR (PC, src);
		    if (brtest (hb))
		      /* Same page */
		      clkcount = 3;
		    else
		      /* Different page */
		      clkcount = 4;
		  }
		else
		  clkcount = 2;
	      }

	      break;

	    case 113:
	      {
		BYTE p1 = LOAD (PC + 1);
		ADDRESS p2 = LOAD_ZERO_ADDR (p1);
		unsigned int src = LOAD (p2 + YR);
		unsigned int temp = src + AC + (IF_CARRY ()? 1 : 0);
		PC += 2;

		if (pagetest (p2, YR))
		  /* Over page */
		  clkcount = 6;
		else
		  /* Same page */
		  clkcount = 5;

		SET_ZERO (temp & 0xff);		/* This is not valid in decimal mode */

		/*
		 * In decimal mode this is "correct" but not exact emulation. However,
		 * the probability of different result when using undefined BCD codes is
		 * less than 6%
		 * Sign and Overflow are set between BCD fixup of the two digits  -MSM
		 */

		if (IF_DECIMAL ())
		  {
		    if (((AC & 0xf) + (src & 0xf) + (IF_CARRY ()? 1 : 0)) > 9)
		      temp += 6;

		    SET_SIGN (temp);
		    SET_OVERFLOW (!((AC ^ src) & 0x80) && ((AC ^ temp) & 0x80));

		    if (temp > 0x99)
		      temp += 96;

		    SET_CARRY (temp > 0x99);
		  }
		else
		  {
		    SET_SIGN (temp);
		    SET_OVERFLOW (!((AC ^ src) & 0x80) && ((AC ^ temp) & 0x80));
		    SET_CARRY (temp > 0xff);
		  }

		AC = ((BYTE) temp);
	      }

	      break;

	    case 114:
	      {
		PC++;
		/* No such opcode. */
		--PC;
#ifdef notdef
		(void) printf ("Illegal instruction.\n");
		verflg = 1;
		show ();
#endif
		mon (PC);
	      }

	      break;

	    case 115:
	      {
		BYTE p1 = LOAD (PC + 1);
		unsigned int src = LOAD (LOAD_ZERO_ADDR (p1) + YR);
		unsigned int temp;
		PC += 2;


		/* src = ror(src); AC = adc(src);
		 * the real operation discovered by msmakela
		 * ADC only does the BCD fixup */

		temp = src >> 1;	/* ROR+ADC */
		if (IF_CARRY ())
		  temp |= 0x80;

		SET_SIGN (temp);
		SET_ZERO (temp);	/* Set flags like ROR does */

		SET_OVERFLOW ((temp ^ src) & 0x40);	/* ROR causes this ? */

		if (IF_DECIMAL ())
		  {
		    if ((src & 0x0f) > 4)	/* half of the normal */
		      temp = (temp & 0xf0) | ((temp + 6) & 0xf);
		    if (src > 0x4f)
		      temp += 96;

		    SET_CARRY (src > 0x4f);
		  }
		else
		  {
		    SET_CARRY (src & 0x80);	/* 8502 behaviour */
		  }


		STORE (LOAD_ZERO_ADDR (p1) + YR, ((BYTE) temp));;
		clkcount = 8;
	      }

	      break;

	    case 116:
	      {
		PC += 2;

		clkcount = 4;
	      }

	      break;

	    case 117:
	      {
		BYTE p1 = LOAD (PC + 1);
		unsigned int src = LOAD_ZERO (p1 + XR);
		unsigned int temp = src + AC + (IF_CARRY ()? 1 : 0);
		PC += 2;


		SET_ZERO (temp & 0xff);		/* This is not valid in decimal mode */

		/*
		 * In decimal mode this is "correct" but not exact emulation. However,
		 * the probability of different result when using undefined BCD codes is
		 * less than 6%
		 * Sign and Overflow are set between BCD fixup of the two digits  -MSM
		 */

		if (IF_DECIMAL ())
		  {
		    if (((AC & 0xf) + (src & 0xf) + (IF_CARRY ()? 1 : 0)) > 9)
		      temp += 6;

		    SET_SIGN (temp);
		    SET_OVERFLOW (!((AC ^ src) & 0x80) && ((AC ^ temp) & 0x80));

		    if (temp > 0x99)
		      temp += 96;

		    SET_CARRY (temp > 0x99);
		  }
		else
		  {
		    SET_SIGN (temp);
		    SET_OVERFLOW (!((AC ^ src) & 0x80) && ((AC ^ temp) & 0x80));
		    SET_CARRY (temp > 0xff);
		  }

		AC = ((BYTE) temp);;
		clkcount = 4;
	      }

	      break;

	    case 118:
	      {
		BYTE p1 = LOAD (PC + 1);
		unsigned int src = LOAD_ZERO (p1 + XR);
		PC += 2;

		if (IF_CARRY ())
		  src |= 0x100;
		SET_CARRY (src & 0x01);
		src >>= 1;

		SET_SIGN (src);
		SET_ZERO (src);

		STORE_ZERO (p1 + XR, (src));;
		clkcount = 6;
	      }

	      break;

	    case 119:
	      {
		BYTE p1 = LOAD (PC + 1);
		unsigned int src = LOAD_ZERO (p1 + XR);
		unsigned int temp;
		PC += 2;


		/* src = ror(src); AC = adc(src);
		 * the real operation discovered by msmakela
		 * ADC only does the BCD fixup */

		temp = src >> 1;	/* ROR+ADC */
		if (IF_CARRY ())
		  temp |= 0x80;

		SET_SIGN (temp);
		SET_ZERO (temp);	/* Set flags like ROR does */

		SET_OVERFLOW ((temp ^ src) & 0x40);	/* ROR causes this ? */

		if (IF_DECIMAL ())
		  {
		    if ((src & 0x0f) > 4)	/* half of the normal */
		      temp = (temp & 0xf0) | ((temp + 6) & 0xf);
		    if (src > 0x4f)
		      temp += 96;

		    SET_CARRY (src > 0x4f);
		  }
		else
		  {
		    SET_CARRY (src & 0x80);	/* 8502 behaviour */
		  }


		STORE_ZERO (p1 + XR, ((BYTE) temp));;
		clkcount = 6;
	      }

	      break;

	    case 120:
	      {
		PC++;


		SET_INTERRUPT ((1));;
		clkcount = 2;
	      }

	      break;

	    case 121:
/*   ADC,    ABSOLUTE_Y */
	      {
		unsigned short p2 = load_abs_addr ();
		unsigned int src = LOAD (p2 + YR);
		unsigned int temp = src + AC + (IF_CARRY ()? 1 : 0);
		PC += 3;

		if (pagetest (p2, YR))
		  /* Over page */
		  clkcount = 5;
		else
		  /* Same page */
		  clkcount = 4;

		SET_ZERO (temp & 0xff);		/* This is not valid in decimal mode */

		/*
		 * In decimal mode this is "correct" but not exact emulation. However,
		 * the probability of different result when using undefined BCD codes is
		 * less than 6%
		 * Sign and Overflow are set between BCD fixup of the two digits  -MSM
		 */

		if (IF_DECIMAL ())
		  {
		    if (((AC & 0xf) + (src & 0xf) + (IF_CARRY ()? 1 : 0)) > 9)
		      temp += 6;

		    SET_SIGN (temp);
		    SET_OVERFLOW (!((AC ^ src) & 0x80) && ((AC ^ temp) & 0x80));

		    if (temp > 0x99)
		      temp += 96;

		    SET_CARRY (temp > 0x99);
		  }
		else
		  {
		    SET_SIGN (temp);
		    SET_OVERFLOW (!((AC ^ src) & 0x80) && ((AC ^ temp) & 0x80));
		    SET_CARRY (temp > 0xff);
		  }

		AC = ((BYTE) temp);
	      }

	      break;

	    case 122:
	      {
		PC++;

		clkcount = 2;
	      }

	      break;

	    case 123:
	      {
		unsigned short p2 = load_abs_addr ();
		unsigned int src = LOAD (p2 + YR);
		unsigned int temp;
		PC += 3;


		/* src = ror(src); AC = adc(src);
		 * the real operation discovered by msmakela
		 * ADC only does the BCD fixup */

		temp = src >> 1;	/* ROR+ADC */
		if (IF_CARRY ())
		  temp |= 0x80;

		SET_SIGN (temp);
		SET_ZERO (temp);	/* Set flags like ROR does */

		SET_OVERFLOW ((temp ^ src) & 0x40);	/* ROR causes this ? */

		if (IF_DECIMAL ())
		  {
		    if ((src & 0x0f) > 4)	/* half of the normal */
		      temp = (temp & 0xf0) | ((temp + 6) & 0xf);
		    if (src > 0x4f)
		      temp += 96;

		    SET_CARRY (src > 0x4f);
		  }
		else
		  {
		    SET_CARRY (src & 0x80);	/* 8502 behaviour */
		  }


		STORE (p2 + YR, ((BYTE) temp));;
		clkcount = 7;
	      }

	      break;

	    case 124:
	      {
		PC += 3;

		clkcount = 4;
	      }

	      break;

	    case 125:
/*  ADC,    ABSOLUTE_X */
	      {
		unsigned short p2 = load_abs_addr ();
		unsigned int src = LOAD (p2 + XR);
		unsigned int temp = src + AC + (IF_CARRY ()? 1 : 0);
		PC += 3;

		if (pagetest (p2, XR))
		  /* Over page */
		  clkcount = 5;
		else
		  /* Same page */
		  clkcount = 4;

		SET_ZERO (temp & 0xff);		/* This is not valid in decimal mode */

		/*
		 * In decimal mode this is "correct" but not exact emulation. However,
		 * the probability of different result when using undefined BCD codes is
		 * less than 6%
		 * Sign and Overflow are set between BCD fixup of the two digits  -MSM
		 */

		if (IF_DECIMAL ())
		  {
		    if (((AC & 0xf) + (src & 0xf) + (IF_CARRY ()? 1 : 0)) > 9)
		      temp += 6;

		    SET_SIGN (temp);
		    SET_OVERFLOW (!((AC ^ src) & 0x80) && ((AC ^ temp) & 0x80));

		    if (temp > 0x99)
		      temp += 96;

		    SET_CARRY (temp > 0x99);
		  }
		else
		  {
		    SET_SIGN (temp);
		    SET_OVERFLOW (!((AC ^ src) & 0x80) && ((AC ^ temp) & 0x80));
		    SET_CARRY (temp > 0xff);
		  }

		AC = ((BYTE) temp);
	      }

	      break;

	    case 126:
	      {
		unsigned short p2 = load_abs_addr ();
		unsigned int src = LOAD (p2 + XR);
		PC += 3;

		if (IF_CARRY ())
		  src |= 0x100;
		SET_CARRY (src & 0x01);
		src >>= 1;

		SET_SIGN (src);
		SET_ZERO (src);

		STORE (p2 + XR, (src));;
		clkcount = 7;
	      }

	      break;

	    case 127:
	      {
		unsigned short p2 = load_abs_addr ();
		unsigned int src = LOAD (p2 + XR);
		unsigned int temp;
		PC += 3;


		/* src = ror(src); AC = adc(src);
		 * the real operation discovered by msmakela
		 * ADC only does the BCD fixup */

		temp = src >> 1;	/* ROR+ADC */
		if (IF_CARRY ())
		  temp |= 0x80;

		SET_SIGN (temp);
		SET_ZERO (temp);	/* Set flags like ROR does */

		SET_OVERFLOW ((temp ^ src) & 0x40);	/* ROR causes this ? */

		if (IF_DECIMAL ())
		  {
		    if ((src & 0x0f) > 4)	/* half of the normal */
		      temp = (temp & 0xf0) | ((temp + 6) & 0xf);
		    if (src > 0x4f)
		      temp += 96;

		    SET_CARRY (src > 0x4f);
		  }
		else
		  {
		    SET_CARRY (src & 0x80);	/* 8502 behaviour */
		  }


		STORE (p2 + XR, ((BYTE) temp));;
		clkcount = 7;
	      }

	      break;

	    case 128:
	      {
		PC += 2;

		clkcount = 2;
	      }

	      break;

	    case 129:
	      {
		BYTE p1 = LOAD (PC + 1);
		unsigned int src = AC;
		PC += 2;


		STORE (LOAD_ZERO_ADDR (p1 + XR), (src));;
		clkcount = 6;
	      }

	      break;

	    case 130:
	      {
		PC += 2;

		clkcount = 2;
	      }

	      break;

	    case 131:
	      {
		BYTE p1 = LOAD (PC + 1);
		unsigned int src = (AC & XR);
		PC += 2;


		STORE (LOAD_ZERO_ADDR (p1 + XR), (src));;
		clkcount = 6;
	      }

	      break;

	    case 132:
/*  STY,    ZERO_PAGE */
	      {
		BYTE p1 = LOAD (PC + 1);
		unsigned int src = YR;

		clkcount = 3;
		PC += 2;

		beamadj = BEAMNINE;
		STORE_ZERO (p1, (src));
	      }

	      break;

	    case 133:
/*   STA,    ZERO_PAGE */
	      {
		BYTE p1 = LOAD (PC + 1);
		unsigned int src = AC;

		clkcount = 3;
		PC += 2;

		beamadj = BEAMNINE;
		STORE_ZERO (p1, (src));
	      }

	      break;

	    case 134:
/*  STX,    ZERO_PAGE */
	      {
		BYTE p1 = LOAD (PC + 1);
		unsigned int src = XR;

		clkcount = 3;
		PC += 2;

		beamadj = BEAMNINE;
		STORE_ZERO (p1, (src));
	      }

	      break;

	    case 135:
	      {
		BYTE p1 = LOAD (PC + 1);
		unsigned int src = (AC & XR);
		PC += 2;


		STORE_ZERO (p1, (src));;
		clkcount = 3;
	      }

	      break;

	    case 136:
	      {
		unsigned int src = YR;
		PC++;

		src = (src - 1) & 0xff;
		SET_SIGN (src);
		SET_ZERO (src);

		YR = (src);;
		clkcount = 2;
	      }

	      break;

	    case 137:
	      {
		PC += 2;

		clkcount = 2;
	      }

	      break;

	    case 138:
	      {
		unsigned int src = XR;
		PC++;

		SET_SIGN (src);
		SET_ZERO (src);

		AC = (src);;
		clkcount = 2;
	      }

	      break;

	    case 139:
	      {
		BYTE p1 = LOAD (PC + 1);
		unsigned int src = ((AC | 0xee) & XR & p1);
		PC += 2;

		SET_SIGN (src);
		SET_ZERO (src);

		AC = (src);;
		clkcount = 2;
	      }

	      break;

	    case 140:
/*  STY,    ABSOLUTE */
	      {
		unsigned short p2 = load_abs_addr ();
		unsigned int src = YR;
		PC += 3;

		beamadj = BEAMTWELVE;
		STORE (p2, (src));;
		clkcount = 4;
	      }

	      break;

	    case 141:
/*  STA,    ABSOLUTE */
	      {
		unsigned short p2 = load_abs_addr ();
		unsigned int src = AC;
		PC += 3;

		beamadj = BEAMTWELVE;
		STORE (p2, (src));;
		clkcount = 4;
	      }

	      break;

	    case 142:
/*  STA,    ABSOLUTE */
	      {
		unsigned short p2 = load_abs_addr ();
		unsigned int src = XR;
		PC += 3;

		beamadj = BEAMTWELVE;
		STORE (p2, (src));;
		clkcount = 4;
	      }

	      break;

	    case 143:
/* STX,    ABSOLUTE */
	      {
		unsigned short p2 = load_abs_addr ();
		unsigned int src = (AC & XR);
		PC += 3;

		beamadj = BEAMTWELVE;
		STORE (p2, (src));;
		clkcount = 4;
	      }

	      break;

	    case 144:
/*  BCC,    RELATIVE */
	      {
		BYTE p1 = LOAD (PC + 1);
		ADDRESS hb;
		unsigned int src = p1;
		PC += 2;
		/* Branch if carry flag is clear. */
		if (!IF_CARRY ())
		  {
		    hb = UPPER (PC);
		    PC = REL_ADDR (PC, src);
		    if (brtest (hb))
		      /* Same page */
		      clkcount = 3;
		    else
		      /* Different page */
		      clkcount = 4;
		  }
		else
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
		clkcount = 4;
	      }

	      break;

	    case 205:
	      {
		unsigned short p2 = load_abs_addr ();
		unsigned int src = LOAD (p2);
		PC += 3;

		src = AC - src;
		SET_CARRY (src < 0x100);
		SET_SIGN (src);
		SET_ZERO (src &= 0xff);
		clkcount = 4;
	      }

	      break;

	    case 206:
	      {
		unsigned short p2 = load_abs_addr ();
		unsigned int src = LOAD (p2);
		PC += 3;

		src = (src - 1) & 0xff;
		SET_SIGN (src);
		SET_ZERO (src);

		STORE (p2, (src));;
		clkcount = 6;
	      }

	      break;

	    case 207:
	      {
		unsigned short p2 = load_abs_addr ();
		unsigned int src = LOAD (p2);
		PC += 3;

		/* cmp(--src & 0xff));  */

		src = (src - 1) & 0xff;		/* DEC+CMP */
		SET_CARRY (AC >= src);
		SET_SIGN (AC - src);
		SET_ZERO (AC != src);

		STORE (p2, (src));;
		clkcount = 6;
	      }

	      break;

	    case 208:
/*  BNE,    RELATIVE */
	      {
		BYTE p1 = LOAD (PC + 1);
		unsigned int src = p1;
		BYTE hb;
		PC += 2;
		/* Branch if  zero flag is clear. */
		if (!IF_ZERO ())
		  {
		    hb = UPPER (PC);
		    PC = REL_ADDR (PC, src);
		    if (brtest (hb))
		      /* Same page */
		      clkcount = 3;
		    else
		      /* Different page */
		      clkcount = 4;
		  }
		else
		  clkcount = 2;
	      }

	      break;

	    case 209:
/*   CMP,    INDIRECT_Y */
	      {
		BYTE p1 = LOAD (PC + 1);
		ADDRESS p2 = LOAD_ZERO_ADDR (p1);
		unsigned int src = LOAD (p2 + YR);
		PC += 2;
		if (pagetest (p2, YR))
		  /* Over page */
		  clkcount = 6;
		else
		  /* Same page */
		  clkcount = 5;

		src = AC - src;
		SET_CARRY (src < 0x100);
		SET_SIGN (src);
		SET_ZERO (src &= 0xff);
	      }

	      break;

	    case 210:
	      {
		PC++;
		/* No such opcode. */
		--PC;
#ifdef notdef
		(void) printf ("Illegal instruction.\n");
		verflg = 1;
		show ();
#endif
		mon (PC);
	      }

	      break;

	    case 211:
	      {
		BYTE p1 = LOAD (PC + 1);
		unsigned int src = LOAD (LOAD_ZERO_ADDR (p1) + YR);
		PC += 2;

		/* cmp(--src & 0xff));  */

		src = (src - 1) & 0xff;		/* DEC+CMP */
		SET_CARRY (AC >= src);
		SET_SIGN (AC - src);
		SET_ZERO (AC != src);

		STORE (LOAD_ZERO_ADDR (p1) + YR, (src));;
		clkcount = 8;
	      }

	      break;

	    case 212:
	      {
		PC += 2;

		clkcount = 4;
	      }

	      break;

	    case 213:
	      {
		BYTE p1 = LOAD (PC + 1);
		unsigned int src = LOAD_ZERO (p1 + XR);
		PC += 2;

		src = AC - src;
		SET_CARRY (src < 0x100);
		SET_SIGN (src);
		SET_ZERO (src &= 0xff);
		clkcount = 4;
	      }

	      break;

	    case 214:
	      {
		BYTE p1 = LOAD (PC + 1);
		unsigned int src = LOAD_ZERO (p1 + XR);
		PC += 2;

		src = (src - 1) & 0xff;
		SET_SIGN (src);
		SET_ZERO (src);

		STORE_ZERO (p1 + XR, (src));;
		clkcount = 6;
	      }

	      break;

	    case 215:
	      {
		BYTE p1 = LOAD (PC + 1);
		unsigned int src = LOAD_ZERO (p1 + XR);
		PC += 2;

		/* cmp(--src & 0xff));  */

		src = (src - 1) & 0xff;		/* DEC+CMP */
		SET_CARRY (AC >= src);
		SET_SIGN (AC - src);
		SET_ZERO (AC != src);

		STORE_ZERO (p1 + XR, (src));;
		clkcount = 6;
	      }

	      break;

	    case 216:
	      {
		PC++;


		SET_DECIMAL ((0));;
		clkcount = 2;
	      }

	      break;

	    case 217:
/*   CMP,    ABSOLUTE_Y */
	      {
		unsigned short p2 = load_abs_addr ();
		unsigned int src = LOAD (p2 + YR);
		PC += 3;
		if (pagetest (p2, YR))
		  /* Over page */
		  clkcount = 5;
		else
		  /* Same page */
		  clkcount = 4;

		src = AC - src;
		SET_CARRY (src < 0x100);
		SET_SIGN (src);
		SET_ZERO (src &= 0xff);
	      }

	      break;

	    case 218:
	      {
		PC++;

		clkcount = 2;
	      }

	      break;

	    case 219:
	      {
		unsigned short p2 = load_abs_addr ();
		unsigned int src = LOAD (p2 + YR);
		PC += 3;

		/* cmp(--src & 0xff));  */

		src = (src - 1) & 0xff;		/* DEC+CMP */
		SET_CARRY (AC >= src);
		SET_SIGN (AC - src);
		SET_ZERO (AC != src);

		STORE (p2 + YR, (src));;
		clkcount = 7;
	      }

	      break;

	    case 220:
	      {
		PC += 3;

		clkcount = 4;
	      }

	      break;

	    case 221:
/*   CMP,    ABSOLUTE_X */
	      {
		unsigned short p2 = load_abs_addr ();
		unsigned int src = LOAD (p2 + XR);
		PC += 3;
		if (pagetest (p2, XR))
		  /* Over page */
		  clkcount = 5;
		else
		  /* Same page */
		  clkcount = 4;

		src = AC - src;
		SET_CARRY (src < 0x100);
		SET_SIGN (src);
		SET_ZERO (src &= 0xff);
	      }

	      break;

	    case 222:
	      {
		unsigned short p2 = load_abs_addr ();
		unsigned int src = LOAD (p2 + XR);
		PC += 3;

		src = (src - 1) & 0xff;
		SET_SIGN (src);
		SET_ZERO (src);

		STORE (p2 + XR, (src));;
		clkcount = 7;
	      }

	      break;

	    case 223:
	      {
		unsigned short p2 = load_abs_addr ();
		unsigned int src = LOAD (p2 + XR);
		PC += 3;

		/* cmp(--src & 0xff));  */

		src = (src - 1) & 0xff;		/* DEC+CMP */
		SET_CARRY (AC >= src);
		SET_SIGN (AC - src);
		SET_ZERO (AC != src);

		STORE (p2 + XR, (src));;
		clkcount = 7;
	      }

	      break;

	    case 224:
	      {
		BYTE p1 = LOAD (PC + 1);
		unsigned int src = p1;
		PC += 2;

		src = XR - src;
		SET_CARRY (src < 0x100);
		SET_SIGN (src);
		SET_ZERO (src &= 0xff);
		clkcount = 2;
	      }

	      break;

	    case 225:
	      {
		BYTE p1 = LOAD (PC + 1);
		unsigned int src = LOAD (LOAD_ZERO_ADDR (p1 + XR));
		unsigned int temp = AC - src - (IF_CARRY ()? 0 : 1);
		PC += 2;

		/*
		 * SBC is not exact either. It has 6% different results too.
		 */


		SET_SIGN (temp);
		SET_ZERO (temp & 0xff);		/* Sign and Zero are invalid in decimal mode */

		SET_OVERFLOW (((AC ^ temp) & 0x80) && ((AC ^ src) & 0x80));

		if (IF_DECIMAL ())
		  {
		    if (((AC & 0xf) + (IF_CARRY ()? 1 : 0)) < (int)(src & 0xf))
		      temp -= 6;
		    if (temp > 0x99)
		      temp -= 0x60;
		  }
		SET_CARRY (temp < 0x100);

		AC = (temp & 0xff);;
		clkcount = 6;
	      }

	      break;

	    case 226:
	      {
		PC += 2;

		clkcount = 2;
	      }

	      break;

	    case 227:
	      {
		BYTE p1 = LOAD (PC + 1);
		unsigned int src = LOAD (LOAD_ZERO_ADDR (p1 + XR));
		unsigned int temp;
		PC += 2;


		/* src = ++src & 0xff; AC = sbc(src); */

		src = ((src + 1) & 0xff);	/* INC+SBC */

		temp = AC - src - (IF_CARRY ()? 0 : 1);

		SET_SIGN (temp);
		SET_ZERO (temp & 0xff);		/* Sign and Zero are invalid in decimal mode */

		SET_OVERFLOW (((AC ^ temp) & 0x80) && ((AC ^ src) & 0x80));

		if (IF_DECIMAL ())
		  {
		    if (((AC & 0xf) + (IF_CARRY ()? 1 : 0)) < (int)(src & 0xf))
		      temp -= 6;
		    if (temp > 0x99)
		      temp -= 0x60;
		  }
		SET_CARRY (temp < 0x100);

		AC = temp;
		/* src saved */
		STORE (LOAD_ZERO_ADDR (p1 + XR), (src));;
		clkcount = 8;
	      }

	      break;

	    case 228:
	      {
		BYTE p1 = LOAD (PC + 1);
		unsigned int src = LOAD_ZERO (p1);
		PC += 2;

		src = XR - src;
		SET_CARRY (src < 0x100);
		SET_SIGN (src);
		SET_ZERO (src &= 0xff);
		clkcount = 3;
	      }

	      break;

	    case 229:
	      {
		BYTE p1 = LOAD (PC + 1);
		unsigned int src = LOAD_ZERO (p1);
		unsigned int temp = AC - src - (IF_CARRY ()? 0 : 1);
		PC += 2;

		/*
		 * SBC is not exact either. It has 6% different results too.
		 */


		SET_SIGN (temp);
		SET_ZERO (temp & 0xff);		/* Sign and Zero are invalid in decimal mode */

		SET_OVERFLOW (((AC ^ temp) & 0x80) && ((AC ^ src) & 0x80));

		if (IF_DECIMAL ())
		  {
		    if (((AC & 0xf) + (IF_CARRY ()? 1 : 0)) < (int)(src & 0xf))
		      temp -= 6;
		    if (temp > 0x99)
		      temp -= 0x60;
		  }
		SET_CARRY (temp < 0x100);

		AC = (temp & 0xff);;
		clkcount = 3;
	      }

	      break;

	    case 230:
	      {
		BYTE p1 = LOAD (PC + 1);
		unsigned int src = LOAD_ZERO (p1);
		PC += 2;

		src = (src + 1) & 0xff;
		SET_SIGN (src);
		SET_ZERO (src);

		STORE_ZERO (p1, (src));;
		clkcount = 5;
	      }

	      break;

	    case 231:
	      {
		BYTE p1 = LOAD (PC + 1);
		unsigned int src = LOAD_ZERO (p1);
		unsigned int temp;
		PC += 2;


		/* src = ++src & 0xff; AC = sbc(src); */

		src = ((src + 1) & 0xff);	/* INC+SBC */

		temp = AC - src - (IF_CARRY ()? 0 : 1);

		SET_SIGN (temp);
		SET_ZERO (temp & 0xff);		/* Sign and Zero are invalid in decimal mode */

		SET_OVERFLOW (((AC ^ temp) & 0x80) && ((AC ^ src) & 0x80));

		if (IF_DECIMAL ())
		  {
		    if (((AC & 0xf) + (IF_CARRY ()? 1 : 0)) < (int)(src & 0xf))
		      temp -= 6;
		    if (temp > 0x99)
		      temp -= 0x60;
		  }
		SET_CARRY (temp < 0x100);

		AC = temp;
		/* src saved */
		STORE_ZERO (p1, (src));;
		clkcount = 5;
	      }

	      break;

	    case 232:
	      {
		unsigned int src = XR;
		PC++;

		src = (src + 1) & 0xff;
		SET_SIGN (src);
		SET_ZERO (src);

		XR = (src);;
		clkcount = 2;
	      }

	      break;

	    case 233:
/*  SBC,    IMMEDIATE */
	      {
		BYTE p1 = LOAD (PC + 1);
		unsigned int src = p1;
		unsigned int temp = AC - src - (IF_CARRY ()? 0 : 1);
		PC += 2;

		/*
		 * SBC is not exact either. It has 6% different results too.
		 */

		if (!IF_DECIMAL ())
		  {
		    SET_SIGN (temp);
		    SET_ZERO (temp & 0xff);	/* Sign and Zero are invalid in decimal mode */

		    SET_OVERFLOW (((AC ^ temp) & 0x80) && ((AC ^ src) & 0x80));
		    SET_CARRY (temp < 0x100);
		    AC = (temp & 0xff);

		  }
		else
		  {
		    int bcd1, bcd2;
		    BYTE old_A;
		    int C = IF_CARRY ()? 1 : 0;

		    old_A = AC;

		    bcd1 = fromBCD (AC);
		    bcd2 = fromBCD (src);

		    bcd1 = bcd1 - bcd2 - !C;

		    if (bcd1 < 0)
		      bcd1 = 100 - (-bcd1);
		    AC = toBCD (bcd1);

		    SET_CARRY ((old_A < (src + !C)) ? 0 : 1);
		    SET_OVERFLOW ((old_A ^ AC) & 0x80);
		  }
		clkcount = 2;
	      }

	      break;

	    case 234:
	      {
		PC++;

		clkcount = 2;
	      }

	      break;

	    case 235:
	      {
		BYTE p1 = LOAD (PC + 1);
		unsigned int src = p1;
		unsigned int temp = AC - src - (IF_CARRY ()? 0 : 1);
		PC += 2;

		/*
		 * SBC is not exact either. It has 6% different results too.
		 */


		SET_SIGN (temp);
		SET_ZERO (temp & 0xff);		/* Sign and Zero are invalid in decimal mode */

		SET_OVERFLOW (((AC ^ temp) & 0x80) && ((AC ^ src) & 0x80));

		if (IF_DECIMAL ())
		  {
		    if (((AC & 0xf) + (IF_CARRY ()? 1 : 0)) < (int)(src & 0xf))
		      temp -= 6;
		    if (temp > 0x99)
		      temp -= 0x60;
		  }
		SET_CARRY (temp < 0x100);

		AC = (temp & 0xff);;
		clkcount = 2;
	      }

	      break;

	    case 236:
	      {
		unsigned short p2 = load_abs_addr ();
		unsigned int src = LOAD (p2);
		PC += 3;

		src = XR - src;
		SET_CARRY (src < 0x100);
		SET_SIGN (src);
		SET_ZERO (src &= 0xff);
		clkcount = 4;
	      }

	      break;

	    case 237:
	      {
		unsigned short p2 = load_abs_addr ();
		unsigned int src = LOAD (p2);
		unsigned int temp = AC - src - (IF_CARRY ()? 0 : 1);
		PC += 3;

		/*
		 * SBC is not exact either. It has 6% different results too.
		 */


		SET_SIGN (temp);
		SET_ZERO (temp & 0xff);		/* Sign and Zero are invalid in decimal mode */

		SET_OVERFLOW (((AC ^ temp) & 0x80) && ((AC ^ src) & 0x80));

		if (IF_DECIMAL ())
		  {
		    if (((AC & 0xf) + (IF_CARRY ()? 1 : 0)) < (int)(src & 0xf))
		      temp -= 6;
		    if (temp > 0x99)
		      temp -= 0x60;
		  }
		SET_CARRY (temp < 0x100);

		AC = (temp & 0xff);;
		clkcount = 4;
	      }

	      break;

	    case 238:
	      {
		unsigned short p2 = load_abs_addr ();
		unsigned int src = LOAD (p2);
		PC += 3;

		src = (src + 1) & 0xff;
		SET_SIGN (src);
		SET_ZERO (src);

		STORE (p2, (src));;
		clkcount = 6;
	      }

	      break;

	    case 239:
	      {
		unsigned short p2 = load_abs_addr ();
		unsigned int src = LOAD (p2);
		unsigned int temp;
		PC += 3;


		/* src = ++src & 0xff; AC = sbc(src); */

		src = ((src + 1) & 0xff);	/* INC+SBC */

		temp = AC - src - (IF_CARRY ()? 0 : 1);

		SET_SIGN (temp);
		SET_ZERO (temp & 0xff);		/* Sign and Zero are invalid in decimal mode */

		SET_OVERFLOW (((AC ^ temp) & 0x80) && ((AC ^ src) & 0x80));

		if (IF_DECIMAL ())
		  {
		    if (((AC & 0xf) + (IF_CARRY ()? 1 : 0)) < (int)(src & 0xf))
		      temp -= 6;
		    if (temp > 0x99)
		      temp -= 0x60;
		  }
		SET_CARRY (temp < 0x100);

		AC = temp;
		/* src saved */
		STORE (p2, (src));;
		clkcount = 6;
	      }

	      break;

	    case 240:
/*   BEQ,    RELATIVE */
	      {
		BYTE p1 = LOAD (PC + 1);
		unsigned int src = p1;
		BYTE hb;
		PC += 2;
		/* Branch if  zero flag is set. */
		if (IF_ZERO ())
		  {
		    hb = UPPER (PC);
		    PC = REL_ADDR (PC, src);
		    if (brtest (hb))
		      /* Same page */
		      clkcount = 3;
		    else
		      /* Different page */
		      clkcount = 4;
		  }
		else
		  clkcount = 2;
	      }

	      break;

	    case 241:
	      {
		BYTE p1 = LOAD (PC + 1);
		ADDRESS p2 = LOAD_ZERO_ADDR (p1);
		unsigned int src = LOAD (p2 + YR);
		unsigned int temp = AC - src - (IF_CARRY ()? 0 : 1);
		PC += 2;

		if (pagetest (p2, YR))
		  /* Over page */
		  clkcount = 6;
		else
		  /* Same page */
		  clkcount = 5;

		/*
		 * SBC is not exact either. It has 6% different results too.
		 */


		SET_SIGN (temp);
		SET_ZERO (temp & 0xff);		/* Sign and Zero are invalid in decimal mode */

		SET_OVERFLOW (((AC ^ temp) & 0x80) && ((AC ^ src) & 0x80));

		if (IF_DECIMAL ())
		  {
		    if (((AC & 0xf) + (IF_CARRY ()? 1 : 0)) < (int)(src & 0xf))
		      temp -= 6;
		    if (temp > 0x99)
		      temp -= 0x60;
		  }
		SET_CARRY (temp < 0x100);

		AC = (temp & 0xff);
	      }

	      break;

	    case 242:
	      {
		PC++;
		/* No such opcode. */
		--PC;
#ifdef notdef
		(void) printf ("Illegal instruction.\n");
		verflg = 1;
		show ();
#endif
		mon (PC);
	      }

	      break;

	    case 243:
	      {
		BYTE p1 = LOAD (PC + 1);
		unsigned int src = LOAD (LOAD_ZERO_ADDR (p1) + YR);
		unsigned int temp;
		PC += 2;


		/* src = ++src & 0xff; AC = sbc(src); */

		src = ((src + 1) & 0xff);	/* INC+SBC */

		temp = AC - src - (IF_CARRY ()? 0 : 1);

		SET_SIGN (temp);
		SET_ZERO (temp & 0xff);		/* Sign and Zero are invalid in decimal mode */

		SET_OVERFLOW (((AC ^ temp) & 0x80) && ((AC ^ src) & 0x80));

		if (IF_DECIMAL ())
		  {
		    if (((AC & 0xf) + (IF_CARRY ()? 1 : 0)) < (int)(src & 0xf))
		      temp -= 6;
		    if (temp > 0x99)
		      temp -= 0x60;
		  }
		SET_CARRY (temp < 0x100);

		AC = temp;
		/* src saved */
		STORE (LOAD_ZERO_ADDR (p1) + YR, (src));;
		clkcount = 8;
	      }

	      break;

	    case 244:
	      {
		PC += 2;

		clkcount = 4;
	      }

	      break;

	    case 245:
	      {
		BYTE p1 = LOAD (PC + 1);
		unsigned int src = LOAD_ZERO (p1 + XR);
		unsigned int temp = AC - src - (IF_CARRY ()? 0 : 1);
		PC += 2;

		/*
		 * SBC is not exact either. It has 6% different results too.
		 */


		SET_SIGN (temp);
		SET_ZERO (temp & 0xff);		/* Sign and Zero are invalid in decimal mode */

		SET_OVERFLOW (((AC ^ temp) & 0x80) && ((AC ^ src) & 0x80));

		if (IF_DECIMAL ())
		  {
		    if (((AC & 0xf) + (IF_CARRY ()? 1 : 0)) < (int)(src & 0xf))
		      temp -= 6;
		    if (temp > 0x99)
		      temp -= 0x60;
		  }
		SET_CARRY (temp < 0x100);

		AC = (temp & 0xff);;
		clkcount = 4;
	      }

	      break;

	    case 246:
	      {
		BYTE p1 = LOAD (PC + 1);
		unsigned int src = LOAD_ZERO (p1 + XR);
		PC += 2;

		src = (src + 1) & 0xff;
		SET_SIGN (src);
		SET_ZERO (src);

		STORE_ZERO (p1 + XR, (src));;
		clkcount = 6;
	      }

	      break;

	    case 247:
	      {
		BYTE p1 = LOAD (PC + 1);
		unsigned int src = LOAD_ZERO (p1 + XR);
		unsigned int temp;
		PC += 2;


		/* src = ++src & 0xff; AC = sbc(src); */

		src = ((src + 1) & 0xff);	/* INC+SBC */

		temp = AC - src - (IF_CARRY ()? 0 : 1);

		SET_SIGN (temp);
		SET_ZERO (temp & 0xff);		/* Sign and Zero are invalid in decimal mode */

		SET_OVERFLOW (((AC ^ temp) & 0x80) && ((AC ^ src) & 0x80));

		if (IF_DECIMAL ())
		  {
		    if (((AC & 0xf) + (IF_CARRY ()? 1 : 0)) < (int)(src & 0xf))
		      temp -= 6;
		    if (temp > 0x99)
		      temp -= 0x60;
		  }
		SET_CARRY (temp < 0x100);

		AC = temp;
		/* src saved */
		STORE_ZERO (p1 + XR, (src));;
		clkcount = 6;
	      }

	      break;

	    case 248:
/*  SED,    IMPLIED */
	      {
		PC++;

		SET_DECIMAL ((1));;
		clkcount = 2;
	      }

	      break;

	    case 249:
/*  SBC,    ABSOLUTE_Y */
	      {
		unsigned short p2 = load_abs_addr ();
		unsigned int src = LOAD (p2 + YR);
		unsigned int temp = AC - src - (IF_CARRY ()? 0 : 1);
		PC += 3;

		if (pagetest (p2, YR))
		  /* Over page */
		  clkcount = 5;
		else
		  /* Same page */
		  clkcount = 4;

		/*
		 * SBC is not exact either. It has 6% different results too.
		 */


		SET_SIGN (temp);
		SET_ZERO (temp & 0xff);		/* Sign and Zero are invalid in decimal mode */

		SET_OVERFLOW (((AC ^ temp) & 0x80) && ((AC ^ src) & 0x80));

		if (IF_DECIMAL ())
		  {
		    if (((AC & 0xf) + (IF_CARRY ()? 1 : 0)) < (int)(src & 0xf))
		      temp -= 6;
		    if (temp > 0x99)
		      temp -= 0x60;
		  }
		SET_CARRY (temp < 0x100);

		AC = (temp & 0xff);
	      }

	      break;

	    case 250:
	      {
		PC++;

		clkcount = 2;
	      }

	      break;

	    case 251:
	      {
		unsigned short p2 = load_abs_addr ();
		unsigned int src = LOAD (p2 + YR);
		unsigned int temp;
		PC += 3;


		/* src = ++src & 0xff; AC = sbc(src); */

		src = ((src + 1) & 0xff);	/* INC+SBC */

		temp = AC - src - (IF_CARRY ()? 0 : 1);

		SET_SIGN (temp);
		SET_ZERO (temp & 0xff);		/* Sign and Zero are invalid in decimal mode */

		SET_OVERFLOW (((AC ^ temp) & 0x80) && ((AC ^ src) & 0x80));

		if (IF_DECIMAL ())
		  {
		    if (((AC & 0xf) + (IF_CARRY ()? 1 : 0)) < (int)(src & 0xf))
		      temp -= 6;
		    if (temp > 0x99)
		      temp -= 0x60;
		  }
		SET_CARRY (temp < 0x100);

		AC = temp;
		/* src saved */
		STORE (p2 + YR, (src));;
		clkcount = 7;
	      }

	      break;

	    case 252:
	      {
		PC += 3;

		clkcount = 4;
	      }

	      break;

	    case 253:
/*   SBC,    ABSOLUTE_X */
	      {
		unsigned short p2 = load_abs_addr ();
		unsigned int src = LOAD (p2 + XR);
		unsigned int temp = AC - src - (IF_CARRY ()? 0 : 1);
		PC += 3;

		if (pagetest (p2, XR))
		  /* Over page */
		  clkcount = 5;
		else
		  /* Same page */
		  clkcount = 4;

		/*
		 * SBC is not exact either. It has 6% different results too.
		 */


		SET_SIGN (temp);
		SET_ZERO (temp & 0xff);		/* Sign and Zero are invalid in decimal mode */

		SET_OVERFLOW (((AC ^ temp) & 0x80) && ((AC ^ src) & 0x80));

		if (IF_DECIMAL ())
		  {
		    if (((AC & 0xf) + (IF_CARRY ()? 1 : 0)) < (int)(src & 0xf))
		      temp -= 6;
		    if (temp > 0x99)
		      temp -= 0x60;
		  }
		SET_CARRY (temp < 0x100);

		AC = (temp & 0xff);
	      }

	      break;

	    case 254:
	      {
		unsigned short p2 = load_abs_addr ();
		unsigned int src = LOAD (p2 + XR);
		PC += 3;

		src = (src + 1) & 0xff;
		SET_SIGN (src);
		SET_ZERO (src);

		STORE (p2 + XR, (src));;
		clkcount = 7;
	      }

	      break;

	    case 255:
	      {
		unsigned short p2 = load_abs_addr ();
		unsigned int src = LOAD (p2 + XR);
		unsigned int temp;
		PC += 3;


		/* src = ++src & 0xff; AC = sbc(src); */

		src = ((src + 1) & 0xff);	/* INC+SBC */

		temp = AC - src - (IF_CARRY ()? 0 : 1);

		SET_SIGN (temp);
		SET_ZERO (temp & 0xff);		/* Sign and Zero are invalid in decimal mode */

		SET_OVERFLOW (((AC ^ temp) & 0x80) && ((AC ^ src) & 0x80));

		if (IF_DECIMAL ())
		  {
		    if (((AC & 0xf) + (IF_CARRY ()? 1 : 0)) < (int)(src & 0xf))
		      temp -= 6;
		    if (temp > 0x99)
		      temp -= 0x60;
		  }
		SET_CARRY (temp < 0x100);

		AC = temp;
		/* src saved */
		STORE (p2 + XR, (src));;
		clkcount = 7;
	      }

	      break;



	    }			/* switch */

	  clk += clkcount;

	}			/* while(1) */
    }				/* while(!reset_flag) */
}				/* mainloop */
