netik/dc27_badge/software/firmware/badge/app-geiger.c

/*-
 * Copyright (c) 2019
 *      Bill Paul <wpaul@windriver.com>.  All rights reserved.
 *
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
 * THIS SOFTWARE IS PROVIDED BY Bill Paul AND CONTRIBUTORS ``AS IS'' AND
 * ANY EXPRESS OR IMPLIED WARRANTIES, INCLUDING, BUT NOT LIMITED TO, THE
 * IMPLIED WARRANTIES OF MERCHANTABILITY AND FITNESS FOR A PARTICULAR PURPOSE
 * ARE DISCLAIMED.  IN NO EVENT SHALL Bill Paul OR THE VOICES IN HIS HEAD
 * BE LIABLE FOR ANY DIRECT, INDIRECT, INCIDENTAL, SPECIAL, EXEMPLARY, OR
 * CONSEQUENTIAL DAMAGES (INCLUDING, BUT NOT LIMITED TO, PROCUREMENT OF
 * SUBSTITUTE GOODS OR SERVICES; LOSS OF USE, DATA, OR PROFITS; OR BUSINESS
 * INTERRUPTION) HOWEVER CAUSED AND ON ANY THEORY OF LIABILITY, WHETHER IN
 * CONTRACT, STRICT LIABILITY, OR TORT (INCLUDING NEGLIGENCE OR OTHERWISE)
 * ARISING IN ANY WAY OUT OF THE USE OF THIS SOFTWARE, EVEN IF ADVISED OF
 * THE POSSIBILITY OF SUCH DAMAGE.
 */

#include "orchard-app.h"
#include "orchard-ui.h"

#include "ides_gfx.h"
#include "nrf52i2s_lld.h"
#include "nrf52radio_lld.h"
#include "ble_lld.h"
#include "ble_gap_lld.h"
#include "fontlist.h"
#include "userconfig.h"
#include "led.h"

#include "gfx.h"
#include "src/gdisp/gdisp_driver.h"

#include <stdio.h>
#include <stdlib.h>
#include <string.h>

#include <unistd.h>
#include <fcntl.h>
#include <sys/stat.h>

#define GEIGER_PKTLEN		37
#define GEIGER_DELAY		3
#define GEIGER_CYCLE		5

#define RX_ACTION_NONE		0x00
#define RX_ACTION_PLAY_CLICK	0x01
#define RX_ACTION_EXIT		0x02

typedef struct geiger_handles {
	GListener	gl;
	GHandle		ghExit;
	GHandle		ghBadgesOnly;
	GHandle		ghUp;
	GHandle		ghDown;
	font_t		font;
	int8_t		rxThreshold;
	uint16_t	intensity;
	uint16_t	cycles;
	uint32_t	lastcnt;
	bool		badgesOnly;
	volatile int	rxAction;
	char *		click;
	int		clickLen;
	uint8_t		rxpkt[GEIGER_PKTLEN + 3];
	thread_t *	pThread;
} GHandles;

static void
geigerScan (GHandles * p, uint16_t freq)
{
        ble_ides_game_state_t * s;
	int8_t rssi;
	uint8_t * d;
	uint8_t l;

	/* Select frequency */

	nrf52radioChanSet (freq);

	/*
	 * Check for a packet. If we don't receive a valid
	 * packet before the timeout, then just return.
	 */

	if (nrf52radioRx (p->rxpkt, GEIGER_PKTLEN,
	    &rssi, GEIGER_DELAY) != NRF_SUCCESS)
		return;

	rssi = 127 - rssi;

	/*
	 * When in "Badges Only" mode, we only respond to advertisement
	 * packets from other DC27 bombs. We look for those by checking
	 * for our vendor-specific game data block.
	 */

	if (p->badgesOnly == TRUE) {
		/*
		 * We skip over 3 bytes of packet header data,
		 * plus 6 bytes of station address. Offset 1
		 * in the packet buffer should contain the
		 * packet length.
		 */
		d = &p->rxpkt[3 + 6];
		l = p->rxpkt[1];
		if (bleGapAdvBlockFind (&d, &l,
		    BLE_GAP_AD_TYPE_MANUFACTURER_SPECIFIC_DATA)
		    != NRF_SUCCESS)
			return;
                s = (ble_ides_game_state_t *)d;
                if (s->ble_ides_company_id != BLE_COMPANY_ID_IDES)
			return;
	}

	if (rssi >= p->rxThreshold) {
		uint32_t cur;
		i2sSamplesPlay (p->click, p->clickLen);
		cur = gptGetCounterX (&GPTD2);
		if ((cur - p->lastcnt) < 600000) {
			p->intensity += 5;
		} else {
			p->intensity += 1;
		}
		p->lastcnt = cur;
	}

	return;
}

static THD_WORKING_AREA(waGeigerThread, 512);
static THD_FUNCTION(geigerThread, arg)
{
	GHandles * p;
	userconfig * config;

	p = arg;

	chRegSetThreadName ("GeigerEvent");

	/*
	 * Switch off the SoftDevice and take over
	 * manual control of the radio.
	 */

	config = getConfig ();

	if (config->airplane_mode == 0)
		bleDisable ();

	nrf52radioStart ();

	i2sAudioAmpCtl (I2S_AMP_ON);

	gptStartContinuous (&GPTD2, NRF5_GPT_FREQ_16MHZ);

	while (1) {
		if (p->rxAction == RX_ACTION_EXIT)
			break;

		if (p->rxAction == RX_ACTION_PLAY_CLICK) {
			i2sPlay ("/sound/click.snd");
			i2sWait ();
			i2sAudioAmpCtl (I2S_AMP_ON);
		}

		p->rxAction = RX_ACTION_NONE;

		/* Scan the three advertising channels */

		geigerScan (p, ble_chan_map[37].ble_freq);
		geigerScan (p, ble_chan_map[38].ble_freq);
		geigerScan (p, ble_chan_map[39].ble_freq);

		/* Try to reflect intensity on the LED array. */

		p->cycles++;
		if (p->cycles > GEIGER_CYCLE) {
			ledDraw (p->intensity);
			p->cycles = 0;
			p->intensity = 0;
		}
	}

	gptStopTimer (&GPTD2);

	i2sAudioAmpCtl (I2S_AMP_OFF);

	/* Give the SoftDevice control of the radio again. */

	nrf52radioStop ();

	if (config->airplane_mode == 0)
		bleEnable ();

	chSysLock ();
	chThdExitS (MSG_OK);

	return;
}

static void
geigerSenseAdjust (GHandles * p)
{
	char s[32];

	drawProgressBar (10, 80, 180, 20, 127, p->rxThreshold, false, false);

	sprintf (s, "RX Threshold: %d", p->rxThreshold);
	gdispFillArea (10, 105, 180, 20, Black);
	gdispDrawStringBox (10, 105, 180, 20, s,
	    p->font, White, justifyCenter);    

	return;
}

static void
geigerUiInit (GHandles * p)
{
	GWidgetInit wi;

	gwinSetDefaultStyle (&RedButtonStyle, FALSE);

	gwinWidgetClearInit (&wi);
	wi.g.show = TRUE;
	wi.g.x = 235;
	wi.g.y = 80;
	wi.g.width = 80;
	wi.g.height = 25;
	wi.text = "EXIT";
	p->ghExit = gwinButtonCreate(0, &wi);

	gwinSetDefaultStyle (&GreenButtonStyle, FALSE);

	wi.g.y = 130;
	wi.text = "Badges Only";
	p->ghBadgesOnly = gwinButtonCreate(0, &wi);

	wi.g.x = 10;
	wi.g.y = 130;
	wi.g.width = 50;
	wi.g.height = 25;
	wi.text = "<-";
	p->ghDown = gwinButtonCreate(0, &wi);

	wi.g.x = 140;
	wi.g.y = 130;
	wi.text = "->";
	p->ghUp = gwinButtonCreate(0, &wi);

	gwinSetDefaultStyle (&BlackWidgetStyle, FALSE);

	geigerSenseAdjust (p);

	return;
}

static void
geigerUiDestroy (GHandles * p)
{
	gwinDestroy (p->ghExit);
	gwinDestroy (p->ghBadgesOnly);
	gwinDestroy (p->ghUp);
	gwinDestroy (p->ghDown);

	return;
}

static uint32_t
geiger_init (OrchardAppContext *context)
{
	(void)context;

	/*
	 * We don't want any extra stack space allocated for us.
	 * We'll use the heap.
	 */

	return (0);
}

static void
geiger_start (OrchardAppContext *context)
{
	GHandles * p;
	int fd;
	struct stat s;

	putImageFile ("/images/radioact.rgb", 0,0);

	p = malloc (sizeof (GHandles));
	memset (p, 0, sizeof (GHandles));

	context->priv = p;

	i2sPlay (NULL);
	ledStop ();

	p->font = gdispOpenFont (FONT_XS);

	/* Load the click sound effect into RAM */

	fd = open ("/sound/geiger1.snd", O_RDONLY);
	fstat (fd, &s);
	p->clickLen = s.st_size / 2;
	p->click = malloc (s.st_size);
	read (fd, p->click, s.st_size);
	close (fd);

	p->rxThreshold = 40;
	p->rxAction = RX_ACTION_NONE;
	p->badgesOnly = FALSE;

	geigerUiInit (p);

	geventListenerInit (&p->gl);
        gwinAttachListener(&p->gl);
	geventRegisterCallback (&p->gl, orchardAppUgfxCallback, &p->gl);

	/* Launch the receiver thread; */

	p->pThread = chThdCreateStatic (waGeigerThread, sizeof(waGeigerThread),
            NORMALPRIO - 10, geigerThread, p);

	return;
}

static void
geiger_event (OrchardAppContext *context,
	const OrchardAppEvent *event)
{
	GEvent * pe;
	GEventGWinButton * be;
	GHandles * p;

	p = context->priv;

	if (event->type == ugfxEvent) {
		pe = event->ugfx.pEvent;
		if (pe->type == GEVENT_GWIN_BUTTON) {
			while (p->rxAction)
				chThdSleep (1);
			p->rxAction = RX_ACTION_PLAY_CLICK;
			be = (GEventGWinButton *)pe;
			if (be->gwin == p->ghExit) {
				orchardAppExit ();
				return;
			}
			if (be->gwin == p->ghBadgesOnly) {
				if (p->badgesOnly == FALSE) {
					p->badgesOnly = TRUE;
					putImageFile ("/images/bomb.gif",
					    235, 145);
				} else {
					p->badgesOnly = FALSE;
					GDISP->clipx0 = 0;
					GDISP->clipy0 = 0;
					GDISP->clipx1 = 320;
					GDISP->clipy1 = 240;
					gdispFillArea (235, 145,
					    80, 45, Yellow);
				}
			}
			if (be->gwin == p->ghUp) {
				if (p->rxThreshold < 127) {
					p->rxThreshold++;
					geigerSenseAdjust (p);
				}
			}
			if (be->gwin == p->ghDown) {
				if (p->rxThreshold > 0 ) {
					p->rxThreshold--;
					geigerSenseAdjust (p);
				}
			}

			return;
		}
	}

	if (event->type == keyEvent && event->key.flags == keyPress) {
		if (event->key.code == keyADown ||
 		    event->key.code == keyBDown ||
 		    event->key.code == keyALeft ||
 		    event->key.code == keyBLeft) {
			while (p->rxAction)
				chThdSleep (1);
			p->rxAction = RX_ACTION_PLAY_CLICK;
			if (p->rxThreshold > 0 ) {
				p->rxThreshold--;
				geigerSenseAdjust (p);
			}
		}

		if (event->key.code == keyAUp ||
 		    event->key.code == keyBUp ||
 		    event->key.code == keyARight ||
 		    event->key.code == keyBRight) {
			p->rxAction = RX_ACTION_PLAY_CLICK;
			if (p->rxThreshold < 127) {
				p->rxThreshold++;
				geigerSenseAdjust (p);
			}
		}
	}

	return;
}

static void
geiger_exit (OrchardAppContext *context)
{
	GHandles * p;
	userconfig * config;

	p = context->priv;

	while (p->rxAction)
		chThdSleep (1);

	p->rxAction = RX_ACTION_EXIT;
	chThdWait (p->pThread);

	config = getConfig();
	ledSetPattern (config->led_pattern);

	geigerUiDestroy (p);

	geventDetachSource (&p->gl, NULL);
	geventRegisterCallback (&p->gl, NULL, NULL);

	gdispCloseFont (p->font);

	if (p->click != NULL)
		free (p->click);
	free (p);

	return;
}

orchard_app("BLE Counter", "icons/rad.rgb",
    0, geiger_init, geiger_start, geiger_event, geiger_exit, 9999);
