netik/dc27_badge/software/firmware/badge/ides_sprite.c

#include "ch.h"
#include "hal.h"

#include "orchard-app.h"
#include "string.h"
#include "fontlist.h"
#include "ides_gfx.h"
#include "scroll_lld.h"

#include "gfx.h"
#include "src/gdisp/gdisp_driver.h"

#include "ffconf.h"
#include "ff.h"

#include "async_io_lld.h"
#include "badge.h"
#include "images.h"
#include "ides_sprite.h"
#include "sprite_fx.h"
#include <math.h>

/* stored default structs for initializing */
static const ISPBUF isbuf_default = {
  .buf = NULL,
  .x=0,
  .y=0,
  .xs=0,
  .ys=0
};

const ISPRITE isprite_default = {
  .bgtype = ISP_BG_DYNAMIC,
  .active = FALSE,
  .alphamap = NULL,
  .xoffs = 0,
  .yoffs = 0,
  .visible = FALSE,
  .auto_bg = TRUE,
  .mode_switch = FALSE,
  .full_restore = FALSE,
  .bgcolor = HTML2COLOR(0x2603fb)
};

typedef struct _4rect {
  RECT bx[4];
} FOUR_RECTS;

const RECT rect_default = {.x=0, .y=0, .xr=0, .yb=0};

static int allo_num=0;


void *dmalloc(size_t s, char *msg)
{
  void *ret;
  ret = malloc(s);
//    printf("%08x  , malloc %d, anum:, %d, - %s\n", ret, s, allo_num,msg);
  if(NULL != ret)
  {
      allo_num++;
  }

  return(ret);
}

void *dcalloc(size_t num, size_t siz, char *msg)
{
  void *ret;
  ret = calloc(num, siz);
//    printf("%08x , calloc %d/%d , anum:, %d, - %s\n", ret, num, siz, allo_num, msg);
  if(NULL != ret)
  {
      allo_num++;
  }

  return(ret);
}

void dfree(void *ptr, char *msg)
{
  allo_num--;
  free(ptr);
//  printf("%08x , free , anum:, %d, - %s\n", ptr,  allo_num, msg);

}

/* This is a library for simplifying sprite usage.
 * it supports
 *

ISPRITESYS *sl; // the sprite system.
ISPID s1, s2, s3; // ID numbers for each sprite.
int i=0;

// initialize a sprite system.  each ISPRITESYS does up to ISP_MAX_SPRITES at a time.
// you can create and destroy sprites all you want.
// it's often better to hide them if it's a re-used asset like a bullet.
// more than one spite system can be open and/or active at a time.
sl = isp_init();

// each new sprite has an ID number.
s1 = isp_make_sprite(sl); // make sprites.  none are drawn yet.
s2 = isp_make_sprite(sl); // they have no position or pixel data yet.
s3 = isp_make_sprite(sl);




  while()
  {
    i++;
    do_stuff();

    // pretend xpos/ypos are functions that return some position value
    // this is how you change the positional values for the sprites.
    isp_set_sprite_xy(sl, s1, xpos(i), ypos(i));
    isp_set_sprite_xy(sl, s2, xpos(i)+10, ypos(i)+10);
    isp_set_sprite_xy(sl, s3, xpos(i)+20, ypos(i)+20);


    // example of turning a sprite off.
    // maybe it's off screen, maybe it's not needed at the moment, but this is faster
    // than creating and destroying sprites constantly.
    if(should_s3_be_invisible())
    {
      hide_sprite(sl, s3);
    }
    else
    {
      show_sprite(sl, s3);
    }

    isp_draw_all_sprites(sl);
  }



  isp_shutdown(sl);  // close and free this sprite system.


*/

int  fix_range(int i, int a, int b)
{
  int min, max;
  min = (a < b)? a : b;
  max = (a > b)? a : b;

  if(i > max)
  {
    i = max;
  }
  if(i < min)
  {
    i = min;
  }
  return(i);
}

void timeit(int g, char *str)
{
  static systime_t f=0,s=0;
  if(g==0)
  {
    f = chVTGetSystemTime();
  }
  else
  {
    s = chVTGetSystemTime();
    printf("%s time: %lu\n", str, (s-f) );
  }
}


WMAP *wm_make_wmap_size(coord_t width, coord_t height)
{
  WMAP *w=NULL;

  width = fix_range(width, 0, SCREEN_W);
  height =  fix_range(height, 0, SCREEN_H);

  if( (height > 0) && (width > 0) )
  {
    w = dcalloc(1, sizeof(WMAP), "wm_make_wmap_size: w alloc");

    if ( NULL != w )
    {
      w->h = height;
      w->w = width;
  /*
  printf("wm blk alloc %d w:%d h:%d\n", height * sizeof(WROW), width, height);
  fflush(stdout);
  */
      w->map = dcalloc(height, sizeof(WROW), "wm_make_wmap_size: w->map alloc");

    }
  }
  return(w);
}

WMAP *wm_make_screensize_wmap(void)
{
  return(wm_make_wmap_size(SCREEN_W, SCREEN_H));
}


void wmap_header_dump(WMAP *w, char *name)
{
  int i, j, first;
  char rowmap[128];
  sprintf(rowmap, "%s_rows", name);

  printf("WROW %s[] = { \n ", rowmap);
  for(i=0; i < w->h; i++)
  {
    printf("  { .row[] = { ");
    first=TRUE;
    for(j=0; j < WMAP_W; j++)
    {
      if(!first)
      {
        printf(", ");
      }
      printf("0x%08lx", w->map[i].row[j]);
      first = FALSE;
    }
    printf("}, \n");
    printf("   .first_px=0, .last_px=0, .notblank=TRUE };\n");
  }
  printf("}\n\n");
  printf("WMAP %s = { .h=%d, .w=%d, map=&%s }\n", name, w->h, w->w, rowmap);
}

/* so far just a free, but if this chjanges later, this would handle shutdown cleanly. */
void wm_destroy_wmap(WMAP *w)
{
  if(NULL != w)
  {
    if(NULL != w->map)
    {
      dfree(w->map, "destroy_wmap w->map");
      w->map = NULL;
    }
    dfree(w, "destroy_wmap w");
  }
}

WMAP *wm_copy_wmap(WMAP *w)
{
  WMAP *ret = NULL;
  int i;
  if( (NULL != w->map) &&
      (w->h > 0) &&
      (w->w > 0) )
  {
    ret = wm_make_wmap_size(w->w, w->h);
    if(NULL != ret)
    {
      for(i=0; i < w->h; i++)
      {
        ret->map[i] = w->map[i];
      }
    }
  }
  return(ret);
}


static void wm_set_first_last_per_row(WMAP *w)
{
  coord_t y, x,last;
  if(NULL != w)
  {
    last = (w->w - 1);

    for(y=0; y < w->h; y++)
    {
      if(TRUE == w->map[y].notblank)
      {
        w->map[y].first_px = 0;
        w->map[y].last_px  = last;

        for(x=0; x < w->w; x++)
        {
          if(wm_value(w, x,y, 3))
          {

            w->map[y].first_px = x;
            break;
          }
        }
        for(x = last ; x >= w->map[y].first_px; x--)
        {
          if(wm_value(w, x,y, 3))
          {
            w->map[y].last_px = x;
            break;
          }
        }
      }
      else
      {
        w->map[y].first_px = last;
        w->map[y].last_px  = 0;
      }
    }
  }
}


/* iv v is 0 or 1, it sets the value.  if it's > 1, it GETS the value. */
bool_t wm_value(WMAP *w, coord_t x, coord_t y, uint8_t v)
{
  bool_t ret;
  int  offs = 0, bit=0;
  offs = WM_STEP(x);
  bit  = WM_BIT(x);
  ret=v;
/*
printf("x%u y%u offs%u bit %u w%d - %u wh%x bit%x\n", x, y, offs, bit,w->h, v, &w->h, &w->map[y].row[offs]);
*/
  if( (y < w->h) && (x < w->w) )
  {
    if(0 == v)
    {
      w->map[y].row[offs] &= ~(1 << bit);
    }
    else if(1 == v)
    {
      w->map[y].row[offs] |= 1<< bit;
      w->map[y].notblank = TRUE;
    }
    else
    {
      ret = (w->map[y].row[offs] >> bit) & 1;
    }
/*
printf("x%u, y%u, v%u off%u bit %u ret:%u-- %lx\n", x,y,v, offs, bit, ret, w->map[y].row[offs]);
*/
  }
  return(ret);
}





/* mapx mapy are the positions in the WMAP to start writing
 * bxs, bys are the size of buf.
 * mapx amd mapy are the starting coords on the wmap to place the info from the scanned buffer.
 * we scan the screen map in chunks because it's too big to buffer the whole thing.
 * bxs and bys are buffer X size and buffer Y size.
 */
bool_t wm_scan_from_img(WMAP *w, coord_t mapx, coord_t mapy, coord_t bxs, coord_t bys, pixel_t *buf)
{
  coord_t bufx, bufy, wmx, wmy, pos;
  bool_t ret=FALSE;
  pixel_t px;

  /*  if we have a buffer, & scanned image will not overrun the map, then scan it. */
  /*
  printf("enter wm_scan_from_img x%d y%d, sx%u sy%u w%u h%u\n", mapx, mapy, bxs, bys, w->w, w->h);
  fflush(stdout);
*/
  if( (NULL != buf) && (w->w >= (mapx+bxs)) && (w->h >= (mapy+bys)) )
  {
    for(bufy=0; bufy < bys; bufy++)
    {
      for(bufx=0; bufx < bxs; bufx++)
      {
        pos = (bufy*bxs)+bufx;
        px=buf[pos];
        if( (GET_PX_BLUE(px) < BLUE_THRESH ) ||
              (GET_PX_GREEN(px) > NOTBLUE_THRESH) ||
              (GET_PX_RED(px) > NOTBLUE_THRESH) )
        {
          wmx = mapx + bufx;
          wmy = mapy + bufy;
/*
printf("notblue: %d  x%d y%d -- r%d g%d b%d\n",px, wmx, wmy, GET_PX_RED(px), GET_PX_GREEN(px), GET_PX_BLUE(px));
*/
          wm_value(w, wmx, wmy, 1);
        }
      }
/*      printf("%s\n", line); */
    }
    ret = TRUE;
  }
/*printf("exit wm_scan_from_img x%d y%d, sx%u sy%u w%u h%u\n", mapx, mapy, bxs, bys, w->w, w->h);
*/
  return(ret);
}




/* scrapes the screen & builds the bitmask, setting water to 0 and land to 1 */
WMAP *wm_build_land_map_from_screen(void)
{
  coord_t y, bufx, bufy;
  pixel_t *buf=NULL;
  WMAP *w;

  y=0;
/* size of screen-scraping buffer.  not enough ram to scrape whole screeen */
  bufx = SCREEN_W;
  bufy = 20;
//printf("land map c alloc %d\n", bufx * bufy * sizeof(pixel_t));
  buf = dcalloc(bufx * bufy, sizeof(pixel_t), "wm_build_land_map_from_screen");
  w = wm_make_wmap_size(SCREEN_W, SCREEN_H);

  for(y=0; y < SCREEN_H; y += bufy)
  {
    /* grab 20 rows at a time */
    getPixelBlock(0, y, bufx, bufy, buf);
    wm_scan_from_img(w, 0, y, bufx, bufy, buf);
  }
  dfree(buf,"wm_build_land_map_from_screen");
  return(w);
}


/* makes a RECT bounding box around the solid, non-transparent pixels */
RECT wm_make_bounding_box(WMAP *w)
{
  coord_t top, bot, left, right, y;
  RECT r;

  top = 0;
  left =0;
  bot = (w->h -1);
  right = (w->w -1);

  for(y=0; y < bot; y++)
  {
      /* any pixel bit set to 1 means the row is not blank */
    if(TRUE == w->map[y].notblank)
    {
      top = y;
      break;
    }
  }

  /* look for blank rows on the bottom */
  for(y=bot; y > top; y--)
  {
    if(TRUE == w->map[y].notblank)
    {
      bot = y;
      break;
    }
  }
  wm_set_first_last_per_row(w);
  /* now look for notblank on the left side of the sprite
   */
  left = (w->w -1);
  right = 0;
  for(y=top; y < bot; y++)
  {
    if(TRUE == w->map[y].notblank)
    {
      /* left is the smallest found first_px in the list */
      left  = (left > w->map[y].first_px) ? w->map[y].first_px : left;
     /* right -s the largest last_px found in the list. */
      right = (right < w->map[y].last_px) ? w->map[y].last_px : right;
    }
    /* if we find soild pixels in the outer most positions, stop looking */
    if( (0 == left) && (w->w == right) )
    {
      break;
    }
  }

  /* now start on the left and look to the right for first pixel
   */

  r.x  = left;
  r.y  = top;
  r.xr = right;
  r.yb = bot;

  return(r);
}

void print_rect(char *s, RECT r)
{
  printf("%s: x:%d y:%d xr:%d yb:%d\n", s, r.x, r.y, r.xr, r.yb);
}

/* pass valid rect to limit collision test to those coords */
/* currenly uses that as course guide, it starts at the (int) containing that coord.
 * so in this case, we say 45, but this will start at 32, which is the start of that
 * int boundary.  to do it fully proper, we should mask off the extra bits on either side.  But if
 * we are not packing more than one shape into the comparison map at a time, it will be fine.
 *  01234567890123456789801234567891  23456789012345678901234567890123
 * [................................][.............|||||||||||........]
 *
 */
bool_t wm_collision_check_maps(WMAP *mapa, WMAP *mapb, RECT r)
{
  coord_t x=0, y=0, xmax=0, ymax=0, xstart=0;
  bool_t ret=FALSE;

  if(is_valid_rect(r))
  {
    xstart = WM_STEP(r.x);
    y = r.y;
    xmax = WM_STEP(r.xr);
    ymax = r.yb;
  }
  else
  {
    xmax = WM_STEP(mapa->w);
    ymax = mapa->h;
  }

  for( ; y < ymax; y++)
  {
    for(x=xstart ; x <= xmax; x++)
    {
      if(mapa->map[y].row[x] & mapb->map[y].row[x])
      {
        ret = TRUE;
        break;
      }
    }
    if(TRUE == ret)
    {
      break;
    }
  }
  return(ret);
}


void print_wmap_hits(WMAP *w)
{
  coord_t x,y;
  char s[200], st[200];
  int t=FALSE;
  for(y=0; y < w->h; y++)
  {
    strcpy(s, "");
    strcpy(st, "");
    for(x=0; x < WMAP_W; x++)
    {
      if(w->map[y].row[x])
      {
        if(t==FALSE)
        {
          sprintf(s, "x=%d ", x);
        }

        sprintf(st, "%lx ", w->map[y].row[x]);
        strcat(s, st);
        t=TRUE;
      }
    }
    if(t)
    {
      printf("y:%d - %s\n", y, s);
      t=FALSE;
    }
  }
}
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
