netik/dc27_badge/(commit log)

2018-09-12 Initial import of board support for DC27 IDES badge
    This import copies over the files from the dc26 repo. Included are
    the board support packages for the nRF52832 and nRF52840. The former
    may be removed since we'll be using the nRF52840 for DC27. I still have
    two 52832 dev boards though and may use them for testing.
    [mkfs.xls, stm_spc56ec74a256s_spc56ec74_minimodule_debug_jtag.cfg, stm_xpc560b64_minimodule_debug_jtag.cfg, stm_xpc560b_spc560d40_minimodule_debug_jtag.cfg, stm_xpc560p_minimodule_40mhz_debug_jtag.cfg, stm_xpc563m64_minimodule_debug_jtag.cfg, stm_xpc564a_spc564a70_minimodule_debug_jtag.cfg, stm_xpc56el_minimodule_lockstep_debug_jtag.cfg]
2018-09-12 Add an NRF52840-specific platform support layer
    The 52840 needs a new nrf52_bitfields.h file since it has new peripheral support
    that's not present in the 52832. The new nrf52.h and nrf52_bitfields.h file
    come from the Nordic version 15.1.0 SDK.
    The badge_840 BSP still needs to have its Makefile changed to use this new
    platform layer. I'm holding off on switching that over until I can get home
    and test it. (Right now I only know that it compiles.)
2018-09-13 Switch 528540 BSP over to 840-specific platform code
    Sanity tests pass, board boots up and runs same as before. The 52840 platform
    code can now be customized without affecting the older 52832 BSP.
2018-09-14 Check in the right bitfields file.
    The nrf52_bitfields.h file from the SDK was the wrong file to use.
    It only contains peripheral register definitions for those devices
    common to ann NRF52 devices. The nrf52840_bitfields.h file includes all
    the new things in the 52840 chip, like the QSPI controller, which is
    what we want.
2018-09-15 Upgrade to ChibiOS 18.2.1
    The ChibiOS 18.2.1 source has been imported with the following changes:
    - the clean rule in rules.mk has been fixed to not use an option to rmdir
    which is only available on Linux
    Changes to the BSP and platform code:
    - Some paths corrected in the startup files for NRF52 and NRF52840
    - chconf.h files updated to support new options available with kernel
    version 5 of ChibiOS/RT (which we don't need, so they're turned off)
    - The time to inverval conversion macros used with the ChibiOS virtual
    timer have changed. The orchard-app.c module has been fixed to take
    this into account.
    - The uGFX code has places in it where it checks for ChibiOS kernel
    versions 2, 3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
    [board.c, board.h, chconf.h, hal.c, hal_spi.h, halconf.h]
2018-09-16 Add support for GPIO bank 1 on the nRF52840.
    The 52840 chip has 48 GPIO pins rather than 32. The 16 additional pins are
    handled using a second GPIO register bank. It turned out I was still using
    the wrong nrf52.h header file from the SDK. The right one (actually called
    nrf52840.h in the SDK archive) is now in place. Also, nrf52_to_nrf52840.h
    has been added, which has some compatibility macros from some register
    definitions which have changed.
    Currently the IOPORT2 bank of GPIOs are defined as unconnected because we
    haven't put anything on them yet, but this will likely change later.
    (Yay more pins.)
    [board.c]
2018-09-17 Update pin config in board.c
    Since we're starting over with prototyping for the 52840 board, and since
    the 52840 DK board has different pin usage than the 52832 board, we should
    start from scratch with the pin mapping in the board.c file. (I'll fix up
    the board.h file later.) Note that pins used by other peripherals (e.g.
    QSPI) will be defined here as unconnected. Once claimed by a peripheral,
    a pin isn't accessible by the GPIO block anyway.
    Also add missing entry for P1.11 pin.
    [board.c]
2018-09-20 Add support for SPIM2 and SPIM3 controllers
    The nRF52840 has four possible SPIM instances. We need to add support for
    the SPIM2 and SPIM3 interrupt vectors and device handles. Also, we need to
    add shortcut macros for 16MHz and 32MHz bus speeds, which are only supported
    on SPIM3.
2018-09-20 Add preliminary SPI screen/SD card support
    Unfortunately, the SPIM3 bus on the preview nRF52840 board doesn't work, so
    I can't test the correct configuration, but for now I have the screen and SD
    card running on bus SPIM0. Speed is still restricted to 8MHz.
    For now the SPI bus and chip select pins are connected to pins 1 through 8
    on GPIO port P1. This may not be the final configuration though. Some
    consultation with John will be required. But for now everything works
    as expected. (The touch controller is also hooked up for the time being.)
    [board.c, board.h, main.c, mcuconf.h, mmc_spi_lld.c, scroll_lld.c, updater.c]
2018-09-20 Fix it so that the badge_832 BSP compiles again
    The NRF52832 doesn't have the GPIO pins where the screen and SD
    card now reside, but we still want to be able to build and run
    ChibiOS on the older boards for compatibility testing.
    While I'm at it, also check in the updated documentation for
    FatFs 0.13b, which I somehow forgot to do previously.
    [scroll_lld.c]
2018-09-23 Add initial QSPI support
    The ChibiOS QSPI flash driver framework is a little slanted in favor of
    the ST Micro QSPI controller design, but I've managed to make it mostly
    work. The on-board QSPI flash can be erased and programmed, and it's
    mapped at address 0x18000000.
    This may require some additional refinements.
2018-09-23 Fix a minor bug in the SPI driver
    I forgot to define priority macros for SPI bus 2 and 3.
2018-09-24 Make some cleanups to the QSPI driver
    Fix some comments that became stale during the course of development.
    For the sector and subsector erase commands, we can send the opcodes
    directly. It doesn't hurt to do this.
    Also, use the One True Brace Style (tm).
2018-09-24 Fix a bug in the m25q driver
    The m25qStop() function sets the config pointer to NULL, then tries to
    use it again. I don't think this function has been well tested.
2018-09-24 Make a few more cleanups to the QSPI driver
    Always use the shortcut command registers for erase.
    Also, once we do a read access via XIP, we need to do an access via one
    of the shortcut registers again before we can issue custom commands again.
    The m25q driver tries to do a dummy read to exit out of XIP mode. To make
    this work, qspi_lld_receive() has been modified to look for a read with
    a command opcode of 0 and will issue a read via shortcut registers. This
    unjams the interface again.
2018-09-25 push partial hardware to github
    [DC27-DC Power.sch, DC27-SAO.dsn, DC27-SAO.kicad_pcb, DC27-SAO.sch, DC27-peripheral.kicad_pcb, DC27-peripheral.sch, DC27Audio.sch, DC27LED_INTERFACE.sch]
2018-09-25 Add support for having a filesystem on the QSPI flash
    Since we have additional storage on QSPI, we may as well do something
    useful with it. The FatFs support has been extended to have a second volume,
    and a diskio driver has been added on top of the ChibiOS flash support.
    Since the QSPI is memory mapped, reads should be fairly quick. (In
    retrospect, it may make more sense to use DMA for the reads, but further
    experimentation will be needed to tell.)
    Also, the qspi_lld_stop() routine has been filled in a little more.
2018-09-25 Fix a few things with the QSPI FatFs support
    One of the #ifdefs in diskio.c was wrong, which broke the QSPI
    disk_initialize() method.
    In order to use the second driver easily, we need to enable support
    for f_chdrive() in FatFs.
    Also, the 52832 doesn't have QSPI, so make sure the support for it is
    disabled in the badge_832 Makefile so we don't get a linker error.
2018-09-26 Check in forgotten QSPI/FatFs shim driver files
2018-09-26 Do some more QSPI refinements
    In the qspi_lld_receive() function, we need to special-case the
    FAST_READ command too, in order for the flashRead() API to work
    correctly.
    Now that this works, switch to using flashRead() in qspi_disk_read() too.
    This means FatFs accesses will use DMA instead of a memcpy(). The result
    is the same, but using DMA in theory requires fewer CPU cycles.
    I think the fastest mechanism overall may be to directly call qspiReceive()
    and qspiSend() from drv_qspi_lld.c, but it's hard to benchmark until I get
    a production board.
2018-09-27 Make NRF52832 build work again
    I forgot to update the NRF52832 board.c to include the IOPORT1
    base address when I added multi-port support for the NRF52840.
    This breaks bootstrap. :(
2018-09-28 Add some missing SPI macros
    Now that I can actually test SPI bus 3, it turns out I forgot to add some
    of the definitions required for it. This has been fixed.
2018-09-30 Fix a bug in the keyboard module
    We need to make sure the clip area variables for the display are cleared.
    The gdispGFillArea() function uses a macro TEST_CLIP_AREA() which may
    return false if we don't do this, which causes the fill to actually be
    skipped.
    [ui-keyboard.c]
2018-09-30 Add some additional synchronization
    Add a dsb (data sync barrier) instruction at the end of all the asynchronous
    DMA starting functions so that all of the register updates are written out.
    This is required with certain C compiler optimization levels to make sure
    transfers start before we start looking at the state registers for the
    SPI controller.
2018-09-30 Switch to using the high speed SPI bus
    We now use SPIM3 instead of SPIM0. The bus clock is set for 32MHz,
    the fastest it can go. Sadly, we appear to be limited by the throughput
    of the SD card.
    Note that the pins for the SPI bus have been changed. While the
    NRF52840 does have an additional 16-pin port of GPIO pins, you
    can only use them for low speed I/O, according to the manual.
    Using SPI0 at 8MHz works ok, but using SPI3 at 32MHz does not.
2018-09-30 Increase the async I/O thread stack size a little
2018-09-30 Make the video player work again
    Now that the screen and SD card are sharing a SPI bus again, we need
    to acquire/release the bus lock correctly.
    [video_lld.c]
2018-09-30 Add code to switch flash chip to SPI mode.
    The Macronix serial flash parts default to operating in single-I/O mode.
    That means they only use one serial data line. We need to switch the
    chip to quad-I/O mode for QSPI operation. This is done by setting a
    bit in the status register. This is documented in a Macronix application
    note, though not in the chip reference manual (at least, I couldn't find
    it). The Nordic QSPI example has code in it for this, but it doesn't
    go out of its way to explain why it's there.
    This is a non-volatile bit, so we only need to set it once. The Nordic
    boards come with the Macronix chip still at factory default settings
    so we need to do it the first time we boot up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
    [main.c]
2018-10-02 Fix updater build (I/O pin definitions changed)
    [updater.c]
2018-10-03 Add a ChibiOS-compliant driver for the NRF52 flash.
    Since ChibiOS has a flash driver interface now, we may as well
    also provide a driver for the NRF52 on-board flash. This code is
    relatively complete, but still needs to be tested, so it's not
    hooked up to the rest of the build yet.
2018-10-03 Update EXT module to support additional GPIO pins
    The NRF52840 has a second bank of 16 GPIO pins. The GPIOTE module
    supports the second bank by adding an extra bit to the pad selection
    field. Bits 6-12 define pin number to use, and bit 13 defines which
    port to use (0 or 1). In order to allow the user to specify that a
    pin should be on port 1, we need to adjust the EXT_MODE_GPIO_MASK
    definition to allow one extra MSB.
2018-10-04 Finish setting up on-board flash support
    Fixed some bugs in the on-board flash driver and finished tying it into
    the system. The device FLASHD1 is for the QSPI flash and FLASHD2 is for
    the on-board flash. The same ChibiOS flash API works for both.
    [ble_lld.c, main.c, nrf52flash_lld.c, nrf52flash_lld.h]
2018-10-04 The nrf52FlashStop() function doesn't need a "config" argument.
    [nrf52flash_lld.c, nrf52flash_lld.h]
2018-10-05 Move touch chipsel and screen chipsel pins
    The touch controller SPI chip select and screen SPI chip select pins have
    been moved to P0.3 and P0.4. This leaves all of port 1 empty (for now).
    The reason for this is that it makes it easier to position most of the
    prototype screen module pins together on the same header on the
    NRF52840 DK development board. The exception is the SD card chip
    select, which is on a header by itself at P0.13.
    Eventually we may need some of the P1 pins for the I2S controller.
    Hopefully they will work well enough for this: the manual says they
    should be used for low-speed I/O only, but the MCLK can be as fast
    as 16MHz in some cases.
    Any buttons can use the port 1 pi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
2018-10-05 Fix sample QSPI init function
    Switch the setup_flash() function in main.c back to using the regular
    flash API instead of trying to use the QSPI controller directly. It
    doesn't seem to work right that way.
    [main.c]
2018-10-07 Add initial I2S audio support
    A driver for the Nordic I2S audio controller has been added. This is
    intended to work wih the Cirrus Logic CS4344 I2S codec. Currently the
    audio sample rate is 15625Hz and audio is monaural. This can be changed
    to stereo fairly easily, but it increases the file size.
    A script to encode audio using SOX has also been added.
    The API is similar to what was in the DC25 badge.
    There will likely be some streamlining later.
2018-10-07 Adjust audio sample rate
    Using 12500Hz yields smaller video files. Also, increase the priority of
    the I2S thread so that it's higher than the gtimer thread. It has to be
    less than the priority of the SoftDevice event handler thread though.
2018-10-08 commit the current hardware files
    [DC27-DC Power.sch, DC27-badge.kicad_pcb, DC27-badge.sch, DC27-peripheral.kicad_pcb, DC27Audio.sch, DC27LED_INTERFACE.sch, DC27LEDs.sch]
2018-10-08 Update the main schematic with pins from bill's changes
    [DC27-badge.kicad_pcb, DC27-badge.sch]
2018-10-08 Clean up SPI bus, set correct pins, start working through DRC errors.
    [DC27-DC Power.sch, DC27-badge.sch, DC27Audio.sch, DC27LED_INTERFACE.sch, DC27LEDs.sch]
2018-10-10 Set the low-speed clock source to "synth"
    The NRF52840 uses two clocks: a high speed clock and a low speed one.
    A 32MHz crystal is required for the high speed clock. The low speed
    clock source can be one of three things:
    NRF_CLOCK_LF_SRC_RC (0) Internal 32.768KHz RC oscillator
    NRF_CLOCK_LF_SRC_XTAL (1) External 32.768KHz crystal (P0.0/P0.1)
    NRF_CLOCK_LF_SRC_SYNTH (2) Synthesized from 32MHz high speed clock
    Using the SYNTH option gives us the best results with the smallest parts
    count. The BMD-340 module already has a 32MHz crystal inside, so this
    avoids the need for a second 32.768KHz crystal on the badge board.
    [board.h, mcuconf.h]
2018-10-14 Fix some bugs related to advertising and chat
    When advertising, we must allocate a static buffer to hold our
    advertising data instead of allocating it from the heap and then
    freeing once advertising is started. The SoftDevice does not copy
    the data to a private buffer: instead it expects the advertisement
    block to remain unchanged. With the previous code, pointer to the
    advertisement block ceased to be valid once we called chHeapFree(),
    and the buffer could be re-used for other things, which would
    suddenly cause us to send invalid advertising data at seemingly
    random times.
    Also, we need to implement a queue to handle radio events. Having just
    a single bufferf causes us to lose too many adv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
    [app-chat.c, ble_gap_lld.c, ble_lld.c, orchard-app.c]
2018-10-14 Increase the stack size of the I2S thread
2018-10-14 Fix the firmware updater, which has become bitrotted
    We need to do the following things with the new board:
    - Make sure we turn off the SPIM device. The firmware uses device SPI3
    with DMA while the updater uses SPI0 with programmed I/O. But both
    need to use the same pins. The firmware has to disable SPI3 before
    handing off control to the updater, otherwise the chip will still
    think SPI3 owns the pins.
    - To be safe, we need to include the PAL code in the updater to initialize
    the GPIO pins to the desired state.
    [app-update.c, mcuconf.h, updater.c]
2018-10-16 Add on-board flash support to completed list
2018-10-16 Use palSetPad() API
    Since we ended up using the PAL module to initialize the state of the
    GPIO module, we may as well also use it to set the state of the SPI chip
    select pins instead of groping the registers directly.
2018-10-18 Allow DMA chunk size to be configured independently
    Only the SPID4 bus allows a chunk size larger than 255 bytes. In order to
    be able to flexibly configure this, we need to have two CHUNK macros
    so that we can specify a value for the slow buses too.
2018-10-18 Move the SD card and touch controller to a separate SPI bus
    The SD card and touch controller are now on the SPI0 bus, leaving the
    display on the fast SPI3 bus. Three more GPIO pins have been allocated
    for this.
    Also, one of the I2C controllers is now enabled. Two pins have also been
    allocated for this. I haven't had a chance to test this yet, but ChibiOS
    already has a driver for this peripheral and I have no reason to think it
    won't work. (I'll need to drag out the scope to be sure. For now it
    doesn't hurt anything to enable this.)
    [board.c, board.h, main.c, mcuconf.h, mmc_spi_lld.c, xpt2046_lld.c]
2018-10-18 Fix a couple of bugs in the QSPI driver
    Running with checks enabled exposed a couple of problems with the
    QSPI driver. These have been fixed.
2018-10-18 Adjust the behavior of the QSPI flash driver
    We want to use subsector erase commands, since these can erase 4096
    byte regions instead of 32768. This may make FatFs support a little
    less troublesome.
    Also, add some definitions to prevent asserts from triggering in the
    m25q.c driver when checks are enabled.
    [mcuconf.h]
2018-10-18 Fix some bugs exposed by building with checks enabled
    [main.c]
2018-10-18 Update video player
    The video player works a bit better now that the SD card has been moved
    to its own SPI bus. It still doesn't play audio. This will hopefully
    be done soon.
    [video_lld.c, video_lld.h]
2018-10-20 Fix a memory leak in the radio event queue handling
    When a app exits, we have to free all the memory allocated for any
    radio events left in the queue, not just reset the producer/consumer
    indexes. Otherwise we may gradually leak memory. A new function
    to flush out the queue has been added which is now called at thread
    creation and termination.
    [orchard-app.c]
2018-10-20 Fix compiler warning in the NRF52 flash driver
    [nrf52flash_lld.c]
2018-10-20 Fix inconsistent macro names in QSPI driver
    [mcuconf.h]
2018-10-22 Fix a priority order violation assert flagged by ChibiOS
    When debug checks and asserts are turned on in chconf.h, ChibiOS will
    flag a "priority order violation" error when the system is running. This
    seems to be due to the SysTick interrupt priority. Previously it was set
    to 1. Changing it to 5 (a lower priority) seems to correct the error.
    This is only a problem when the SoftDevice is enabled, but we need it
    enabled for the radio to work.
    All IRQ priorities are now configurable via the mcuconf.h file. Right
    now they're all set to 5.
    This took me far too long to track down. :C
    [ble_lld.c, halconf_community.h, i2s_lld.c, mcuconf.h]
2018-10-23 Grrr. Fix another typo.
    The interrupt priority macro for SPI bus 3 was wrong. I thought the
    priority was being set to 5, but it was still 3. (Checked the NVIC
    registers to be sure.)
2018-10-23 Fix some more interrupt priorities
    The QSPI interrupt priority setting was using the wrong macro name.
    Also, set the SysTick priority to 7 (which I think is the lowest available).
    [mcuconf.h]
2018-10-23 Fix the firmware updater
    The SPI bus configuration needs to be updated again now that the SD card
    is on its own bus.
    [updater.c]
2018-10-28 Give the joypad interrupt handler thread some more stack.
2018-10-28 Move memory barriers to graphics driver
    I don't think the SPI driver really needs to have the memory barrier
    instructions in it. I think the write_index() and write_data() functions
    are the real problem children. Moving the __DSB() instructions there seems
    to make it more reliable. While working on the video player the screen
    would fail to initialize sometimes, and it looks like this may have had
    to do with the compiler re-arranging the code a little. I *think* it's
    better now.
2018-10-28 Make video player fully functional
    The video player can now play full audio/video files. The audio sample rate
    is also now 15625Hz in stereo. Video plays at 13 frames/second.
    Getting video and audio to sync was a little tricky. Unfortunately the
    Nordic I2S controller only provides only a very limited set of clock
    frequencies, which limits what frame rates we can select. John wanted
    16KHz. The closest we can get without going too crazy is 15625Hz.
    The problem is there's no way to get a whole number of samples per
    scanline like we could with the DC25 badge.
    The only way to deal with this is to match the video and audio sample
    rate as best as we can, and then drop a sample once in a while whe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
    [app-video.c, async_io_lld.c, i2s_lld.c, mcuconf.h, video_lld.c, video_lld.h]
2018-10-28 Remember to delete the sample.skip file
2018-10-28 Update the video encoding script.
    So, the gimmick of occasionally dropping a sample works, but it has a
    problem: it creates an occasional click/pop in the audio stream.
    I'm not sexy enough to figure out how to work around this (I assume it
    would take some kind of smoothing algorithm), so I'm going to take the
    easy way out and change the video encoder script so that it simply
    re-encodes the audio for a rate of 15600Hz using the sox utility. It's
    way smarter about audio than I am. The rate is close enough that the
    listener can't really tell the difference and sycnhronization is
    right where we want it.
2018-11-04 Fix a possible crash in radio event handling
    Add an extra sanity check: avoid crashing if we're sent a radio
    advertisement with a 0 length friendly name (doing a malloc of 0
    bytes is illegal).
    [chconf.h, orchard-app.c]
2018-11-04 Fix another macro bug in the SPI driver
    The anomaly 58 workaround was still being compiled in even though we
    don't want it for the 52840 build. I keep forgetting that ChibiOS likes
    to use #if foo instead of #ifdef foo for controlling conditional
    compilation.
2018-11-04 Do some major cleanups of the I2S module
    The i2sSamplesSend()/i2sSamplesNext() API has been replaced by just
    i2sSamplesPlay()/i2sSamplesStop(). You can just keep resubmitting
    samples with i2sSamplesPlay() until you're done, then use i2sSamplesStop()
    to turn off the channel. (This is necessary to gate off the SDI clock.)
    Also, the i2sSamplesWait() API now no longer needs to rely on a busy
    loop. Contrary to what I expected, the I2S controller doesn't interrupt
    when the current batch of samples has finished being transfered to the
    codec. It interrupt before that, so I had to resort to using a loop
    to test the EVENTS_TXPTRUPD register. The problem with this is that
    doing it without a sleep hogs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
    [i2s_lld.c, video_lld.c]
2018-11-10 Increase video playback rate from 13fps to 16.25fps
    It turns out there was just enough SD card I/O bandwidth left to squeeze
    out a few more frames per second. At 16.25fps, we still end up with an
    audio sample rate of 15.600KHz which is acceptable for our purposes.
    Fortunately ffmpeg supports fractional frame rates.
2018-11-11 Enable internal pullup resistors for I2C pins
    I2C requires the use of pullups. This avoids the need for extra external
    parts. I2C support tests good with scope now.
2018-11-11 Mention that I2C support is now tested
2018-11-11 Fix another typo in the EXT driver
2018-11-11 Avoid another possible crash when UI is NULL
    [app-video.c]
2018-11-11 Add support for 3 more buttons
    The joypad module has been updated to correctly handle select, A and B
    buttons on GPIO port 1. I think this finishes all the I/O support.
    [board.c, board.h, joypad_lld.c, joypad_lld.h]
2018-11-11 Give the joypad thread some more stack space
2018-11-11 Add support for both BUTTON_UP and BUTTON_DOWN events
    This duplicates an enhancement made in the DC25 badge code.
2018-11-11 Do a round of UI/sound cleanups
    There was a bug in the I2S audio player. When queueing up samples, we
    should play however many samples we read from the file, not I2S_SAMPLES.
    This didn't appear to be a problem until I tried playing the click
    sound effect, which is really short.
    The joypad support has been reworked. We can't just call the orchard
    event handler routines from the joypad thread: that will cause the
    joypad event thread to race with the orchard app thread. In some
    cases this race condition can be fatal. Instead we gather the keypress
    info and signal an event using the dispatcher.
    Playing of the click sound effect has been re-enabled. The click sound
    has to be re-encoded using th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
    [app-credits.c, app-launcher.c, app-video.c, i2s_lld.c, joypad_lld.c, orchard-app.c]
2018-11-12 Change SD card chip select pin config
    We want to enable the internal pullup resistor for the SD card
    chip select pin, for extra stability (and great justice).
    [board.c]
2018-11-14 update badge schematic with new pins, verify every pin
    [DC27-DC Power.sch, DC27-badge.sch, DC27Audio.sch]
2018-11-15 Fix possible race with gtimer thread
    I noticed that sometimes the icons on the launcher would appear to have
    some corruption after pressing the up/down arrow buttons on the screen
    (via touch).
    The problem is that touch events are polled and processed by the gtimer
    thread. Button up/down events can cause button appearance to change a
    little, i.e. buttons are highlighed when pressed and returned to normal
    when released. This means the gtimer thread will do some screen draws
    when button up/down events occur.
    This also causes minor changes to the display state variables, notably
    the clip regions.
    Because of reasons, the launcher app doesn't allow the gwin code to draw
    the button icons: instea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
    [app-launcher.c, ui-keyboard.c]
2018-11-16 Fix mutex usage in the keyboard ui module.
    [ui-keyboard.c]
2018-11-17 Fix the grid formatting in the launcher app a little
    - Icons are 80x80 pixels. In order to draw the red outline box correctly,
    it needs to be 82x82 pixels, not 81x81 pixels, or else it'll overwrite
    part of the icon border.
    - The outline box also needs to be shifted one pixel up and one pixel over.
    - We need to move the grid 1 pixel over along the X axis in order to
    make the above correction, or else the left edge of the outline box will
    be clipped off when we draw it around the icons in the first column
    - We also need to adjust the position of the text labels a couple of pixels
    to make sure they're centered with the icons.
    [app-launcher.c]
2018-11-17 Improve the joypad reliability
    We really need to keep scanning for GPIO stage change events until there's
    none left to be serviced so that we're sure we don't miss any transitions.
2018-11-24 Fix a warning when building with GCC 8.2.0
    uGFX things that ChibiOS threads return an int32_t when they exit.
    Maybe that was true once, but in v18 they return void. GCC 8.2.0 is
    smart enough to notice this and warn about it. The gos_chibios macros
    have been updated to reflect this.
2018-11-25 Upgrade S140 SoftDevice to version 6.1.1
    Something seems to have changed with the bootstrap code in this version
    of the SoftDevice. It gets stuck in a loop during boot, always branching
    back to the entry point at 0xA81, unless I patch a couple of locations
    at address 0xFF8 and 0xFFC to 0xFFFFFFFF instead of 0. (Strictly speaking,
    it seems only necessary to patch offset 0xFF8.) I'm not sure what this is
    all about, but aside from that, the SoftDevice seems to work.
2018-12-30 checkpoint all of the kicad stuff
    [DC27-DC Power.sch, DC27-badge.sch, DC27Audio.sch, DC27LED_INTERFACE.sch, DC27LEDs.sch, file5C2B533B.sch]
2019-01-11 Fix the RTC systick timer option and enable tickless mode
    Using the ARM SysTick timer and periodic tick mode, we get a timer tick
    interrupt at regular intervals. The elapsed ticks are used to handle
    chThdSleep() delays. The only problem with this is that the periodic
    ticks wake the CPU up every so often even when there's no work to do,
    which consumes power.
    Using tickless mode, timer interrupts only occur when delays actually
    expire. This reduces CPU consumption and in theory saves power.
    [chconf.h]
2019-01-11 Display reset causes at boot
    The nRF52 has a reset reason register we can use to determine why
    the CPU was reset (soft reset, reset pin assert, watchdog, etc...). We
    may as well display this info.
    Also, when the SoftDevice encounters a fault, it calls the fault handler,
    which currently does nothing. Now we use it to stash the SoftDevice
    fault info and display it on boot as well. The SoftDevice will trigger
    a fault if it doesn't detect timer or radio events often enough. This
    can happen if you pause the system with the debugger. When you resume,
    the SoftDevice will detect the problem and reset the system. Now we
    can tell when that happens. (Unfortunately I don't know how to decode
    the event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
    [ble_lld.c, main.c]
2019-01-11 Add missing badge.h changes forgotten in last commit.
    [badge.h]
2019-01-12 checkpoint everything - schematic passing DRC
    [DC27-DC Power.sch, DC27-badge-grouped-bom.csv, DC27-badge.kicad_pcb, DC27-badge.sch, DC27Audio.sch, DC27LED_INTERFACE.sch, DC27LEDs.sch, file5C2B533B.sch]
2019-01-12 Add audio amp shutdown pin (P0.02)
2019-01-12 add pull ups to debug
    [DC27-badge.sch]
2019-01-13 Always leave the screen chip select pin asserted
    The display is the only slave device on the SPI4 bus, so we can save
    some CPU cycles by just leaving the screen selected all the time.
2019-01-24 Fix bitrot in nRF52832 BSP
    The SysTick timer interrupt priority is set in mcuconf.h now. We need
    to make sure it's not too high or the SoftDevice won't start.
    [ble_lld.c, mcuconf.h]
2019-01-28 Add some debug documentation and scripts
    Document how to use the nRF52 and OpenOCD with various debuggers. Also
    document how to perform a device recovery using OpenOCD, and how to
    enable ChibiOS RTOS awareness.
2019-01-31 Add some documentation to the video encoder script.
2019-02-03 Fix BLE event handling and make a few cleanups
    BLE event handling has been unreliable ever since I added support for
    also handling SOC events (which was needed for using the SoftDevice
    flash APIs). We were dropping events in some cases which was totally
    screwing up BLE handling. The logic is now more robust and we shouldn't
    lose events anymore.
    Also included are the following cleanups:
    - Split BLE_IDES_L2CAP_LEN into BLE_IDES_L2CAP_MTU and BLE_IDES_L2CAP_MPS.
    These values should be independent.
    - Initialize the ATT table. Apparently setting it to 256 actually reduces
    the SoftDevice RAM usage.
    - In the chat app, don't try to do an L2CAP disconnect if we were unable
    to set up an L2CA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
    [app-chat.c, ble_gap_lld.c, ble_l2cap_lld.c, ble_l2cap_lld.h, ble_lld.c, ble_lld.h]
2019-02-03 Revert debug changes to bleL2CapConnect().
    [ble_l2cap_lld.c]
2019-02-04 Add preliminary support for GATT services
    A module is now provided which allows the badge to report its device info
    via GATT services. Currently these are read-only. We could add some writeable
    ones later I suppose.
    There is still no GATT client module yet.
2019-02-04 try to clean up the schematic and libraries
    [DC27-badge.kicad_pcb, dragon-150mmx90mm.dxf, dragon.dxf, dragon2.dxf, dragon3.dxf]
2019-02-04 clean up fp libraries
    [DC27-DC Power.sch, DC27-badge.sch, file5C2B533B.sch]
2019-02-04 Un-do damage from previous commit
    John's merge somehow reverted a bunch of code changes. This should
    fix things.
    [badge.h, chconf.h, joypad_lld.c, main.c, nrf52flash_lld.c]
2019-02-04 Update to-do list
    Move GATTS support to the completed list
    Add BLE PIN item to the to-do list
2019-02-07 Fix firmware updater build again.
    [halconf_community.h, mcuconf.h]
2019-02-08 Add proper fault handling and display support
    Support has been added for proper decoding and displaying of CPU faults.
    Highlights:
    - Bus fault, usage fault and memory manager exception vectors are now
    enabled, so that we can decode these directly instead of having
    everything fall through to the HardFault handler.
    - Brute force UART output routine added so that we can display things
    on the serial port from the exception handler
    - All exception causes decoded
2019-02-08 Correct some remaining issues with the fault handler support
    I wasn't preserving the link register value correctly, and I forgot to
    check in the changes to main.c to enable the different fault handler
    vectors. I need to stop doing this when I'm tired.
    [main.c]
2019-02-10 Enable stack guard regions and clean up fault handling some more
    The Cortex-M4 CPU has a memory protection unit (MPU), which ChibiOS can
    use to provide hardware stack guard support. We may as well turn this
    on. While tinkering with this I discovered a few issues:
    - The stack guard is a 32-byte region which is protected by the MPU.
    To make things work, the stacks need to be aligned on a 32-byte
    boundary, but the linker script currently enforces only an 8-byte
    alignment. We need to change this otherwise the stack guard region
    at the end of the main thread stack overlaps into the start of the
    exception stack, and we blow up on boot.
    - ChibiOS has a value called PORT_INT_REQUIRED_STA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
    [badge_vectors.c, chconf.h]
2019-02-10 Be sure to drain any UART TX events before writing new characters.
2019-02-10 Fix serial handling a little more
    Apparently we need to wait a little bit after setting the UART
    configuration before enabling it, otherwise we might end up sending
    some garbled characters. This is only noticable if you trigger
    an exception very early.
    [badge_vectors.c]
2019-02-10 Use some more elegant assembly code in CommonFault_Handler().
2019-02-10 Move serial port delay to the trap handler.
    I'm not sure why this is necessary, but without it we get garbled
    output from the frame decoder function.
2019-02-10 Set the name of the shell thread.
2019-02-10 Add back the delay in the serial driver initialization.
2019-02-11 Add support for GAT data length update events.
    My Blackberry doesn't send these, but apparently other phones do.
    Not sure if they work right yet though, I'll have to test with John's
    phone.
    [ble_gap_lld.c, ble_lld.h]
2019-02-13 Switch back to using compact kernel mode.
    Due to the way the SoftDevice works, the ChibiOS context switch code
    can be preempted by high priority radio interrupts. Technically this
    won't break things as long as we have enough stack space, but having
    the context switch code interrupted seems like a bad idea.
    Also, we now have the idle thread use the WFI instruction to put the
    CPU to sleep rather than have let it run in a busy loop. This may save
    us a small amount of power.
    [badge_vectors.c, chconf.h]
2019-02-17 add gerbers for prototype
    [DC27-DC Power.sch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]
2019-02-17 add samtec library, more gerberger files
    [DC27-badge.dsn]
2019-02-17 Add the touch tone dialer app
    This is a port of the app from the DC25 badge, with fixups for using the
    nRF52 IS2 controller instead of a DAC.
    Note: the dialer app turns off the radio and then turns it back on again
    on exit. When the SoftDevice is enabled, there seems to be a fluctuation
    in the I2S clock(s) which causes a "wobble" in the tones. This doesn't
    seem to affect them being decoded, but it sounds weird, so we work around
    it for now.
    [app-dialer.c, i2s_lld.c]
2019-02-18 Apply a fix from the DC25 badge code base:
    [...]
    The GetMouseReading() function has a local GMouseReading structure
    which is stored on the stack, however it does not initialize this
    structure before attempting to use it. This results in the r.buttons
    sometimes containing bogus values which causes some strange behavior
    of the mouse button event handling logic.
    The structure is now zeroed before being used.
    [...]
2019-02-18 Add an initial port of the music player app
    The bar graph is not yet enabled. I need to figure out how to implement
    that given that we now have stereo sample data in our sound files.
    Also, fixed a bug in the scroll and music apps: the geventDetachSource()
    function clears the mouse event data, so we have to evaluate whether
    to exit with 0 or -1 status before calling it, not after. This bug would
    prevent the exit click sound from playing in some cases.
    [app-music.c, scroll_lld.c]
2019-02-18 check in all datasheets, BOM tools, and start to get first fab together
    [DC27-DC Power.sch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]
2019-02-18 remove cruft
    [DC27-badge-grouped-bom.csv, dragon.dxf, dragon2.dxf, dragon3.dxf]
2019-02-18 rename some files for macrofab
    [DC27-badge.xln]
2019-02-18 Add missing click effects on app exit.
    [app-email.c, app-ledsign.c]
2019-02-19 prototype sent to macrofab!
    [DC27-badge-B.Cu.gbl, DC27-badge-B.Mask.gbs, DC27-badge-B.Paste.gbp, DC27-badge-B.SilkS.gbo, DC27-badge-F.Cu.gtl, DC27-badge-F.Mask.gts, DC27-badge-F.Paste.gtp, DC27-badge-F.SilkS.gto]
2019-02-19 update bom
    [bom-merged.xlsx, bom-simplified.xlsx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]
2019-03-03 Add a wilhelm scream sound effect.
    This replaces the Homer "Doh!" sound effect from the DC25 badge which was
    used as an error indication when you entered too many characters via the
    ui-keyboard widget. The ui-keyboard.c widget has been been updated to
    use this now.
    [ui-keyboard.c]
2019-03-04 Add initial FFT support to the music player
    This will likely need some refinement later, but for now it works
    reasonably well. I think I still need to figure out a better way to
    do scaling. The columnDraw() mechanism has been improved in that
    it no longer needs to do an erase operation.
    A few more sound effects have also been added.
    [app-music.c, fix_fft.c]
2019-03-07 Remove custom math routines
    Apparently I had not compiled my local version of newlib using hardware
    floating point support for ARM Cortex-M4. This meant that various
    routines in libm didn't work right. Now that I've fixed that, it looks
    like we don't really need the custom sin() and sqrt() routines anymore.
    Also, the sample count for the KP1 bluebox button in the touch tone
    dialer app was wrong. This has been fixed.
    [app-dialer.c, app-music.c]
2019-03-07 Make dialer button array static again
2019-03-07 Move the stubs to assembly code
    Newer versions of GCC emit warnings due to us aliasing various different
    functions to _port_irq_epilogue() (it knows the types don't match). Trying
    to prevent this in C is messy, but we can just as easily move the stubs
    to the entry.S file and achieve the same effect.
    [updater.c]
2019-03-07 Always use word accesses when writing to the flash
    Also fix the code so that it compiles properly when the softdevice
    is disabled.
    [nrf52flash_lld.c]
2019-03-07 Correct non-softdevice flash handling a little
    [nrf52flash_lld.c]
2019-03-08 Improve the music visualization a little
    We can show 2-pixel bars instead of 4-pixel bars to improve resolution.
    I still need to work logarithmic scaling for the X axis, but I'm too
    tired to deal with that tonight.
2019-03-09 Update the audio and video encoding scripts a little
    Using s16 as the file suffix should be enough to get sox to encode the
    samples correctly. Also, try to boost the sound playback loudness.
2019-03-10 Avoid byte swapping pixels in driver
    Fix another thing that's been bugging me for a while: I don't want to
    have to byte-swap pixels in the ILI9341 display driver. I added this
    before because the nRF52840 SPI controller doesn't have a way to perform
    internal byte-swapping. With the KW01 chip in the DC25 badge, you could
    specify that data was to be handled 16 bits at a time, and it would send
    the pixels out onto the SPI bus in the right order, but tge nRF52840
    controller doesn't do that, so it sends them out a byte at a time.
    Unfortunately this causes the pixel data written to the screen to be
    byte-swapped, so the colors come out wrong. The __builtin_bswap16() I
    put into the driver was a worka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
2019-03-16 Fix the high frequency clock initialization
    It turns out the ChibiOS hal_lld.c code was setting the chip to use the
    internal RC oscillator for the 64MHz CPU clock. This is why audio from
    the I2S chip had a warble it whenever the radio was enabled: the extra
    CPU load from the radio was causing oscillator drift. With the external
    crystal and the HXCO enabled, it's perfectly steady.
    The dialer app no longer disables the radio when its running now.
    [app-dialer.c]
2019-03-16 Add support for powering up/down audio amp
    This doesn't exist on the DK board, but the LM4880 audio amp on the
    real board can be put into low power mode via GPIO pin P0.02 (high
    to power off, low to power on). This disconnects the bias supply to
    the amplifier transistors. Consumption should be 7uA when we're not
    playing sound. The I2S module now toggles this line when playing a
    tune, and an API is now available for other consumers of the I2S
    controller (video player, music player, DTMF dialer), to manipulate
    it as well.
    [app-dialer.c, app-music.c, board.c, board.h, i2s_lld.c, video_lld.c]
2019-03-17 Avoid initializing SPI bus 4 on broken preview chips
    The rev AAAA nRF52840 chips don't have a working high speed SPI bus
    controller, and we'll get stuck trying to boot on one of those when
    we try to enable the display. I have one preview DK board that I use
    for radio debugging and I'd like to avoid this, so if we detect
    the preview silicon, we skip the graphics setup.
    [main.c]
2019-03-20 Cosmetic fix: change macro name from DC26 to DC27
    [ble_gap_lld.c, ble_lld.h]
2019-03-21 check in all of the gerbers and artwork
    [DC27-DC Power.sch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]
2019-03-21 Disable QSPI support for now.
    The production board doesn't have a QSPI chip, and probing for it will
    hang the boot process, so QSPI support is disabled for now.
    [main.c]
2019-03-21 Update the putImageFile() function to draw images faster
    This still doesn't draw as fast as I think it should, but it's better
    than the default uGFX behavior.
    [ides_gfx.c]
2019-03-21 Make some updates to the BLE GAP code
    We now support advertising our name via scan responses. Scan responses
    can be sent by devices which identify as "scannable." After a peer
    receives an advertising broadcast for a scannable device, it can send
    a scan request to obtain an additional 31 bytes of identifying payload.
    This is handy because squeezing a nice name into 31 bytes along with
    UUID and other info can be tricky.
    It turns out that in order to reliably receive scan responses, we have
    to request active scanning, and we also have to be sure to call
    sd_ble_gap_scan_start() each time we receive a GAP advertisement
    report. This was not made quite clear by the API documentation, but
    that's wh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
2019-03-21 Closes issues #1, #2, #3 (see github)
    - #1 Removes copper fill under bmd340
    - #2 Add ON label
    - #3 Add pin 1 indicator and label for jtag
    [DC27-badge.kicad_pcb]
2019-03-21 Add support for BLE_GAP_EVT_PHY_UPDATE_REQUEST event.
    Hopefully this will fix connecting to the badge from iPhones.
    [ble_gap_lld.c]
2019-03-21 Add missing updates to scroll_lld code.
    [scroll_lld.c, scroll_lld.h]
2019-03-22 Try to fix iPhone connection issues.
    iPhones request extended data lengths to increase throughput. The max
    should be 251 bytes. We need to specify a GATT MTU of 247 payload bytes
    to satisfy this. Hopefully the extended data updates will work now.
    [ble_gap_lld.c, ble_lld.c]
2019-03-22 Add code to set the reset pin in the UICR if it's unprogrammed.
2019-03-23 Fix an issue with the DTMF dialer app
    When playing tones, we need to temporarily boost the priority of the
    DTMF dialer thread. The BLE SoftDevice event handler thread has the
    highest priority, and if it interrupts the tone dialer, it creates
    small gaps when playing some tones which sound like radio interference
    but really aren't. (Well, not the same kind of radio interference we
    had witht he previous board anyway.)
    The dialer app does have code to boost priority, but it's assuming
    the old badge priority scheme. The SoftDevice thread runs at HIGHPRIO,
    which is the highest available. To address this, we knock the SD thread
    priority down a few notches to allow the dialer app room to outmuscle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
    [app-dialer.c, ble_lld.c]
2019-03-23 Remove debug printf()s
2019-03-23 Finally iPhone connectivity issues
    To handle length update requests and GATTS MTU update requests, we just
    need to reply with what we support as length values. This means we don't
    need a bunch of extra memory. The Nordic nRF Connect app on iPhones can
    read our device identification info now.
    [ble_gap_lld.c, ble_gatts_lld.c, ble_lld.c]
2019-03-23 Undo debug #ifdef
    I turned off the appearance setting for debugging the iPhone issue
    and forgot to turn it back on again.
    [ble_gap_lld.c]
2019-03-24 Fix the definitions for buttons 5,6 an 7
    These buttons on are on pins 9, 10 and 11, not 10, 11 and 12.
    [board.c, board.h]
2019-03-24 Fix a bug in the music player
    When the music player is active, we don't want to allow any other
    thread to queue up a music file to play, so just like in the video player,
    we need to set i2sEnabled to FALSE while we're playing a tune.
    [app-music.c]
2019-03-25 Add macros to define role advertisements.
    This avoids using a magic number.
    [ble_gap_lld.c, ble_lld.h]
2019-03-25 Check in most of my working led code, still needs mapping and anim threads.
    Needs further work to clean up i2c communications.
2019-03-26 add led test, fix the led table, fix color assignment of leds
    [led.c, main.c]
2019-03-26 Add some enhancements to the video player module.
    Like the DC25 badge, add a function to allow playing un-expanded video
    clips at arbitrary places on screen. (We never used this feature last
    time, but maybe this year will be different.)
    Also, we can suspend the current thread to wait for the display SPI bus
    to become ready instead of using a while() loop.
2019-03-27 Make the IS31fl driver return a true/false depending if the i2c bus can talk to the led driver. If it's not there, don't start led FX.
    Write randbyte() and randrange(min,max) calls for animation work
    Add a couple of basic animations (Flame, bouncy-ball) for testing
    Start to get userconfig working again in flash.
2019-03-27 Fix reversed row3/row4 on LED mapping, add KITT animation
    [led.c]
2019-03-27 Fix nrf52_read().
    The flashRead() routine expects 'n' to be number of bytes, not sectors.
    Also fixed userconfig.h to define CONFIG_FLASH_ADDR as 0xFF000, which is
    the offset where the userconfig region will be stored, and fixed
    configStart() to use CONFIG_FLASH_ADDR instead of CONFIG_FLASH_SECTOR
    when reading.
    [nrf52flash_lld.c, userconfig.c, userconfig.h]
2019-03-27 fix led off by one bugs, fix flash config, add a couple led anim patters
    [led.c, userconfig.c, userconfig.h]
2019-03-27 add led config and config command
2019-03-28 Switch to using the newlib malloc(), free() and printf() routines.
    Previously we were relying on the chprintf(), chHeapAlloc() and chHeapFree()
    functions in ChibiOS. As of now, we can use the slightly more standard
    APIs provided by newlib. We need to disable the ChibiOS heap allocation
    routines because otherwise we'll have dueling malloc()s (both newlib and
    ChibiOS will be fighting over the same heap storage).
    There should be little or no difference in behavior, except for the
    following things:
    - use the <stdio.h> and <stdlib.h> headers instead of chprintf.h
    - use printf(), malloc() and free() instead of chprintf(), chHeapAlloc()
    and chHeapFree()
    - You no longer need to use /r/n when doi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
    [app-chat.c, app-dialer.c, app-launcher.c, app-ledsign.c, app-music.c, app-update.c, app-video.c, badge.h]
2019-03-28 fix led brightness
2019-03-28 Increase the joypad thread stack size
    The new printf() path needs more stack space.
    Also fix a couple more warnings.
    [cmd-watchdog.c, is31fl_lld.c, joypad_lld.c]
2019-03-28 Fix possible crash with some versions of GCC
    The Nordic SDK defines NRF_SOC_EVTS as an enum. This describes the events
    that can be returned when making a SOC system call to the SoftDevice,
    particularly when performing a flash erase or write. Here's something
    you need to always remember: while most of the time people assume that
    enums will be represented by an int, the truth is that the C specification
    says that they're implementation-defined. The compiler could choose to
    represent them internally in any form that it wants.
    John builds the badge code with this version of the GNU ARM Embedded
    toolchain:
    GCC 6.3.1 20170215 (release) [ARM/embedded-6-branch revision 245512]
    When you build the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
    [ble_lld.c, ble_lld.h]
2019-03-30 Add initial support for custom UUID and badge services
    A new UUID has been generated and added so that we can advertise
    our own custom services. Right now there's just support for an unlocks
    characteristic and a password to enable it. You must supply the correct
    password after connecting via bluetooth in order to modify the unlocks
    value. Once changed, the value is saved to the user config in flash.
    Note: we must use an event handler to write out the change using the
    main thread. We can't do it in the SoftDevice event dispatch thread
    because we must respond to the peer device quickly when it sends a
    write request, and doing a flash erase and update takes too long to
    do it synchronously.
    An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
    [ble_gap_lld.c, ble_gattc_lld.c, ble_gattc_lld.h, ble_gatts_lld.c, ble_l2cap_lld.c, ble_lld.c, ble_lld.h, main.c]
2019-03-31 Add a submarine ping sound effect
    Orchard UI events (screen touch, button push) now play a submarine sonar
    ping effect. It remains to be seen if we stick with this or not.
    For other effects the click effect is retained. For things like the
    chat keypad, the sonar ping is too long and too annoying to hear on
    every keypush.
    [app-credits.c, app-email.c, joypad_lld.c, orchard-app.c]
2019-03-31 Continue work on GATTC client
    I'm still learning how all this works. Probing remote devices for their
    services and UUIDs is... messy. But I think I'm starting to get it.
    It's not done yet, but I want to stop here and see if John has anything
    to merge before I go further.
    I made one modification to the userconfig code: getConfig() will return
    a pointer to the flash userconfig region if it's used before the userconf
    module has been initialized. This is needed to be able to read the unlocks
    field of the userconfig from flash during the BLE startup.
2019-04-01 Remove leftover debug printf().
2019-04-01 Remove another debug printf().
2019-04-03 Un-do unintended font change in list UI widget
    I only wanted to change the font for testing, but it got checked in
    by mistake.
    [ui-list.c]
2019-04-03 Increase the I2S player buffer size
    Sometimes the sonar ping has artifacts in it when it plays at the same
    time the launcher icons are redrawing. This is due to trying to read the
    icons and music from the SD card at the same time. We can compensate for
    this by doing a little more buffering in the I2S player module.
2019-04-03 Fix a few nits
    LEDs were being initialized twice in main.c.
    Using a #define for time_t in datetime.h was causing a syntax error
    with GCC 8.2.
    With LTO turned off, the code would not build due to an undefined linker
    reference to breakTime(). This function isn't implemented yet. With LTO,
    the compiler/linker didn't actually emit a call to this function since
    it could not be called unless BLACK_BADGE is #defined, and it knew that.
    But without LTO, the compiler can't optimize out the reference. This
    needs to be cleaned up.
    [cmd-config.c, datetime.h, main.c]
2019-04-03 Fix typo in comment.
    [userconfig.c]
2019-04-03 Document P0.00 and P0.01 correctly.
    Those pins are for the 32.768KHz crystal, not the 32MHz one. The
    latter has dedicated pins which can't be used for GPIO.
    [board.c]
2019-04-04 Fix up LFCLK selection
    Technically this doesn't hurt anything since the SoftDevice is the only
    thing using anything that depends on this clock, and it initializes it
    once it's started. But the correct selection should be 1 (use external
    32.768KHz crystal).
    [board.h]
2019-04-07 Add NULL pointer protection
    Since we have the MPU and we're already using to provide stack protection,
    we may as well also use to to provide NULL pointer protection. The first
    1024 bytes of the address space (0x00000000 to 0x000003FF are now marked
    as read/write inhibited. Any code which tries to do a load or store to this
    region will trigger an immediate memory manager fault. As it is now,
    reading or writing to this region always succeeds (though writing has no
    effect since flash is read only), and this can mask bugs where code tries
    to read or write through a NULL pointer. I have a sneaking suspicion there
    may be such a bug somewhere in the uGFX code and I'm hoping this will
    help track it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
    [app-update.c, main.c, nullprot_lld.c, nullprot_lld.h]
2019-04-07 Avoid UI setup on broken preview silicon
    If we haven't initialized uGFX, we'll trigger a NULL pointer dereference
    in all of the orchard code when we try to access the uninitialized GDISP
    structure, so avoid launching the app thread.
    Also, don't try to dispatch any orchard events from the joypad thread
    either if the joypad event structure is uninitialized.
    [joypad_lld.c, main.c]
2019-04-08 Add a proper GATTC discovery function
    The radio discover command can now walk the service list of a BLE
    device. At least, I think it can. It works ok against another badge,
    but I can't find any other connectable devices near me right now that
    I can validate against.
2019-04-08 Boost the music app priority during playback
    When the music app runs, we should boots its thread priority temporarily so
    that it's higher than that of the SoftDevice event thread, otherwise there
    may be some brief audible gaps during playback.
2019-04-08 Fix GAP connection timeout handler
    We don't need to do a full GAP restart when a connection attempt times
    out. We just need to restart scanning.
    [ble_gap_lld.c]
2019-04-08 temporary commit with speaker footprint and removal of fuel gauge
    [DC27-DC Power.sch, DC27Audio.sch]
2019-04-10 add AST-01078 3d model and kicad footprint, check in current budget, update charging circut to MCP73833 instead of MCP73831:
    [DC27-DC Power.sch, DC27-badge.kicad_pcb, DC27-badge.sch, DC27Audio.sch, DC27LED_INTERFACE.sch, DC27LEDs.sch, file5C2B533B.sch, mechanicals.sch]
2019-04-11 Fix some race conditions.
    The newlib version of malloc requires locking, however by default the
    __malloc_lock() and __malloc_unlock() functions are empty. It's up to
    us to provide them, and previously I wasn't. This is bad, because since
    ChibiOS is multithreaded, the possibility exists that we could have
    malloc()s and/or free()s occuring in multiple threads simultaneously.
    These functions are now implemented in newlib_syscalls.c using a ChibiOS
    mutex to guard the heap.
    Also, I discovered what I'm pretty sure is a bug in uGFX. There is
    a Trigger_Redraw() macro which causes the gtimer thread to iterate over
    all of the Gwin windows and perform any pending updates for them. The
    The Gwin windows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
    [badge.h, chconf.h, main.c, newlib_syscall.c]
2019-04-12 add in the new buttons and joystick interrupts, make new schematic for joypads, update the pcb (not done)
    [DC27-DC Power.sch, DC27-badge.kicad_pcb, DC27-badge.sch, DC27Audio.sch, DC27LED_INTERFACE.sch, DC27LEDs.sch, DC27_Switches.sch, file5C2B533B.sch]
2019-04-13 Create new BSP for production badge
    The button arrangement for the production badge has changed, and I want
    to delete some things that won't be needed for the final design, so a new
    BSP has been created. The "badge" directory is for the final design. The
    current BSPs are being kept for hysterical raisins.
    [board.c, board.h]
2019-04-13 Add new BSP for the production badge design
    This "badge" BSP should represent the production board design. The
    differences from the badge_840 BSP are:
    - Remove the QSPI flash support
    - Remove all the atari emulator code
    - Update the joypad module to handle the two 5-input joypads
    This BSP should still run on the nRF52840 DK board and the rev 1
    prototype board, however due to the joypad changes, the buttons won't
    work.
    [app-chat.c, app-credits.c, app-dialer.c, app-email.c, app-launcher.c, app-ledsign.c, app-music.c, app-update.c]
2019-04-13 Add back ping sound effect for buttons
    Rather than play the ping event in the joypad thread, do it in the
    orchard event handler.
2019-04-14 No longer need to OR in 0x20 for IOPORT2 pins in the I2S driver.
    [i2s_lld.c]
2019-04-14 Fix stale info in comment.
    [main.c]
2019-04-14 Add first attempt at notify app
    Currently this app responds only when someone writes to the chat request
    handle in the GATTS service. So far I've only tested this using my phone.
    The chat app itself still needs to be updated to send the request.
    I also added the alert1 effect from the DC25 badge design. We can replace
    this with something else later. (Maybe a submarine alert kalxon?)
    [app-notify.c, orchard-app.c]
2019-04-15 Add backward compatibilty support for the rev 1 button design
    John wants to be able to still run the latest firmware with the
    rev 1 board. To do this with the least amount of fuss, we now
    have a compatibility joypad driver to support the old button
    design.
2019-04-16 Fix up some of the macros in the joypad compat module.
    Tested with dev kit board.
    [joypad_compat_lld.c]
2019-04-16 Remove local copies of string handling functions.
    The newlib versions of these routines seem to work just fine. Since we're
    no longer highly constrained in terms of flash usage, we don't need custom
    routines to save a few bytes. At least for me, the resulting image actually
    gets a few bytes smaller now anyway.
    [scanf.c, strtoq.c, strtouq.c]
2019-04-17 Fix mind-o in comment
    [mmc_spi_lld.c]
2019-04-17 Check in V2 of the board. 0 unconnected nets, joypads on pcb
    [DC27-DC Power.sch, DC27-badge.sch, DC27_Switches.sch]
2019-04-17 check in latest budget numbers, check in bombface graphics
    [DC27-badge.kicad_pcb, mechanicals.sch]
2019-04-17 move gerbers
    [DC27-badge-B.Cu.gbl, DC27-badge-B.Mask.gbs, DC27-badge-B.Paste.gbp, DC27-badge-B.SilkS.gbo, DC27-badge-F.Cu.gtl, DC27-badge-F.Mask.gts, DC27-badge-F.Paste.gtp, DC27-badge-F.SilkS.gto]
2019-04-19 Fix a bug in previous commit
    In the case where we can't find a peername and use the peer's MAC
    address, use the right index value to choose the peer buffer. This
    can happen if I try to issue a chat request from my phone, which
    doesn't support BLE (Caught by the NULL pointer trap.)
    [app-chat.c]
2019-04-19 Make a few fixes and updates
    - Only trigger the notify app if we're currently displaying the launcher.
    Doing it while other apps are running has side-effects because calling
    orchardAppRun() does not always cleanly shut down the currently running
    app.
    - Add klaxon sound effect. When somebody wants to chat, we play this effect
    and display the scary radioactive green "Under Attack" image.
    - We now send actual messages via the chat request attribute, namely
    request, accept and decline.
    - If the peer declines a chat request, the chat app playes the Wilhelm
    scream error effect and displays an approtiate message, then exits.
    [app-chat.c, app-notify.c, ble_lld.h, orchard-app.c, orchard-app.h]
2019-04-19 Remove some more dead code
    - Remove no-longer used m25q flash code
    - Remove flash example hidden under #ifdef flash_test
    - Remove one more check for broken nRF52840 engineering silicon
    (I don't care about testing on my preview DK board anymore,
    and the badge_840 BSP will still work there if I get desparate)
    [main.c]
2019-04-19 Add MCP78333/4 LiPo charge manager chip datasheet to the pile
2019-04-20 PROTOV2 OFF TO MACROFAB
    [DC27-DC Power.sch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]
2019-04-20 Check in kicad_pcb layout for protov2
    [DC27-badge.kicad_pcb]
2019-04-20 move c405 closer to the battery power circuit make a bunch of ground traces 0.254 instead of 0.152 sized to improve grounding
    [DC27-badge.kicad_pcb]
2019-04-20 clean up errant trace around AVCC power in add seabattle game images
    [DC27-badge.kicad_pcb]
2019-04-21 add 3d models for bmd-340 and display
    [DC27-badge.kicad_pcb]
2019-04-21 Turn off both SPI buses before starting a firmware update.
2019-04-21 Add a quick and dirty touch panel calibration app.
    This may transform into a setup app at some point.
2019-04-21 add 3d model for RGB LED
    [DC27-badge.kicad_pcb]
2019-04-21 add 3d model for joysticks
    [DC27-badge.kicad_pcb]
2019-04-21 Reduce debounce delay
    With the new sensing design, we probably don't need to have a debounce
    delay when we check each pin. Also, put the printf()s under some #ifdefs
    since they were meant for debugging only.
2019-04-21 Put error printf()s under #ifdefs
    [is31fl_lld.c]
2019-04-21 Turn off I2C and EXT before firmware update begins.
2019-04-22 Fix iPhone connections again
    Apparently requesting an upgrade to a coded PHY doesn't work with
    iPhones trying to establish connections.
    [ble_gap_lld.c, cmd-radio.c]
2019-04-23 add TX/RX silkscreen
    [DC27-badge.kicad_pcb]
2019-04-23 add SSM-120 connector (screen connector) to 3d model
    [DC27-badge.kicad_pcb]
2019-04-23 add 3d model for JST connector
    [DC27-badge.kicad_pcb]
2019-04-23 add micro usb connector 3d
    [DC27-badge.kicad_pcb]
2019-04-23 add caps in 3d
    [DC27-badge.kicad_pcb]
2019-04-23 check in caps and 4344 3d models
    [DC27-badge.kicad_pcb]
2019-04-26 get led brightness and pattern selection working
2019-04-26 push partially broken app setup for bill
    [app-setup.c, ides_gfx.c]
2019-04-26 add some more led patterns
2019-04-27 Fix tap-to-exit in the photo app
    [app-photos.c]
2019-04-27 Fix drawing of touch calibrator in setup app
    [app-setup.c]
2019-04-27 change fonts to futura, fix nophoto issue, move sounds to sound dir
    [app-calibrate.c, app-chat.c, app-credits.c, app-dialer.c, app-email.c, app-launcher.c, app-ledsign.c, app-music.c]
2019-04-27 fix app-video filename for playback
    [app-video.c]
2019-04-28 Add more game comms support
    - We no longer advertise UUIDs. Those can be learned through a separate
    discovery mechanism anyway.
    - We now device a ble_ides_game_state_t structure which we do advertise
    as a vendor-defined field, using our made-up company ID.
    - The ble_peer module now supports stashing the game state, for those
    peers which are found to support it
    - We now have separate GAP avertisement and scan response events
    - We also have a special event for the chat app to indicate when we've
    gotten both (to resolve the name)
    - The notify app now supports battle challenge requests
    - The app-name app has been ported over and now works -- you can set
    your badge name
    - The GATTS modu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
    [app-chat.c, app-name.c, app-notify.c, ble_gap_lld.c, ble_gap_lld.h, ble_gatts_lld.c, ble_gatts_lld.h, ble_lld.c]
2019-04-28 Some cleanups:
    - Put the printf()s in joypad_compat_lld.c under JOYPAD_VERBOSE
    - Avoid generating extra advertisement/scan response events for now.
    They can overwhelm the radio event queue
    - Also increase the size of the radio event queue
    - make sure the chat app ignores the extra advertisement/scan response
    event types
    I have a feeling we're going to need to cache many radio events for
    the game to work reliably.
    [app-chat.c, ble_gap_lld.c, joypad_compat_lld.c, orchard-app.c]
2019-04-28 Enable the ability to print floats in printf()
2019-04-28 Add support for reading pixels from the display.
    The ILI9341 driver now supports the gdisp_lld_read_start(),
    gdisp_lld_read_color() and gdisp_lld_read_stop() functions.
    The gdispGetPixelColor() function now works.
    This allows reading pixels from arbitrary locations in the screen.
    Hopefully this will improve animation in the game app.
    Also, since we can now read from the screen, we can now also detect if
    the screen is plugged in during the main() function.
2019-04-28 Use the getPixelBlock() routine in the battle app
    This allows us to undraw and redraw the screen, which allows the player
    to move anywhere on the map without losing the previous screen contents.
    Granted, the player isn't supposed to be able to sail over land, but
    at least now if they do the land is re-drawn correctly.
    [app-battle.c, ides_gfx.c]
2019-04-29 check in bill's changes to fix LEDs
    [app-battle.c, led.c]
2019-04-29 Add the ARM Cortex-M4 Generic User Guide to the datasheet pile
2019-04-30 add the kraftwerk led anim
    [DC27-badge.kicad_pcb]
2019-05-01 naieve collision detection - seems to work
    [app-battle.c]
2019-05-01 add sea battle ping every 4 seconds, fix 10x mistake on animation timing
    [app-battle.c]
2019-05-03 add bullets and fixup the crappy collision code
    [app-battle.c, battle.h, userconfig.c]
2019-05-03 fix bad OOB checking
    [app-battle.c]
2019-05-04 Add an FPU interrupt handler
    We sometimes trigger overflow/underflow events, which trigger a
    floating point interrupt. Technically it's safe to ignore these,
    but we really should at minimum ack and clear them. Also, info from the
    Nordic Q&A forum suggests that you can't really put the chip into
    low power mode while FP events are outstanding.
2019-05-05 Fix up FPU interrupt handling a little
    Internally the ChibiOS code saves the fpscr contents during its
    context switch code, so we should probably fix it up directly here
    as well as modifying the stack frame.
    Also, we can get the stack frame address directly with __get_PSP().
    [badge_vectors.c]
2019-05-05 Remove the touch calibrate app
    It's redundant now that the setup app is in place.
2019-05-05 One more tweak to the FPU interrupt handler
    The ChiniOS _port_irq_epilogue() code already does a read of the
    FPSCR register to force a context reload, so we don't need to do it
    here too.
2019-05-05 Okay, apparently that last change was a terrible idea. Revert it.
    Looks like we really do need to do a __get_FPSCR() on entry to the
    FPU handler.
    [badge_vectors.c]
2019-05-05 update screen width/height defines, fix map selection code when engaging in a battle
    [app-battle.c, images.h]
2019-05-05 remove sensitive info, fix some traces on pcb that are too close to the board edge and add notes about battery size to pcb
    [DC27-badge.kicad_pcb]
2019-05-05 move bullet creation into the game loop to avoid artifacts
    [app-battle.c]
2019-05-06 When setting the LEDs to off, also disable the LED thread. Restart the thread when the LEDs are on.
    app-name: change the text a bit
    orchard - fix click behavior (still not right)
    [app-launcher.c, app-name.c, app-setup.c, led.c, orchard-app.c]
2019-05-06 fix text on app-name
    [app-name.c]
2019-05-07 update bom tools
    [DC27-badge.kicad_pcb]
2019-05-08 set LEDs to game function when game starts, restore LEDs when game ends.
    add blink when player approaches.
    flush out enemy updating, render, and erase code
2019-05-08 fix memory leak in enemy list
    [app-battle.c]
2019-05-10 Add three new LED patterns - red sparkle, purple pulse, meteor, blue/green spin
2019-05-10 Make a few more updates
    - Enable support for the uGFX pixmap feature and the accelerated
    blitter function in the ILI9341 driver. These may prove useful
    later.
    - Fix the vendor-specific advertisements. We only want to send one
    of them.
    - Add support to the ble_peer module to display info for devices that
    we know are badges (game state)
    - Add a call in the battle app to update the X/Y coordinates advertised
    via BLE.
    [app-battle.c, ble_gap_lld.c, ble_peer.c, gfxconf.h]
2019-05-10 Fix warning about potential buffer overflow in enemy_engage()
    [app-battle.c]
2019-05-10 temp checkin, seeing some init issues in battle
    [app-badge.c, app-battle.c]
2019-05-11 Fix click sound for up/down arrow buttons in launcher app
    [app-launcher.c]
2019-05-12 Add some sample provisioning scripts
    These scripts should hopefully make it easier to flash all the badges
    once the production run is completed. The scripts halt, mass-erase and
    program then with a badge.elf image. They can also program some fields
    in the UICR, like the reset pin and and possibly the unlocks password.
    The main.c code that updates the reset pin configuration has been modified
    to preserve the UICR->CUSTOMER[] region since that's where we'll be putting
    our own configuration stuff.
2019-05-12 Restore click effect to the keyboard ui module
    Now that orchard-app doesn't automatically generate clicks for every
    uGFX event, the keyboard has stopped clicking. It needs to generate
    the effect itself now.
    [ui-keyboard.c]
2019-05-12 fix splash code to use null
    [splash.c]
2019-05-14 add char ranks, fix up badge screen ,fix brightness
    [app-badge.c, app-setup.c, userconfig.c, userconfig.h]
2019-05-14 Small cleanup in joypad drivers
    - We don't need to include the i2s_lld header anymore.
    - Minor documentation fix
    [joypad_compat_lld.c, joypad_lld.c]
2019-05-14 Fix the audio play command
    Let the user specify any audio filename to play. (No filtering on
    file names will be done. Files which are not audio will produce
    terrible noise. Caveat utilitor.)
    [cmd-audio.c]
2019-05-15 Try to add LED support to the firmware updater
    The production board design has no status LEDs for the SD cars,
    so we can't really see any progress indication when the firmware
    updater is running. We can't really write to the screen since
    we're too small to include graphics support. So to try and give
    the user some feedback, we now try to use the LED chain. We can
    light up all the LEDs red as an error indication, green for success,
    and use a single marching blue LED as a progress indicator. For
    the Nordic DK board, this code is basically a hardmless no-op
    since there I2C bus pins are not connected to anything.
    I'm crossing my fingers and hoping this works because John has
    the only board with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
    [halconf.h, led.c, led.h, mcuconf.h, updater.c]
2019-05-15 Stop the LED thread before we do a firmware update.
2019-05-15 Fix possible NULL pointer dereference in ledStop().
    On a DK board where we have no LEDs, the LED thread won't be started
    and pThread will be NULL. Test for this so we don't crash.
    [led.c]
2019-05-15 Handle interrupts properly in the updater
    Provide some sort-of working stubs for chThdSuspendS()/chThSuspendTimeoutS()
    and chThdResumeI(). We need to actually wait until an interrupt fires
    when doing I/O. Previously all we did was just return, which was fine
    for the timer interrupt, but not for anything else.
2019-05-15 Play 404, 404 on no SD card, clean up leak in app-test
    [main.c]
2019-05-15 Fix a bit of naming confusion
    At some point I mis-named the configuration structures for the
    general-purpose timers (GPTs) that we're using. ChibiOS calls them
    GPTD2 and GPTD3, but I had named the configuration structures
    gpt1_config and gpt2_config instead of gpt2_config and gpt3_config.
    This offended my delicate OCD sensibilities, and it was starting to
    confuse even me a little bit, so I'm straightening it out. (There
    should be no functional changes.)
    [main.c, updater.c]
2019-05-15 Add a couple extra assember directives for consistency.
2019-05-16 Make a couple more updater fixes
    Now that the updater handles I/O interrupts better, it seems we can
    use the mmi_spi_lld.c driver using the normal interrupt-driven
    SPI driver API without needing to use the synchronous direct
    manipulation we had before. This means we can simplify the driver:
    the code doesn't need the UPDATER ifdefs anymore.
    Also, the LED code has been modified a little:
    - There are now some separate functions to write to LED controller
    registers and set the register page
    - The init routine now sets the global current control (GCC) register
    to max to override whatever value might have been left behind when
    the badge firmware was running. (If it left the GCC setting at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
    [led.c, led.h, mmc_spi_lld.c, updater.c]
2019-05-16 Fix the joypad tester a little
    We don't need to redraw the circle outlines every time there's a button
    event. This slows the app down and makes it sluggish to respond sometimes.
    Just draw the circle outlines once, at startup, then just draw the
    white/green dots when there's joypad events. It's much more responsive
    this way.
2019-05-17 Fix formatting a little
    [app-video.c, main.c]
2019-05-17 Fix a memory leak in the launcher app introduced in last commit
    For reasons I can't explain, the following two lines disappeared from
    launcher_exit():
    free (context->priv);
    context->priv = NULL;
    This meant we leaked 260 bytes every time we exited the launcher.
    The only other changes were some formatting alterations. These changes
    have all been reverted.
    Also, while we're at it, use snprintf() rather than chsnprintf().
    [app-launcher.c]
2019-05-18 Re-enable the code that saves the LED sign string in flash
    I had this code disabled originally because when I first ported
    the LED sign app from the old badge, the userconfig code wasn't
    in place yet. But it is now, so we can turn this back on.
2019-05-20 Make some updater fixes
    - Fix the colors for the success and error routines -- I had
    them backwards (error was green and success was red)
    - Initialize the second GPIO bank
    - Increase UPDATER_SIZE because the updater may be bigger
    than 7168 bytes when the latest changes
    [led.c, updater.c, updater.h]
2019-05-20 Fix a few formatting nits, update copyright years
    [flash.c, flash.h, updater.c, updater.h]
2019-05-21 Add Microchip app note to the pile
    This document has a reference power path design
2019-05-21 add test points for DAC
    [DC27Audio.sch]
2019-05-22 Fix joypad pin mappings
    [board.c, board.h]
2019-05-22 Fix button mapping correctly this time
    [board.c, board.h]
2019-05-22 Fix joypad compat to handle remapped pins
    [joypad_compat_lld.c]
2019-05-22 Rememebr to initialize state at start up
    We need to clear out the test state variables, otherwise
    the second time we run the joytest app it thinks all of
    the buttons have already been pushed.
2019-05-22 check in charging circuit changes
    [DC27-DC Power.sch, DC27-badge.kicad_pcb, DC27Audio.sch]
2019-05-22 Fix credits issues
    The new credits file that John checked in was not rotated and flopped,
    so it wouldn't display correctly.
    Also, fix a small bug in the scroll code: if we bail due to the scroll
    image file being unacceptable, remember to detach ourselves from the
    mouse event queue before exiting.
    [scroll_lld.c]
2019-05-22 Add more datasheets to the pile
    - On Semi FDN360P FET
    - AVX Schottky diodes
2019-05-22 add test points for the DAC. Add new context secret codes
    [DC27-DC Power.sch, DC27-badge.kicad_pcb, DC27Audio.sch]
2019-05-23 Improve LED support in the updater
    It seems that if you touch the exposed shitty add-on connector pads,
    you can cause the I2C controller to lose communication with the LED
    control chip. I'm still not sure how to recover correctly when this
    happens. But I don't want the firmware updater to stall if someone
    touches the pads while we're in the middle of flashing a new image
    (since that will brick it, unless they have a JTAG probe). To mitigate
    this, we now implement a dummy chThdSuspendTimeoutS() function that
    actually times out after a while instead of always blocking forever,
    and we now call the I2C TX function with a timeout instead of always
    using TIME_INFINITE. This way if the LEDs get stu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
    [led.c, sched.c]
2019-05-23 Use macros instead of direct inline assembly
2019-05-24 Fix skeleton chThdSuspendTimeoutS() function
    We were not correctly detecting a timeout condition correctly.
    We should check the "blocked" variable after we exit the for() loop
    and see if it's been cleared. If it wasn't, then no interrupt occured.
    [sched.c]
2019-05-24 Recover the LEDs when the I2C bus glitches
    If you touch the expose shitty add-on pads, you can glitch the I2C bus,
    which causes the LEDs to freeze. We can detect when this happens if
    the I2C transfer returns anything other than MSG_OK. (It will return
    MSG_TIMEOUT when a transfer fails.) If this happens, we need to reset
    the I2C controller and unjam the bus, then send some data through to
    re-sync comms with the LED controller chip.
    If someone keeps their fingers on the pads, it will keep glitch the
    bus indefinitely and the LED updates will never go through, however
    this won't block the flashing process entirely, so while the LEDs
    won't flash, the update will still complete and the badge won'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
    [led.c]
2019-05-24 Fix LED stalls
    It turns out that to properly reset the I2C bus, you have to power-cycle
    it using a magic, undocumented register at offset 0xFFC. To handle
    LED stalls correctly every time, we have to disable the I2C controller,
    power-cycle it, and then turn it back on again. We also have to make
    sure not to use TIME_INFINITE when doing an I2C transaction (if there's
    an error, we stall forever).
    [is31fl_lld.c, is31fl_lld.h, led.c]
2019-05-24 Clean up reset routine a little
    [led.c]
2019-05-25 Do some more LED stabilty fixups
    - Make the init routine in the is31fl driver perform a chip reset to
    set the chip state back power-up defaults
    - Disable the "lazy init" stuff. It's not helping.
    - Make the led recovery mechanism call the is31fl routine to reinitialize
    the chip after a glitch
    - Fix a possible NULL pointer bug in the I2C driver. If we happen to
    get an RX ready interrupt and the RX buffer pointer is NULL, we
    could crash. (Only caught this once, but might as well add a test
    to trap it.)
    In some cases it may take a few seconds for the LEDs to restart after
    a glitch, but as far as I can tell, they always do.
    Sometimes it can take a few seconds for the LEDs to recover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
    [is31fl_lld.c, is31fl_lld.h, led.c]
2019-05-26 move config reset to both selects held down, add meteor_red led pattern, fix the unlock screen
    [DC27-DC Power.sch]
2019-05-26 Add Microchip battery charger app note to the datasheet pile
2019-05-26 Fix keypad B down button in launcher
    I forgot to the code to handle that button (and I wasn't able to
    properly test it before with the DK board).
    [app-launcher.c]
2019-05-26 Reload LED brightness from flash config on restart
2019-05-26 Fix notification alert trigger
    We want notifications to fire either when we're on the launcher or
    the home screen.
    [orchard-app.c]
2019-05-26 Fix a potential crash in the chat app
    We might get a button event after we've destroyed the UI. At that
    point, the UI pointer is NULL. The NULL pointer guard triggers on
    this.
    [app-chat.c]
2019-05-26 Fix crash in battle app
    We don't want to unregister uGFX touch events in battle_exit() if we
    haven't actually registered them yet. This may change later, but for
    now this code should be commented out.
    [app-battle.c]
2019-05-27 Fix issues in notify app
    Fix the pathname for the "under attack" graphic.
    Fix the name of the game app.
    [app-notify.c]
2019-05-27 Implement airplane mode and sound on/off features in setup
    Getting airplane more to work is tricky. To do it right, we have to
    disable the radio. But when we disable the radio, we lose access to
    the flash and the random number generator which are accessed via the
    SoftDevice.
    I finally bit the bullet and made the flash driver and random support
    use either direct hardware access or the SoftDevice on the fly. You can
    use sd_softdevice_is_enabled() to check if it's turned on, and if so
    we use the SD APIs, otherwise we talk to the hardware directly.
2019-05-27 Increase the timeout before we draw the calibration screen
    Sometimes we still end up with the "Touch Cal" button still on the screen
    when we enter the touch calibration routine.
2019-05-27 Unbreak factory reset
    I inadvertently broke this when I rearrange the start-up path when
    I added airplane mode support.
    Also, the path for the audio playback when a factory reset occurs
    was wrong. There is no game/ping.snd file. There is a game/map_ping.snd
    though. I'm assuming this is what was intended.
    Also we need to pause for the reset sound effect to finish, otherwise it
    gets garbled during radio startup. We may want to use a shorted tone
    for this later.
    [main.c, userconfig.c]
2019-05-27 Fix some sound paths
    The unlocks app expects to use the Mortal Kombat "Pathetic" sound clip
    to indicate failure, but we don't have that this time around. Replace it
    with the Wilhelm scream until John decides on something better.
    Also, for the factory recent, use the sonar ping instead of the game
    map ping.
    [app-unlock.c, userconfig.c]
2019-05-28 Add the Microchip MCP73831 battery charger chip datasheet to the pile
2019-05-28 forgot to check in and add bomb-face to the mechanicals schematic and pcb
    [DC27-badge.kicad_pcb, mechanicals.sch]
2019-05-28 add final gerbers for MF. Please let this work, please.
    [DC27-DC Power.sch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]
2019-05-28 update schematic and re-check in gerbers
    [DC27-DC Power.sch, DC27-badge.kicad_pcb, DC27LED_INTERFACE.sch, mechanicals.sch]
2019-05-28 update gerbers for R302 issue
    [DC27-badge-B_Cu.gbl, DC27-badge-B_Mask.gbs, DC27-badge-B_Paste.gbp, DC27-badge-B_SilkS.gbo, DC27-badge-Edge_Cuts.gm1, DC27-badge-F_Cu.gtl, DC27-badge-F_Mask.gts, DC27-badge-F_Paste.gtp]
2019-05-28 update remaining files
    [DC27-badge-Edge_Cuts.gm1]
2019-05-28 Fix R604 and other dumb 0603/0805 mistakes
    [DC27-badge-B_Cu.gbl, DC27-badge-B_Mask.gbs, DC27-badge-B_Paste.gbp, DC27-badge-B_SilkS.gbo, DC27-badge-F_Cu.gtl, DC27-badge-F_Mask.gts, DC27-badge-F_Paste.gtp, DC27-badge-F_SilkS.gto]
2019-05-29 no really, final bom
    [bom-dc27-limited.tsv, bom-merged.xlsx, bom-simplified.xlsx, bom.csv, bom.tsv]
2019-05-31 Add first attempt at a programming tool for the CP2102N
    I finally figured out how to change the internal configuration of the
    CP2102N. For right now, this program only resets the vendor and
    product string to "Team Ides" and "DC27 Ides of DEF CON" respectively.
    I still need to figure out how to make it change the GPIO pin setup.
    I also need to make it more flexible so that it can do things like
    dump the internal memory.
    Unfortunately, while there are several chips in the CP210x product
    line, they don't follow a consistent strategy for reading and writing
    the internal configuration. The CP2102 and CP2102N use completely
    different methods. The good news is that it's not actually possible
    to lo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
2019-05-31 Add SiLabs CP210x USB-to-UART API spec to datasheet pile
    This document contains the full description of the configuration
    structure needed to set up the CP2102N chip. We use this to customize
    the vendor/product/serial# strings and GPIO configuration.
2019-05-31 Fix appearance code
    From what I can tell, we should be using 0xDC27, not 0xDC1B, as our
    appearance in order to be recognized as a DC27 badge per the badgelife
    spec.
    [ble_lld.h]
2019-06-01 Add support for setting LEDs and USB max power
2019-06-01 Fix data size reporting for L2CAP
    When an L2CAP packet is receiced, the sdu_len indicates the actual size
    of the received data, The other length value is just the overall size
    of the buffer (is basically the L2CAP MTU).
    [ble_l2cap_lld.c]
2019-06-01 Allow all command-line flags to be used at once
    Except for dumping and loading whole configs, you can combine any of
    the command line switches at the same time, to set all parameters at
    once.
2019-06-02 fix the app timer on app-setup
    [app-setup.c]
2019-06-02 make sure we reset the idle ui timer on app-setup
    [app-setup.c]
2019-06-02 make the eye breathe independent of the rest of the led animations.
    make taps on buttons in the setup UI reset the idle timer.
    [app-setup.c, led.c, led.h]
2019-06-02 add gamma options to led.c, try again to fix idle timeouts in app-setup
    [app-setup.c, led.c]
2019-06-02 stop the double sweep animation from interferring with the eye animation
    [led.c]
2019-06-03 Add the ability to rotate the LED sign app
    Since the badge will hang by its fins, we should let the LED sign
    app display vertically as well as horizontally. If the "rotate badge"
    option is selected in the setup screen, we'll display vertically.
    - Added portrait version of LED font to go with landscape version
    - Added original TTF font file to the artwork directory
    - Added the programs I used to convert the TTF font into images
    (these just run the ImageMagick convert(1) utility)
2019-06-03 fix idle timer
2019-06-03 Clear test pixels
    After we do screen detection, reset the test pixels to black so
    that they're not as obvious to the user.
    [main.c]
2019-06-03 turn off leds if user decides to watch video
2019-06-03 Add rules to create rotated LED font on SD card
2019-06-03 check in BOM files
    [bom-dc27-limited.tsv, bom-merged.xlsx, bom-simplified.xlsx, bom.csv, bom.tsv, final.tsv, final.xlsx, mfbom.tsv]
2019-06-04 Fix cut&paste error
    The game attack characteristic setup was using the ble_chatreq variable
    instead of ble_gameattack.
    [ble_gatts_lld.c]
2019-06-04 Revert change to this file
    I need to debug this further. I want to stop scanning after a connection
    is established because that yields much better throughput during the OTA
    process, I can't seem to get advertising/scanning to start back up
    again. I'm too tired to figure it out now, and I don't want to break
    anything else, so let's restore the previous behavior for now.
    [ble_gap_lld.c]
2019-06-04 Switch over the battle code to using an actual game state machine like we did for DC25. Makes things a lot easier to program.
2019-06-06 add random led switching function, every 15 seconds
2019-06-07 DFM: LED test was not running when no sd card in
2019-06-07 fix led test, fix app-battle a bit
    [app-battle.c, led.h, main.c]
2019-06-07 hide the unlock app and fix an edge case in launcher
    [app-launcher.c, app-unlock.c]
2019-06-08 Fix a small I2C stability issue
    When compiled without LTO, sometimes reads will return success even
    if there's no device present on the I2C bus (such as with a Nordic
    DK board with no LEDs). It looks like we need to force a few write
    drains to the I2C registers in the interrupt handler to make sure
    the driver and hardware stay in sync.
2019-06-08 Abort ledSetPattern() when no LED support is present
2019-06-08 Update the OTA utility a little
    Checksum the data as it's being sent so that the other end doesn't
    try flashing a bogus firmware file.
    Save the received file to OTA.BIN on the SD card instead of overwriting
    the BADGE.BIN file directly. If the OTA.BIN file checksums correctly,
    then we can replace BADGE.BIN with OTA.BIN.
    Display a background image when sending or receiving an update.
    [app-otarecv.c, app-otasend.c]
2019-06-08 Fix keyASelect handling in launcher
    For some reason this button wasn't being sensed in the launcher.
    [app-launcher.c]
2019-06-08 Add missing checksum files
    [crc32.c]
2019-06-08 Fix initial game position advertising
    After we boot, we haven't launched the game yet, so we need to manually
    change the current game state in main().
    [main.c]
2019-06-08 Avoid overwriting names with "<none>" all the time.
    [ble_peer.c]
2019-06-09 Add 1950s NY Civil Defense drill video
2019-06-09 Fix bug in the peer code
    The size of ble_peer_addr in the peer structure is 6 bytes, but
    sizeof (ble_peer_addr) is 7 bytes. This caused a buffer overrun
    of 1 byte.
    [ble_peer.c]
2019-06-09 Change the location of the remote authentication password
    Instead of the temporary hardcoded string, we now use a string
    stored in the user info area, which can be set using the provisioning
    script when all the badges are prepared. This avoids having the
    password stored in the source tree.
    Of course anybody with access to the source could always just
    build a custom firmware image without the password check...
    [ble_lld.h]
2019-06-09 Init the userconfig as early as possible
    Now that the flash driver can do native or SoftDevice updates on the
    fly, we can do the user configuration as soon as the flash subsystem
    is initialized. This is needed to make sure the random LED selection
    takes effect immediately after initial provisioning.
2019-06-10 fix a long standing bug in idle timeout on the setup app, replace sparkle with police led
    [app-setup.c, app-unlock.c, led.c]
2019-06-10 All this time I thought the setup time issue was a timing issue. It wasn't. It was a double-tap of the B button that exited the setup.
    Problem solved, you can't exit setup with Bselect anymore.
    [app-setup.c]
2019-06-10 fix startup order so factory reset tone still works
    [main.c, userconfig.c]
2019-06-11 Make the music app twiddle the LEDs.
    The LEDs now act as an amplitude indication during music playback.
2019-06-11 Correct LED offset selection
    [app-music.c]
2019-06-11 replace the ugly-ass sparkle code with 'spot da fed' from dc25
    [led.c]
2019-06-11 give a few more px to app-launcher so ble address displays correctly
    [app-launcher.c]
2019-06-12 update schematic and pcb with proper audio cap polarity
    [DC27-badge.kicad_pcb, DC27Audio.sch]
2019-06-12 minor adjustment to c508 label
    [DC27-badge.kicad_pcb]
2019-06-12 Protect the gamma correction table with #ifdef USE_GAMMA/#endif
    [led.c]
2019-06-13 fix url in credits, add ships.c/ships.h
    [ships.c, ships.h]
2019-06-13 check in fixed unlock code
    [app-unlock.c]
2019-06-13 fix bad pointer math
    [app-unlock.c]
2019-06-13 fix off by 1 error in unlock code make led respond during credits showing
    [app-credits.c, app-unlock.c]
2019-06-13 clear leds before showing unlock
2019-06-13 add led effects to unlock
2019-06-13 make unlocked leds pulsate
2019-06-13 Change the way we make icon backgrounds transparent
    ImageMagick 7 seems to have a bug in it that breaks the conversion
    command that I tried to use to make icon backgrounds transparent.
    A couple of scripts that use an alternate, simpler approach have been
    added which should work with both ImageMagick 6.9 and 7.
    A script has also been added to just make backgrounds black. This
    should allow us to still use the .rgb images for icons while still
    having them appear non-square against the black background in the
    launcher. The advantage to this is that while using transparent
    .gifs works, the native .rgb images can be loaded faster.
2019-06-14 Avoid busy-waiting in asyncIoWait()
    [async_io_lld.c]
2019-06-14 Switch to using advanced kernel mode
    I noticed that the music player stutters when it has the LED bargraph
    and spectrograph going at the same time and the radio is on. (This is
    only noticeable when playing fixed tones, but it's there.) Using
    advanced kernel mode scheduling seems to dramatically improve this
    (probably because in some cases it prevents interrupts from being
    completely masked off in some places, in favor of adjusting the
    CPU priority instead).
    This should not have any effect on stability. I've tested this before
    and it worked fine, but I decided to stick with compact kernel mode
    just for simplicity's sake.
    Also, I forgot to set the priority for the random number generator
    blo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
    [chconf.h, mcuconf.h]
2019-06-14 Convert the nuclear attack video into an audio file.
    The attack.mp4 video is a recording of a 1961 nuclear attack warning
    (which, thankfully, never had to be used). It was intended to be played
    on the CONELRAD network. The video part is just a still image of the
    CONELRAD logo. This video takes up over 130MB on the SD card when
    encoded for playback on the badge, but only 11MB in audio form. I
    think it makes more sense to have it as an audio file. Also it does a
    good job of exercising the LED bargraph on the music player.
2019-06-14 LED bargraph was off by one
2019-06-14 Make sure unlock logic is correct
    [app-launcher.c]
2019-06-14 Fix missing unlock code provisioning
    The code for offset 0x100010e8 was skipped by mistake. Add slot for it.
2019-06-14 Fix build error
    The update_desc[] array needs to be exported so that the radio
    unlock app can see it. Also add the black badge description.
    [app-unlock.c]
2019-06-15 32 bytes is a little too small for the peer thread stack.
    Make it 128 instead, just for paranoia's sake.
    [ble_peer.c]
2019-06-15 Remove the reconnection workaround from the disconnect event
    Apparently the real cause of the reconnection issue I noticed last week
    had to do with the advertisement and scanning interval values being
    poorly chosen. I set more sensible values, and things work now without
    the ugly hack, so we can take it out.
    [ble_gap_lld.c]
2019-06-15 Add a small delay immediately after connecting
    Sending a GATTC write immediately after a connect event doesn't
    always work reliably. A 100ms delay seems to help.
    [app-radiounlock.c]
2019-06-15 Add a short delay here too
    [app-otasend.c]
2019-06-15 Implement a _read() syscall for newlib
    This just reads a single character from the serial port.
    Note: this really only works well from commands invoked from the shell.
    If used in another thread while the shell thread is still running, both
    threads will compete for input, alternately reading characters from
    the serial port.
2019-06-15 Fix photo app click on exit
    [app-photos.c]
2019-06-16 Add the jzip Z-Machine to the master branch
    You can now run Zork from the shell using the xyzzy command. This is
    based on the JZip Z-Machine written by John Holder, which can be found
    at: http://jzip.sourceforge.net/
    This was later ported to the Arduino by DanTheGeek as the A2Z Machine,
    which can be found here: https://github.com/ZContent/A2Z_Machine
    Much of the code has been reverted back to its original JZip 2.1 form.
    The acursesio.c module has been de-C++-ified and dead code removed.
    (There were a lot of unused functions.)
    To support this in the easiest way possible, the newlib-syscalls module
    now supports open/close/read/write/lseek on FatFs files, along with
    reading/writing from/to t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
    [cmd-xyzzy.c, main.c, memory.c, newlib_syscall.c]
2019-06-16 Fix small extra memory usage
    Avoid letting the newlib stdio code hold on to an extra 1024 bytes
    for the stdin file pointer.
    [cmd-xyzzy.c]
2019-06-16 Tweak RNG driver a little
    While trying to get the Z-Machine to work, I found that sometimes
    the hardware RNG driver would get stuck waiting for an event that
    never comes. I don't think we need to do __WFE() twice.
2019-06-16 Add _stat and _fstat syscall handlers
    Also, fix error handling for open/close/read/write.
    [newlib_syscall.c]
2019-06-16 Fix the handling of O_CREAT in _open()
    FatFs wants FA_CREATE_ALWAYS in order for this to work right.
    [newlib_syscall.c]
2019-06-16 Add private chconf.h file for the updater
    The updater doesn't work with advanced kernel mode configuration
    turned on. We need compact mode.
    [chconf.h]
2019-06-17 fix missing unlock code
    [unlocks.h]
2019-06-17 Fix init order so that SD fail cycles the LEDs again
    We have to enable the LEDs before trying to mount the SD card
    so that we can flash them if mounting fails.
    [main.c]
2019-06-17 fix up the game menu for xyzzy
    [app-battle.c, cmd-xyzzy.c]
2019-06-17 clean up led menu; make led unlocks work
2019-06-17 fix led help menu
    [cmd-config.c]
2019-06-17 fix off by one error on led config
    [cmd-config.c]
2019-06-17 make sure config led properly handles shutdown and startup of the led thread
2019-06-17 Fix filename collision
    I failed to notice there was already an unlock.tif image that
    goes with the app-unlock.c app. This gets overwritten by the
    unlock.jpg image during SD card creation (both get converted to
    unlock.rgb).
    To fix the conflict, the remote radio unlock app now uses
    runlock.jpg/rgb instead.
    [app-radiounlock.c]
2019-06-17 fix color rgb calculation
    [cmd-config.c]
2019-06-18 make led eye color configurable, make eye breathe
2019-06-19 Rework the ChibiOS nRF52 RNG driver
    The existing RNG implementation spins waiting for a random byte to
    be available. This causes problems when, for example, you set the
    LED config to a mode that uses random numbers, disable the radio (which
    will use the ChibiOS RNG instead of the SoftDevice) and then run the
    bitcoin app which plays a video. It stutters like crazy.
    The RNG module has an interrupt which signals when a byte is ready.
    We can put the calling thread to sleep and wake up when the interrupt
    fires instead of just busy-looping. This makes much more efficient
    use of the CPU and avoids the stuttering problem during video playback.
    [ble_lld.c, cmd-config.c, cmd-random.c, halconf_community.h, main.c, rand.c]
2019-06-19 Write a couple of quick scripts to pull the xyrs file and bom directly from Macrofab's API. Stash that away incase we need to make more boards.
    [final.tsv, final.xlsx]
2019-06-20 very minor label cleanups and crystal cleanup, should we make boards again.
    [DC27-badge.kicad_pcb]
2019-06-20 Add error handling to _sbrk()
    Don't allow _sbrk() to try to allocate memory past the end of the
    heap.
    [newlib_syscall.c]
2019-06-20 Bunch of stuff here.
    Update the maps with egan's maps. Update the "Safe starting" point list.
    Fix my dual program script to do the right thing
    Make app name, app battle, and ble track in-combat state. There's a case
    where you might not have a name set yet, and you're advertising BLE, and
    we don't want you to end up on the enemy peer list, so make sure that
    doesn't happen.
    [app-battle.c, app-name.c, app-notify.c, battle.h, ble_gap_lld.c, ble_gap_lld.h, ble_lld.h, ble_peer.c]
2019-06-20 fix starting points from colliding with land
    [userconfig.c]
2019-06-20 Begin work on the game accept and approval states to start the battle.
    Fix a memory leak in the battle app (we weren't free'ing the enemy
    peer list)
    Remove some bad points from the inital player position map
    [app-battle.c, battle.h, ble_gap_lld.c, gamestate.h, userconfig.c]
2019-06-20 fix the note about 80x24 terminals
    [cmd-xyzzy.c]
2019-06-22 Add support for the nRF52 temperature sensor
    The tempGet() API can be used to get the current CPU die temperature.
    Support is provided for using either the softdevice or directly
    using the hardware, depending on the current system state.
2019-06-22 Fix a small bug in the RNG driver
    We should use osalSysLockFromISR()/osalSysUnlockFromISR() in the
    interrupt handler, not osalSysLock()/osalSysUnlock(). (Doesn't
    really make much difference in practice, but we should follow the
    rules.)
2019-06-22 add the current nrf temperature to the badge screen
2019-06-22 make the temperature refresh interval a #define
2019-06-23 Reduce temperature redraws
    Only redraw the temperature on the home screen if the temperature
    actually changes.
2019-06-23 fix width for temp display
    [app-badge.c]
2019-06-25 Rename i2s driver
    Change the file names from i2s_lld to nrf52i2s_lld for consistency
    with other drivers in the BSP.
2019-06-25 Revert accidental change to cmd-radio.c
    [cmd-radio.c]
2019-06-25 Add a first attempt at a radio spectrum display app
    This app uses a custom driver to directly access the NRF52 radio.
    When it's running, the softdevice is disabled. It scans by sweeping
    the radio across the 2400MHz to 2499MHz channels and taking an RSSI
    reading at each point. It's not terribly flashy due to the limited
    number of channels, but it's nominally functional.
2019-06-25 Add missing change to mcuconf.h file
    [mcuconf.h]
2019-06-25 Update the radio driver and spectrum display a little bit
    The nrf52 radio actually supports two channel sets: 2400-2499 and 2360-2460.
    This means we can actually scan from 2360 to 2499 in total.
2019-06-25 remove a speaker file we dont use, attempt to write a battery voltage check.
2019-06-26 add place holder for the unlock pin..
2019-06-28 Fix some issues with the "puzwatch" app
    Spawning a separate thread just to monitor a GPIO pin is wasteful. Now
    that we've adopted the diode logic trick for buttons, we're only using
    one of the 8 available GPIOTE channels for button interrupts. That means
    there's 7 available. We can use one more to monitor the SAO GPIO2
    pin to trigger the puzwatch app. This means we'll get an interrupt on
    the falling edge when the pin is pulled down, and the orchard app thread
    can then launch the puzwatch app. We don't need to waste CPU cycles polling
    the pin every few milliseconds. (It's bad enough we have to do that for
    the touch panel.)
    I've tested this with my nRF52840 DK board and it seems to work fine.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
    [app-puzwatch.c, board.c, joypad_lld.c, joypad_lld.h, orchard-app.c]
2019-06-28 Fix another memory leak
    The app-spa-pin.c app is based on the same code as the puzwatch app, and
    has the same memory leak: the ghPin label widget was not being destroyed.
    This has been fixed.
    [app-spa-pin.c]
2019-06-28 add geiger counter sounds for bill, scene missing screen, and unlockpartymode
    [app-unlock.c]
2019-06-29 Switch the pix buff over from dynamic to static so that we can switch between the world map and the local map, fix memory leaks
    [app-battle.c, battle.h, ides_gfx.c, ides_gfx.h]
2019-06-30 cutover to the sprite system in app-battle. no collisions yet but getting there
    [app-battle.c, battle.h, ides_sprite.c, ides_sprite.h, main.c]
2019-06-30 Fix channel selection in the geiger counter app
    I botched the frequency for channel 38 (it's not 2496MHz, it's 2426MHz).
    Use the channel map from the radio module to avoid the confusion.
    [app-geiger.c, main.c, nrf52radio_lld.c, nrf52radio_lld.h]
2019-06-30 Use the LED array in the geiger app
    We attempt to measure the intensity of received advertisements
    by seeing how fast the arrive, using a hardware timer, and jigger
    the LED array to display it.
2019-07-01 Allow button/key clicks to play.
2019-07-02 Make the ledDraw() function a led library routine
    Both the geiger counter and music player app use it, so why not
    make it common code.
2019-07-02 Make a few game updates
    Devon sent me his latest iteration of his sprite code. It implements
    support for cacheing the game screen map background, which app-battle doesn't
    use yet, but which it could later.
    Fixed a bug in isp_check_sprites_collision(): the second call to
    make_bounding_rect() was using the wrong background buffer pointer
    (typo: instead of id2/id1, it should have been id2/id2)
    Also, make the game reflect enemy movements on the world map. We
    weren't changing the sprite state for old enemy discoveries. (This
    seems a little slow... need to talk to John if this needs to be
    fixed.)
    [app-battle.c, ides_sprite.c, ides_sprite.h]
2019-07-03 Add support for the text word wrap feature in uGFX
    This requires increasing the gtimer thread's stack space.
2019-07-03 drop a debugging printf..
2019-07-03 Fix a bug with the updater
    I added code to disable the SPI buses before launching the updater
    program. I think in some cases, with compiler optimization, the
    SPI bus may be disabled before we're really finished reading from it.
    Inserting an instruction barrier between the f_close() and spiStop()
    calls should prevent this from happening (either due to compiler
    re-ordering or CPU re-ordering of operations).
    [app-update.c]
2019-07-03 Fix performance issue in music player
    Moving the ledDraw() routine to led.c actually hurts performance
    for the music player. We're pushing the envelope with regards to
    how many spare cycles we have between playing audio samples. Drawing
    the spectragraph and updating the LED array takes a fair amount of
    math and work. With ledDraw() in the music app proper, the compiler
    seems able to optimize things so that music plays smoothly. But with
    ledDraw() in led.c, we get warbly audio. So for now, we give the
    music app its own privatec copy of this function again since we
    want music playback to be smooth.
    [app-music.c]
2019-07-03 fix icon for app-geiger
    [app-geiger.c]
2019-07-04 add octin-stencil font for some of the game screens.
    add vs/loadout state.
    add level up state (copied over from dc25)
    this won't build yet, I'll fix build in about an hour.
    [gamestate.h, userfonts.h]
2019-07-05 Add support for temporarily avoiding CPU sleep mode
    We use __WFI() in the idle thread to put the CPU to sleep during idle
    periods, which saves power. However there's some latency involved in
    waking up again. With the music player and bitcoin apps, I sometimes
    noticed some warbling which I thought was due to not having enough
    spare CPU cycles to handle all the I/O. It looks like the real issue
    is that when we put the CPU to sleep, it takes a small amount of time
    for it to wake up again, and we just don't have that time to spare here.
    The wake-up latency seems to cause us to miss our deadline for getting
    new audio samples into the I2S controller, which is where the warble
    comes from.
    I discov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
    [app-music.c, badge.h, badge_vectors.c, chconf.h, main.c, video_lld.c]
2019-07-05 Get rid of references to chprintf()
    Use printf() instead.
2019-07-06 change boot screen color to red from cyan to match the PCBs
    In the battle screen, show the first six unlocked ships as user
    advances on the level screen.
2019-07-07 Add network game packet protocol structures
    These structures have a common header and some context-specific
    extra fields. Note that since we want to use the entity type as
    a field in the packet header, the entity_type is now a uint16_t
    rather than an enum. (The internal representation of enums in C
    is Implementation Defined (tm), which is a bad thing when defining
    an over-the-wire protocol.)
2019-07-07 Enable the internal pullups and pulldowns in the LED control chip
    We don't have our own external pullups on the LEDs in the LED array, so we
    really need to use the internal CSx and SWy pullups. If we don't, then we
    sometimes see "ghosting" where a LED may light up partway.
2019-07-08 Add handshaking game state, which happens just after our l2cap connection.
    Fix math on land collisions and make land collision work again in
    WORLD_MAP.
    Fix interaction between app-notify and app-battle so that
    the battle app gets current_enemy data on start. Fix this so it
    works if we start in sea battle or outside of it.
    [app-battle.c, gamestate.h, ides_gfx.c, ides_sprite.c, ides_sprite.h]
2019-07-09 Remember to turn off the audio amp in geiger counter app
    The geiger event thread turns on the audio amp on entry, but
    doesn't turn it off again on exit, which can result in some
    minor power wasteage.
    [app-geiger.c]
2019-07-10 remove pingdump, fix off by 1 bug in cmdconfig
    [cmd-config.c]
2019-07-11 Everything up to the COMBAT screen is now working.
    We're not drawing ships yet on that screen (will do tomorrow) but our
    clocks work, the VS ship selection is functional, and moving to the
    correct map is working. The attacker is in charge of what map we land
    on to prevent players being split between maps and proper maps are
    being drawn.
    Initial combat screen is drawn correctly as well. Nearly there.
    [app-battle.c, ides_gfx.c]
2019-07-11 Minor tweaks
    - Fix formatting nits (the hell was up with all those tabs in main.c?)
    - Avoid using "bool" as the in_combat data type for two reasons:
    1) "bool" may be represented as an int, which is 4 bytes, and we
    want to keep the data in advertising packets small.
    2) "bool" could be represented in an Implementation Defined (tm)
    fashion, which is not a good idea for data structures sent
    over the air/network. We should use an explicitly sized type
    instead.
    So in_combat is now a uint8_t instead. This should not affect
    any functionality.
    [ble_gap_lld.c, ble_gap_lld.h, ble_lld.h, main.c]
2019-07-11 Fix compiler warnings about type-punning.
    [app-battle.c]
2019-07-12 Fix a bug in the radio driver
    The frequency selection logic was a little broken. I must have been
    tired when I was writing it.
    [ides_gfx.h, nrf52radio_lld.c]
2019-07-12 fix duplicate battle states list
    [battle_states.h]
2019-07-13 Both ships now moving around on screen! woohoo!
    fix get enemy bug if coming from app-notify
    fix x/y bug
    fix config storage bug (i.e. don't store last x/y if the x/y is from the combat screen, which is wrong.)
    add show_results state (currently always shows tie for now)
    fix combat to properly clean up BLE connections on state exit
    [app-battle.c, enemy.c, statemachine.h]
2019-07-14 Off-by-one fixes:
    Fix error in randuint16, wasn't getting two bytes.
    Fix error in safe_start - we were looking for 30 positions when we
    only had 28. This often returned 0,0 as a starting position which
    is bad.
    Bump config version to wipe out bad points.
    Fix font on app-notify to match our default font, Futura
    Attempt to reset timer to sync game. It's not working right though.
    Might have to use one badge as master clock.
    [app-battle.c, app-notify.c, rand.c, userconfig.c, userconfig.h]
2019-07-14 Fix a uGFX event processing issue
    We only preserve one uGFX event when the uGFX orchard callback is called.
    But there are some instances where two events may be generated in rapid
    succession by the gtimer thread, and it has higher priority that the
    app thread. This means that sometimes an event can be delivered, then
    overwritten with another event before the app gets a chance to process
    it.
    To avoid this race condition, we suspend the thread that calls the
    orchard uGFX callback routine until the app has a chance to process
    the event.
    [gfxconf.h, orchard-app.c]
2019-07-14 Add touch events to the sea battle app
    Allow screen taps to trigger battle engagements and ship selections.
    This basically allows the screen to do what keyBSelect does (which
    is handy since my proto boards don't have a B joypad).
2019-07-14 fix the oob issue in movement, fix in combat issue where we would store the wrong last x/y
    [app-battle.c]
2019-07-14 add prototype
2019-07-15 Add an alternate USB provisioning script
    This script is similar to the other, except it obtains the
    Nordic nRF52840 device ID and uses that as the serial number
    string. Each chip has a unique ID, which saves us from having
    to invent a new one.
2019-07-15 Bullets can be fired now! Bullet position is reasonably accurate based on ship starting point and velocity, and shot range is taken into account.
    Collisions now work between ships and ships take damage.
    Network code for bullets and damage is not in this checkin (will
    handle that tomorrow)
    [app-battle.c, battle.h, entity.c, entity.h, ides_sprite.h, rand.c, ships.c, ships.h]
2019-07-15 Make PT Boat faster.
    Fix bullet range tracking - range start from origin not current
    player position
    Make COMBAT clock be a network clock - the master badge sends
    clock and controls game start/stop. Not independent clocks.
    This ensures proper game synchronization.
    Track shot timings - you can only fire when enough time has
    elapsed based on your ship type.
    Make bullet velocity be instant at time of fire (there is no
    VGOAL/ramp-up time)
    [app-battle.c, battle.h, entity.h, ships.c]
2019-07-16 Remember to sync our over-the-air state on exit
    When we leave the game, we're no longer in combat. We need to
    update the BLE game state that we advertise to match the new
    config state info.
    [app-battle.c]
2019-07-16 Add the ability to clone one device's firmware onto another
    Also, fix a bug in the update app. We really should turn off the MPU
    completely before trying to run the updater, in case it tries to
    re-use some RAM which was previously marked as protected.
    [app-otasend.c, app-update.c]
2019-07-16 handle null errors when dealing with bullets
    [app-battle.c]
2019-07-16 Fix sign issue on bullet create.
    [battle.h]
2019-07-17 Detect and print product info and serial number for SD cards.
2019-07-17 Display the station address correctly
    [app-info.c]
2019-07-17 Remember to reset internal state on exit
    "player," "current_enemy," "bullet[x]" and "last_near" need to be
    reset to NULL when exiting. player, current_enemy and bullet[x] are
    free()d, but that doesn't reset the pointers, and this is not UNIX,
    which means our context state is not entirely reset when we re-enter
    a task. We have to do it ourselves.
    This bug resulted in being unable to properly play a second game,
    as we still had a stale current_enemy pointer from the previous one.
    [app-battle.c]
2019-07-18 handle switching of sprite when l2cap msg comes in
2019-07-18 hopefully fixed fast sprite BG clear problem.
    [ides_sprite.c, ides_sprite.h]
2019-07-18 fix bg color merge
    [ides_sprite.c]
2019-07-18 update sprite lib to fix trail issue. Fix some starting points to be off the map.
    [app-battle.c, ides_sprite.c, ships.c]
2019-07-18 add first special for pt boat minor cmd-credits text cleanup fixup enemy struct for special tracking.
    [app-battle.c, battle.h, cmd-credits.c, ships.c, ships.h]
2019-07-18 Fix another stale comment.
    [ble_gap_lld.c]
2019-07-18 Move enemy definition to enemy.h
    Start in on support for some more specials
    Modify VS packets to send user's unlock status as well as ship status
    Modify all L2Cap packets to actually be bounded by 4-byte chunks. Fix padding.
    [app-battle.c, battle.h, enemy.c, enemy.h, entity.h, ships.h]
2019-07-19 Add variable bullet size per ship class and fix energy reporting on special usage.
    [app-battle.c, battle.h, enemy.c, enemy.h, ships.c, ships.h]
2019-07-19 use independent parts of the txbuf for the bullets to prevent race condition
    [app-battle.c, battle.h, ships.c, ships.h]
2019-07-19 bug fix in sprite library. adding sprite_fx.(c,h) which is not ready for production yet.
    [ides_sprite.c, ides_sprite.h, sprite_fx.c, sprite_fx.h]
2019-07-19 speed fixes and updates
    [app-battle.c, ides_gfx.c, ships.c]
2019-07-19 Revert the last change. Turns out it wasn't necessary.
    For the game code, we need the address of the transmitted buffer
    so that we can reclaim it. That's already in the evt structure.
    We don't need to copy the buffer contents again.
    [ble_l2cap_lld.c]
2019-07-19 fix typo in active setting for slab alloc
    [slaballoc.c]
2019-07-20 Fix bug in slab allocation routine.
    Use assignment instead of equality test to set the active flag.
    [slaballoc.c]
2019-07-20 Special and levelling work:
    Fix levelling to not be stupid.
    Add 16bit random function for Teleport.
    Fix sub cloak to restore sprite if user elects to come out of cloak.
    Fix heals
    [app-battle.c, battle.h, cmd-credits.c, enemy.h, rand.c, rand.h, userconfig.c]
2019-07-20 Fix crash on exit in battle game
    We need to avoid drawing sprites after they've been destroyed.
    [app-battle.c]
2019-07-20 make battleship two shot instead of crazy aoe thing
    use the sprite lib instead of direct drawing for hits
    make sure master is only one who can end the game to prevent race
    condition
    [app-battle.c, battle.h, ships.c, ships.h]
2019-07-21 fix unlocks and physics engine - it was ignoring shiptable
    [app-battle.c, cmd-config.c, entity.c, entity.h, ships.c, ships.h, unlocks.h]
2019-07-21 finish all specials (woo hoo) and implement ship and land collisions
    [app-battle.c, battle.h, ships.c, ships.h, unlocks.h]
2019-07-21 memory leak and bug fixes in ides_sprite.c
    [ides_sprite.c, ides_sprite.h, sprite_fx.c, sprite_fx.h]
2019-07-21 mostly working specials code, fix merge error
    [app-battle.c, battle.h, entity.c, ides_sprite.c]
2019-07-21 Add buffering to the video player
    Testing with the production video card showed that video playback was
    unacceptably slow. Rewriting the video card with my FreeBSD machine
    yielded much better behavior with the same SD card hardware. I suspect
    that the data on the master image was written in a less linear fashion
    (meaning that files were not always written in nice successive streams
    of sectors on disk) which causes lots of seeking when reading back
    video files.
    We can't re-write all the SD cards though (it would take too long). So
    instead, the video player has been refactored to use more of our available
    RAM to buffer data from the SD card. We now read 4 video/audio chunks
    into RAM instead j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
    [video_lld.c, video_lld.h]
2019-07-22 Adjust the BLE gap connect parameters a little
    I'm hoping this will improve connection reliability a little.
    At worst, it doesn't seem to hurt anything.
    [ble_gap_lld.c]
2019-07-22 Fix a double-free bug in isp_shutdown()
    Destroying the world map also releases its memory. No need to do it
    a second time.
    [ides_sprite.c]
2019-07-22 Fix memory bugs
    In app-battle, remember to release the sprite holders for the
    player hit images.
    Also, in isp_get_spholder_from_file(), there is a double-free when
    the buffer allocated in this function is released. It may already
    be released by isp_buf_to_spholder(), so there's no point doing
    it again here.
    [app-battle.c, ides_sprite.c]
2019-07-22 Fix another bug
    When we close down the timer library, don't let state_combat_tick()
    try to call check_ship_collisions(). Previously we only prevented
    sprite redraws from happening, but check_ship_collisions() also
    looks at the sprites.
    [app-battle.c]
2019-07-22 Modify the peerlist behavior
    In very high density BLE environments, the peer list can fill up with
    non-badge devices, preventing two badges from seeing each other. To
    combat this, we now filter out any non-badge devices from the peer
    list. Also, the list size has been increased to 64.
    [ble_peer.c, ble_peer.h]
2019-07-22 Slab allocator fixes
    Actually initialize the slab allocator when we enter the battle app.
    Also, gracefully handle slab allocator errors.
    [app-battle.c]
2019-07-22 Fix another formatting glitch
    [ble_peer.h]
2019-07-22 Forgot to check in change to slaballoc.h.
    Add prototype for sl_init()
2019-07-22 Update chat app to filter peers
    Only allow peers to show up in the chat list if they're badges.
    We use the peerlist mechanism for this. This is to avoid being
    flooded with non-badge BLE peers in the list (who we can't chat
    with anyway).
    [app-chat.c]
2019-07-22 fix button colors on caesar app
    [app-caesar.c]
2019-07-22 bugfix: do not show radio signal loss in level up screen, change vs message
    [app-battle.c]
2019-07-22 Update provision scripts to set default USB power level
2019-07-22 Move the game app to the completed list.
    Only thing not done is BLE pin pairing, and that's not a feature
    we really needed anyway. Yay!
2019-07-22 fix name of ships to unlock
    [app-battle.c, app-unlock.c]
2019-07-23 re-enable map ping for production build, fix ship selection
    [app-battle.c]
2019-07-23 Fix bug in ugfxEvent handling
    The logic to prevent overlapped ugfxEvents from occurring wasn't
    quite right. Sometimes we wouldn't clear the pending status and
    uGFX events would stop. This should be fixed now.
    [orchard-app.c]
2019-07-23 re-enable the energy and led bars for hp
2019-07-23 Fix a problem with ship selection
    Due to incorrect selection of indexes, it was never possible for
    the battleship type to be allowed, even if you leveled up enough
    to unlock it.
    [app-battle.c]
2019-07-23 When calling ledSetPattern(), clear the LEDs if the current pattern is "off"
    When apps that frob the LEDs exit and the current LED pattern is
    "off," some LEDs may remain set until the next time the array is
    used. All those apps call ledSetPattern() on exit though, so if
    the current pattern is off, we should set all LEDs to 0 PWM.
    Closes #51
2019-07-23 Change rotate badge to rotate led sign -- closes #49
2019-07-23 Conditionalize a few debug printf()s.
2019-07-23 remove all printf's and place them under ifdef's for debugging
2019-07-24 Fix a bug when calculating initial hp
    When unlocks are enabled, we have to set player->unlocks first,
    then player->hp second, since the PLAYER_MAX_HP macro needs
    the unlocks to do its calculation.
    [app-battle.c]
2019-07-24 Fix ship selection. It was off-by-one.
    [app-battle.c]
2019-07-24 Fix display for levelling up to level 11
    [userconfig.c]
2019-07-24 Fix some last minute bugs
    Make levelling up to WOPR actually work correctly.
    Correct level cap calculation
    Fix black badge config commands so that they can be enabled at
    runtime instead of at compile time.
    [app-battle.c, cmd-config.c, userconfig.h]
2019-07-25 Remove 'kickstarter' from the provisioning script - we're done with those boards.
2019-07-27 Add a Doomguy app
    This app just displays an animated Doomguy face on the screen.
    It will honor the screen rotation setting so that it displays
    correctly when the badge is hanging from your neck, like the
    LED sign app.
    [app-doomguy.c]
2019-07-28 Make thed LED off setting always force LEDs off
    In order to work around compatibility problems with certain Shitty
    Add-Ons that also use I2C bus address 0x50 (which conflicts with our
    LED control chip), we would like to fix it so that we can disable
    all I2C bus accesses. Turning the LEDs off helps, but that doesn't
    disable LEDs in all circumstances. The music app, geiger counter app
    and game app all try to frob the LEDs directly.
    To work around this, the "Off" setting now disables all I2C accesses
    by the LED code. If you boot with the LEDs in the Off position, this
    means the bootstrap messages will report that no LED controller is
    found, but changing the setting will result in a re-scan of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
    [app-setup.c, is31fl_lld.c, led.c]
2019-07-29 Revert last commit
    The previous commit didn't disable everything and I'm tired of trying
    to figure out the right way to manage this.
    [app-setup.c, is31fl_lld.c, led.c]
2019-07-29 Closes git issue #54.
    accidental update of name when changing sound options
    [cmd-config.c]
2019-07-30 Add the ability to disable all LEDs during boot
    A new unlock bit has been added which can be used to disable LEDs at
    boot. The bit is toggled by holding down joystick A while resetting
    or powering on the board. This prevents the LEDs from being used at
    all and keeps the I2C bus quiet so that we don't cause "smart"
    Shitty Add-Ons that also use I2C bus address 0x50 to crash.
    When the toggle is triggered, the board will emit three touch tones
    (1-2-3) to let the user know it took effect.
    Also, while I was here, I made the factory reset code play three tones
    as well (0-0-0) rather than trying to play the ping sound effect. We
    can't do that in configStart() because we haven't mounted the SD card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
    [main.c, unlocks.h, userconfig.c]
2019-07-30 Fix a possible race condition in the BLE geiger counter app
    Wait for the rxAction field to be reset to 0 by the counter thread
    before updating it again, otherwise a request from the app thread
    might be missed.
    On occasion, when programming badges, I found that sometimes the geiger
    counter app would not exit correctly (it was still sending packets but
    it would stop responding to events). I suspect the problem is that
    during exit, setting rxAction to RX_ACTION_EXIT would sometimes get
    lost (the thread would overwrite rxAction with a 0 and we'd lose the
    event). Hopefully this won't happen anymore.
    [app-geiger.c]
2019-07-30 Update chat app a little
    Don't issue an L2CAP connect until the other side actually accepts
    the chat request. If the other side doesn't respond within 10 seconds,
    time out and exit the app.
    Closes #55
    [app-chat.c, orchard-app.c]
2019-08-12 Check in final provisioning script
    Now that DEF CON is over, we can publish the script containing the
    final set of unlock code and the unlock password. This is the script
    used to initialize all boards actually sold/distributed via Kickstarter,
    Stripe and on site at the con.
    The secret unlock password is "nucular". (<Homer>"Nucular, Lisa.
    Nucular."</Homer>)
